Gernreich/trumpet-elbows-allowed/ends/README.md

# The bell and the mouthpiece

<!-- page-only <div style="display:flex;flex-wrap:wrap;gap:12px"><iframe src="../parts/bell/bell-round10-153mm-17rings-x3-rim86-turn.html?embed" title="The bell, 17 laminated rings flaring from a square throat to a round rim, as a solid you can drag to turn" style="flex:1 1 300px;height:480px;border:0"></iframe><iframe src="../parts/mouthpiece/mouthpiece-bore10-trumpet-parts-turn.html?embed" title="The mouthpiece, a stack of laminated rings from the cup down to the square bore, as a solid you can drag to turn" style="flex:1 1 300px;height:480px;border:0"></iframe></div> -->

Neither end is touched by the way a bore turns, so **only the tube belongs to an
instrument**. Both ends are stacks of laminated 3 mm rings, glued, since a ring
stack cannot be press-fit; each is glued to its bore too. Both close onto the
same 10 mm square in a 16 mm face, and every bore in this repository is on that
channel — so one bell and one mouthpiece serve all of them.

<!-- readme-only -->
**[Read this page](https://gernreich.github.io/trumpet-elbows-allowed/ends/)**

Both live in `../parts/` rather than inside any one instrument's folder, because
neither belongs to a single bore: what cuts them is not what fits them.

## The bell

**17 rings of 9 mm, 153 mm tall, a 10 mm square throat opening to a ø86mm round
rim** — ø80 of air. The section morphs square to round on the way up while
holding area, so the bore never steps in cross-section even though the shape of
it changes completely.

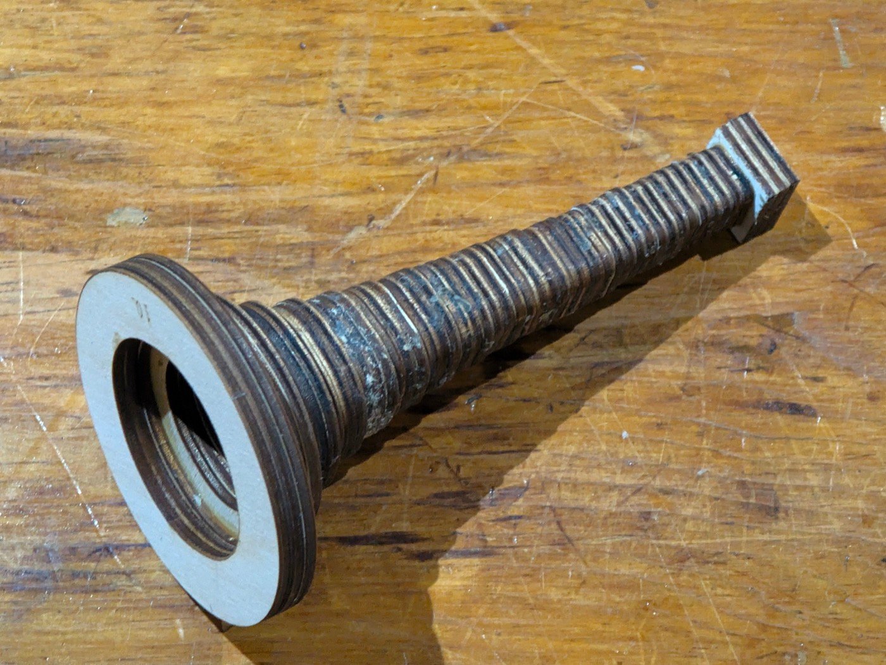
[picture p3: parts/bell/bell-round10-153mm-17rings-x3-rim86-built_web.jpg]
The bell as built, lying on a scratched workbench: a stack of laminated ply rings rising from a small square block at the throat, widening and rounding as it climbs to a flat round rim, every ring joint showing as a stripe up the side


That is the one on the instrument. The small square block is the throat — 10 mm
of air in a 16 mm face, which is a bore block exactly — and the flat disc is the
rim. Everything between them is the section changing from square to round while
holding area, three plies at a time.

**[Turn it →](../parts/bell/bell-round10-153mm-17rings-x3-rim86-turn.html)**
It turns at the top of the published page, and on a page of its own: drag to
rotate, and the slider stacks the rings one at a time, which is the useful part.

<figure>A 17-ring bell seen from above the rim: rings stacked and morphing from square at the throat to round at the rim, widening toward the viewer, the bore visible down the middle</figure>

Axial section of a 17-ring bell: the bore climbing one staircase and the outside another, wall between them

| | |
| --- | --- |
| rings | 17, each 3 laminations of 3 mm |
| height | 153 mm, built on a 152 mm profile |
| throat | 10 mm square |
| rim | ø86.0mm outside, ø80 of air |
| profile | Bessel horn, gamma 0.7 |
| sheet | 187 × 192 mm |
| pieces | 51 — the sheet goes through the machine three times |

**The bell is cut more than once.** The sheet draws every ring once, and the
`x3` in its filename is how many passes it takes. Cut it once and you get a
51 mm stub instead of a 153 mm bell.

Rings stack; they do not telescope. Each seats on the one below over 3.0 mm per
side. They are engraved in hex with `0` at the bore, and the generator writes
the numbering itself as the last step, with an orientation tick beside each
number — a numbering failure deletes the sheet rather than leaving an unnumbered
one to be cut.

```
cd parts/bell && ../../target/release/bell-round 17 --bore=10 --length=152 --mouth=80 \
    --out=cut-files/bell-round10-153mm-17rings-x3-rim86-cut-files.svg
```

A bare `bell-round.rs` writes four ring budgets, not one; the shipped sheet is
among them and comes back identical, the other three are scratch. Pass a budget
to write one.

### The adapter

A ported swept-curve bore leaves its cheek through a slot. Cut with `--port-square`,
as the built spiral was, that slot is a 10 mm square, the bell's own throat, and the
bell sits in it directly. Without it the port is **7 × 14 mm**, which cannot meet
this bell directly, and `bell-adapter.rs` draws the piece
that carries one into the other: **7 rings of one ply, 21 mm**, holding area
across the change on a smoothstep so both ends are tangent. The last ring is a
collar — 10 mm square in a 16 mm square face, which is the bore's own end face, so
the bell stacks on it unchanged.

```
cd parts/bell && ../../target/release/bell-adapter \
    --out=cut-files/bell-adapter-port7x14-to-bore10-7rings-x1-cut-files.svg
```

## The mouthpiece

**30 rings of 3 mm, 90 mm tall.** A 16 mm square plate at the instrument and a
ø23mm rim at the lip — ø17 where the lip actually sits — narrowing to a
**ø3.66mm throat** before the backbore. Full size on a quarter-size instrument,
which is the point of it.

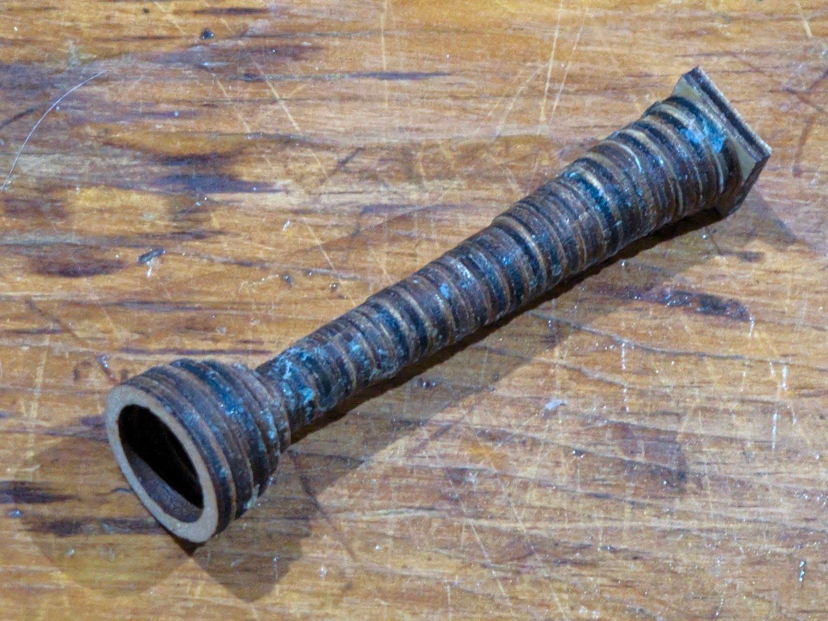
[picture p4: parts/mouthpiece/mouthpiece-bore10-trumpet-parts-built_web.jpg]
The mouthpiece as built, lying on a scratched workbench: a square block at one end, a long ring-stacked shaft narrowing to a waist, and a small cup opening at the other end, the ply laminations visible as rings along its whole length


The square block is what meets the bore; the cup is what meets the lip, and the
waist between them is the throat. **The staircase in that photograph is left as
it is.** Every ring is a 3 mm step, and the rim is the one part of the instrument
a player feels directly — this one meets a lip unsanded and unfilled.

**[Turn it →](../parts/mouthpiece/mouthpiece-bore10-trumpet-parts-turn.html)**
It turns at the top of the published page too, and on a page of its own the slider
stacks it a ring at a time.

<figure>The mouthpiece assembled from 30 rings, seen from above the cup: the cup narrowing to a throat, then the backbore opening slowly below it</figure>

Axial section of the 30-ring mouthpiece: the bore narrowing to the throat and opening again, the outside stepping the other way, wall between them

| | |
| --- | --- |
| rings | 30, each 1 lamination of 3 mm |
| height | 90 mm |
| layout | 26 backbore rings, 0 entrance rings, 4 bowl rings |
| at the instrument | 10 mm square aperture in a 16 mm square plate |
| throat | ø3.66mm |
| rim | ø23mm outside, ø17 at the lip |
| wall | 3 to 4.96 mm |
| sheet | 111 × 101 mm |
| pieces | 30 — one pass |

Station one is a **sharp** 10 mm square aperture in a **sharp** 16 mm square
plate, matching the bore corner for corner. The corners round away going up, and
the section is a true circle from the 9.026 mm station on, so the throat and the
whole cup are round.

```
cd parts/mouthpiece && ../../target/release/mouthpiece-round \
    cut-files/mouthpiece-bore10-trumpet-parts-cut-files.svg
```

**The staircase is not sanded or filled.** Thirty 3 mm rings make a 90 mm cone out
of thirty steps, and the lip is the one part of this instrument that can feel
every one of them — it is played that way, off the sheet and unfinished.

> The mouthpiece on the instrument that has been built is **24 rings, 72 mm** —
> not the 30 this sheet cuts. It is the instrument that is short, not the
> drawing.

## Every sheet is claimed

Both directories carry a `.repro` manifest naming the exact command that draws
each shipped SVG, checked by
[`repro-svg`](https://github.com/Gernreich/lasermade-tools/blob/main/src/bin/repro-svg.rs)
from lasermade-tools. It runs every command into a temp
path and compares the result byte for byte against the sheet on disk, so a sheet
the current code would not draw is caught rather than shipped. A sheet with no
command behind it is reported `UNCLAIMED`, which is why the manifest has to grow
whenever a drawing does.

## The bores these fit

**[the three-turn trumpet](../three-turn/)** — the one they are actually fitted
to — and the candidates:
**[the switchback trumpet](../switchback/)** · **[the greek spiral](../greek-spiral/)**,
plus every other bore in `../parts/bore/`, all of them on the same 10 mm channel.

## More, and licence

**[The trumpet writeup](https://gernreich.github.io/trumpet-elbows-allowed/)** — the idea, the notation, the gate, and the whole
library.

**[The rest of the build files](https://gernreich.github.io/lasermademusic.html)** — every
instrument, each with its own writeup.

Released under [CC0 1.0](../LICENSE).
