Gernreich/trumpet-elbows-allowed/greek-spiral/README.md

# The greek spiral

<!-- page-only <iframe src="../parts/bore/concept/walk/meander/greek-key/bore/bore.html?embed" title="The greek spiral bore: 68 blocks lying flat as a Greek key, winding in and back out beside itself, drawn as a chain of coloured blocks you can drag to turn" style="width:100%;height:560px;border:0"></iframe> -->

A trumpet bore drawn as a flat meander — the Greek key, wound in and brought
back out beside itself. **68 blocks, 1088 mm of centreline, one section, no
elbows and no contact.** It is the only lattice bore in this repository that
cuts as a single section — every other one splits into six, eight,
twenty-seven — because it is planar: there is nothing to fold, and no
section-to-section joint to seat square.

**It has been cut.** The bore is in ply and press-fit, not glued; neither end
is fitted yet, and it has not been blown.

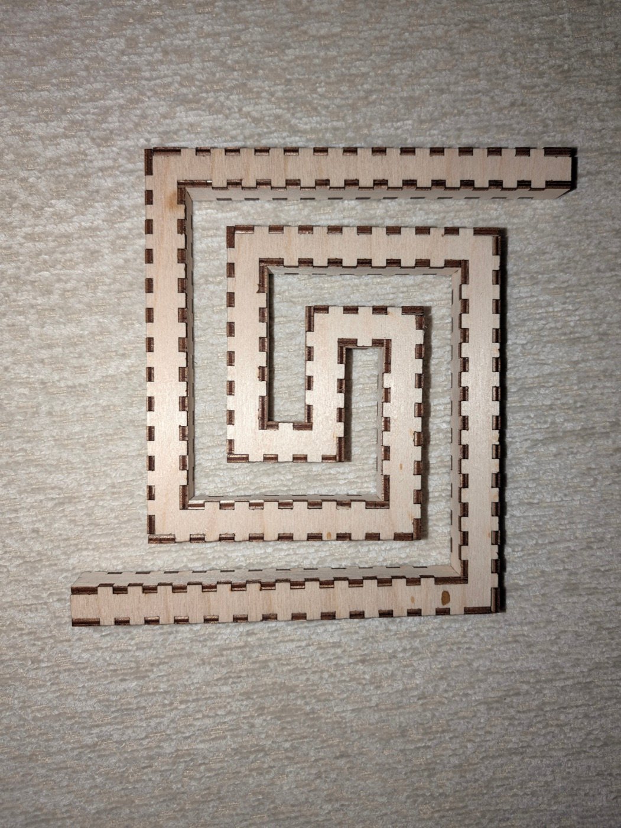
[picture p5: greek-spiral/greek-spiral-bore-built_web.jpg]
The greek spiral cut in birch ply and press-fit, lying flat: a square-section bore with its finger joints showing dark along every edge, winding in from the top right to a short bar at the centre and back out to the bottom left


<!-- readme-only -->
**[Read this page](https://gernreich.github.io/trumpet-elbows-allowed/greek-spiral/)**

**[Turn it →](../parts/bore/concept/walk/meander/greek-key/bore/bore.html)**
It turns at the top of the published page, and on a page of its own: drag to rotate, and
the slider reveals the bore a block at a time. Turn it edge-on and the whole
design is one block thick.

The walk laid out in Minecraft: sixty-eight translucent blocks lying flat as a Greek key, winding in to a short bar at the centre and coming back out beside itself, the runs coloured blue, purple, orange and green

*Screenshot from Minecraft. Minecraft is a trademark of Mojang Studios; this
project is not affiliated with Mojang or Microsoft.*

**The colours are the compass, not the cut order.** Everywhere else in this
project a coloured bore block says which section it belongs to; this bore has
only one section, so there is nothing for that to distinguish and the blocks are
coloured by the direction you are travelling instead — north, west, south, east.
Only four of the six appear, because the walk has no `U` and no `D` in it.

## The walk is the whole design

```
N10 W9 S6 E5 N2 W3 N2 E5 S6 W9 N10
```

The first term is the way you face at the mouth and how far you go before
anything turns; every term after it turns where you stand and then travels that
many blocks. So **the bore is 1 + the sum
of the numbers** — 67 + 1 = 68. Axes are Minecraft's: `U`/`D` are +Y/−Y, `N` is
−Z, `S` is +Z, `E` is +X, `W` is −X. There is no `U` or `D` in it at all, which
is the whole point: the walk never leaves its plane.

Read it out of `../tools/walks/greek_spiral.txt` rather than from here.

**It is a palindrome about its middle.** `N10 W9 S6 E5 N2` winds in, `W3` crosses
the centre, and `N2 E5 S6 W9 N10` comes back out — the same five legs in reverse.
That is what puts both openings on the outside of the figure rather than
stranding one of them at the eye, which is the failure a plain spiral has. It is
also what you are looking at in the pictures above: turned half a turn about the
middle of the short bar at its centre, the figure lands on itself, which is why
its two openings leave at opposite corners. It is not mirror-symmetric. The two
longest runs — the outer legs at either side — are the two `N10`.

## The numbers

| | |
| --- | --- |
| blocks | 68 |
| centreline | 1088 mm |
| sections | 1 |
| parts | 24, over 2 sheets |
| bounding box | 192 × 16 × 208 mm — 12 × 1 × 13 blocks |
| airway | 10 mm square, constant |
| block pitch | 16 mm — 10 mm of air in 3 mm walls |
| elbows | none; every turn is a bend |
| contact | none |
| legs | north 25, west 21, south 12, east 10 |

**A block is 16 mm, not 10.** Ten millimetres of sound space wrapped in 3 mm of
wall is 16 mm outside. A run of *N* blocks is 16*N* mm along the bore, which is
where 1088 comes from.

## One section is the whole design

Every other lattice bore here splits into several sections that couple
tab-into-notch. This one is planar, so it splits into one, and that changes
three things:

- **There is no assembly order.** Two sheets, one section. The `01of01` in the
  filename is not a sequence.
- **The seam clearance is inert.** The 0.025 mm per side that the 10 mm bore gets
  at a section joint has nothing to apply to here, because there is no
  section-to-section joint. Do not cite the switchback's measured play as
  evidence about this bore.
- **Both ends are plain**, not just one. On a one-piece bore the first piece's
  entry and the last piece's exit are the same piece, so it carries both marks
  and the filename says `-buttin-buttout-`.

A change that makes this design split into more than one section has changed the
walk, not the toolchain. Check the walk first.

**Nothing is engraved.** The other bores write a section number on every part in
blue before black cuts. Here the number would read `1` on all twenty-four parts
and answer a question nobody can ask, so black is the only colour on the sheet.
Marking each wall with its own length would name the stick and nothing else:
the plate carries no matching mark, and the one that would complete it cannot
be derived. The plate is the jig: a wall of length *L* fits only the
run of length *L*.

## Two sheets, and one of them nearly fills the bed

| sheet | parts | size |
| --- | --- | --- |
| 1 of 2 | 13 | 592.0 × 284.4 mm |
| 2 of 2 | 11 | 539.8 × 92.5 mm |

Sheet 1 is **1684cm²**, second by area only to the closed 52-block loop's
1778cm² sheet, with 8.0 mm to spare on a
600 mm bed. It is not the widest — the double volute's narrow panels reach 598.9 mm, and
width is what runs out first. The gate's
`sheet fits the bed` check passes everything up to 600.0, and the nester may
split differently rather than failing, so compare the reported sheet sizes after
any change and do not assume two sheets stays two.

## The cut files

In `../parts/bore/concept/walk/meander/greek-key/bore/cut-files/`,
both named for the same single section:

```
bore10-meander-greek-key-01of01-bend-DDDDDDDDDDLLLLLLLLLUUUUUURRRRRDDLLLDDRRRRRUUUUUULLLLLLLLLDDDDDDDDDD-buttin-buttout-cut-files-sheet1.svg
bore10-meander-greek-key-01of01-bend-DDDDDDDDDDLLLLLLLLLUUUUUURRRRRDDLLLDDRRRRRUUUUUULLLLLLLLLDDDDDDDDDD-buttin-buttout-cut-files-sheet2.svg
```

The long middle is the flattened shape of the whole snake — sixty-eight letters
of `D`, `L`, `U` and `R` saying which way the plate turns at each block, with
`~a~b` collapsed into the `-buttin-buttout-` that says both ends are plain.
Every file is millimetre-true at 1 user unit = 1 mm.

## Rebuild it

The generator is `bore_split`, which `cargo build --release` at the repository
root builds into `target/release/`; both commands run from the repository root.
Report only, writing nothing:

```
target/release/bore_split "N10 W9 S6 E5 N2 W3 N2 E5 S6 W9 N10" --bore=10 --no-write
```

Writing rewrites both sheets and gates them:

```
cd tools && ../target/release/bore_split \
    walks/greek_spiral.txt --bore=10 \
    --write ../parts/bore/concept/walk/meander/greek-key/bore
```

This walk is in the regression corpus — `regress` names it *greek spiral* and
gates it at `--bore=10` on every toolchain change, so a change that broke it
would be caught.

## The two ends

Only the tube belongs to an instrument. Neither the mouthpiece nor the bell is
touched by the way a bore turns, and every bore here is on the same 10 mm
channel, so one of each serves all of them —
**[the bell and the mouthpiece](../ends/)**.

## More, and licence

**[The three-turn trumpet](../three-turn/)** — the bore that plays, press-fit
and blown, rather than a candidate.

**[The trumpet writeup](https://gernreich.github.io/trumpet-elbows-allowed/)** — the idea, the notation, the gate, and the whole
library.

**[The rest of the build files](https://gernreich.github.io/lasermademusic.html)** — every
instrument, each with its own writeup.

Released under [CC0 1.0](../LICENSE).
