Gernreich/trumpet-elbows-allowed/bores/coiled/README.md

# Coiled trumpet

A trumpet bore in 10 × 10mm square section that **coils flat and drops twice**, built from
eight box sections with **no elbows at all** — every turn happens inside a section, so
every joint is a flat face glued to a flat face. Companion to the
[octagonal trumpet](https://github.com/Gernreich/trumpet/tree/main/octagonal) and the
[octagonal torus](https://github.com/Gernreich/trumpet/tree/main/octagonal), which stayed on
the 25 × 25mm channel this bore was first cut at. Cut from 3mm Baltic birch plywood,
millimetre-true at
`1 user unit = 1mm`, so it prints and cuts at real size.

The **bell** and the **mouthpiece** live in
**[trumpet-parts](https://github.com/Gernreich/trumpet/tree/main/parts)**, shared with the
[octagonal trumpet](https://github.com/Gernreich/trumpet/tree/main/octagonal). Neither is touched by
the way the bore turns, so only the tube belongs to an instrument.

The bore was designed **in Minecraft**, laid out block by block and coloured by direction —
which is where the notation comes from, and why the axes match the game's: `U`/`D` up and
down, `N` away from the noon sun, `E`/`W` along the sunrise.

<p>
The bore built in Minecraft from translucent coloured glass blocks, each run a different colour: long blue runs heading north, a green run east, an orange run south, purple runs west, and short grey and red columns where the bore drops and climbs
</p>

*The same walk, built in glass. Each colour is one direction, the same palette the viewer
uses — so a run's colour tells you which way it goes.*

<p>
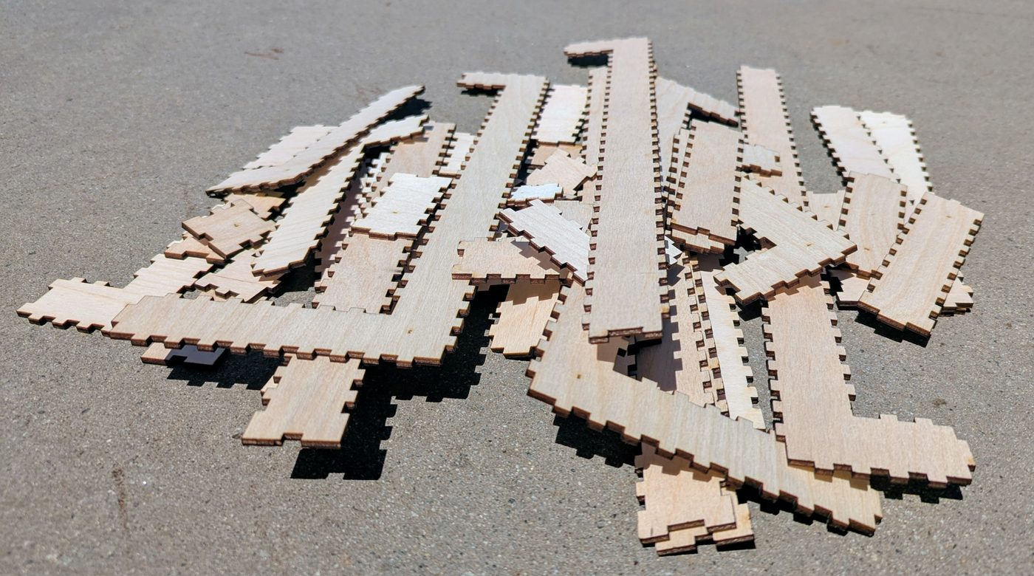
[picture p8: bores/coiled/bore/trumpet-coiled_parts_web.jpg]
The cut bore parts loose on concrete in sunlight: fifty flat plywood plates, every edge combed with finger joints, most of them long straight strips and several stepped into L and Z shapes where a section turns

</p>

*The whole bore, cut and not yet glued — 50 plates across 8 sections. **This photograph is
of the 25mm build**, which is what was cut before the bore moved to 10mm on 2026-09-05; the
shapes are the same and the plates are the size the old block gave. Click it for the
full-size photograph. **Every edge is a
finger joint and every face is flat.** The stepped pieces are where the bore turns: a
section carries its own corner, so nothing here is an elbow.*

<!-- readme-only -->
**[Read the writeup](https://gernreich.github.io/trumpet/bores/coiled/)** — the same text as
this page, set for reading, with a table of contents.

**[Turn the bore around in your browser](bore/bore.html)** — drag to rotate,
colour it by direction or by section, and step through the blocks one at a time.

Built for **[LaserMadeMusic](https://www.youtube.com/@LaserMadeMusic)**, where the cutting
and the playing are shown.

**[Download the whole repository as a ZIP](https://github.com/Gernreich/trumpet/archive/refs/heads/main.zip)**
— every trumpet, not this one alone; the nine bore nets and the page they
regenerate from are under `bores/coiled/`. GitHub builds it from `main` on every push, so it is never out of date.

**[The rest of the build files](https://gernreich.github.io/)** — every instrument,
generator and tool, indexed.

## Why no elbows

An **elbow** is a single block that turns. It sounds like the cheap way to bend a bore and
it is the expensive one, because its opening frame has **three sides, not four**. The
missing side has to be made up by the sections either side of it: both get a flattened
plate to butt-glue against, both need a tongue to locate on, and a 3 × 3 × 25mm void is
left unfilled inside the corner. Flat-to-flat gluing is the whole difficulty of building
one of these, and every elbow adds three more of the worst kind.

Turning the bore *inside* a section costs nothing extra to cut and glues like any other
seam. So this design pays in blocks to buy zero elbows — and the price turns out to be
small.

## The design is one line

```
N N3 U6 W5 N10 E5 D3 S8 W3 D3 N12 N
```

The first letter is the way in, the last is the way out, and each term between them turns
where you stand and then travels *n* blocks. The bore is **1 + the sum of the numbers** —
59 blocks, 944mm of centreline.

That single line is the entire specification. It is stored in the viewer page, and the cut
files regenerate from it.

## One block is 16mm, not 10

A block is 10 × 10 × 10mm of sound space wrapped in **3mm of wall**, so its outside is
16mm. Coring it out for the bore to pass through does not shrink it — the four walls stay
and the block still takes up 16mm. **A run of N blocks is 16N mm long.**

## When a turn is free, and when it costs

A section can carry a turn internally only if it has a straight block on each side of the
corner that its neighbours have not claimed. That gives one rule, and it has to be checked
over **every window of three consecutive terms**:

> Take the window as outer *A*, middle *m*, outer *C*. If *A* and *C* run along the **same
> axis in the same direction** the turn is a **step** and *m* may be **1**. If they run
> along the **same axis opposed**, it is a **hairpin** and *m* must be **2 or more**. If
> they name **three different axes**, it is a **coil** and *m* must be **3 or more**.

Steps are free, hairpins nearly so, coils are not. The moment a third axis joins in the
middle leg needs three blocks — one arm each side and the corner between them.

This document said until 2026-08-29 that any window on only two axes was "a fold" costing
nothing at any spacing. That holds for a step but not for a hairpin: `U3 N1 D3` buys two
elbows where `U3 N2 D3` buys none. It makes no difference to the walk below, whose only
two-axis window is a hairpin around a leg of ten, but it would to a tighter one.

For this walk:

| window | axes | verdict |
| --- | --- | --- |
| `N3 U6 W5` | three | middle 6 — fine |
| `U6 W5 N10` | three | middle 5 — fine |
| `W5 N10 E5` | two, opposed | hairpin, middle 10 — fine |
| `N10 E5 D3` | three | middle 5 — fine |
| `E5 D3 S8` | three | middle 3 — the minimum |
| `D3 S8 W3` | three | middle 8 — fine |
| `S8 W3 D3` | three | middle 3 — the minimum |
| `W3 D3 N12` | three | middle 3 — the minimum |

Three legs sit exactly on the floor of 3. Shorten any of them and an elbow appears.

## The sections

Eight sections, cut as nine files — section 3 does not fit one sheet of the bed and comes
as two.

| # | blocks | in → out | plate | parts | sheet |
| ---: | --- | --- | --- | ---: | --- |
| 1 | 1–5 | N → U | 2 × 4 bl | 6 | 521 × 151mm |
| 2 | 6–11 | U → W | 2 × 5 bl | 6 | 583 × 182mm |
| 3 | 12–26 | W → E | 4 × 11 bl | 8 | 482 × 288 + 556 × 96mm |
| 4 | 27–31 | E → D | 4 × 2 bl | 6 | 498 × 127mm |
| 5 | 32–34 | D → S | 2 × 2 bl | 6 | 403 × 86mm |
| 6 | 35–42 | S → W | 2 × 7 bl | 6 | 505 × 285mm |
| 7 | 43–45 | W → D | 2 × 2 bl | 6 | 403 × 86mm |
| 8 | 46–59 | D → N | 2 × 13 bl | 6 | 522 × 247mm |

**50 flat parts**, every one engraved with its section number, because the sections only go
together in one order. Sheets are sized for a 600 × 308mm bed.

The section names describe the shape as a run of moves across the flat plate —
`08_bend_LDDDDDDDDDDDD` is one step left and then twelve down — so a file name and
the part it cuts are the same description.

## Cutting

**Colour is the cut order**, shared across all these repositories: **blue engraves, black
cuts.** Blue lays the section number onto every part first and black frees it. Nothing
here uses the middle stages.

Standard settings, and they must stay uniform across the set — mixing `burn` changes finger
joint fit while every outside dimension still matches, which no drawing shows:

```
blocksize 16mm   thickness 3mm   burn 0.1   spacing 0.5   inner corners: corner
```

## Regenerating

The walk lives in the viewer page, so the page is a complete record of the design and the
cut files come back from it alone:

```sh
cd ../../tools
python3 bore_split.py ./bore/bore.html \
    --write ./bore
```

That rewrites every file in this directory and runs the full gate as it goes — 253 checks
on this design, none failing. To try a change without writing anything:

```sh
python3 bore_split.py --no-write "N N3 U6 W5 N10 E5 D3 S8 W3 D3 N12 N"
```

The generator is [bore-generator](https://github.com/Gernreich/trumpet/tree/main/tools), which
builds the nets on top of **boxes.py** (Florian Festi, GPL 3.0,
<https://www.festi.info/boxes.py/>).

## Files

**The bore**, in `bore/` — eight nets, one per section:
`bore10-coiled-01of08-bend-DDDR-buttin-cut-files.svg`,
`bore10-coiled-02of08-bend-UUUUL-cut-files.svg`,
`bore10-coiled-03of08-bend-LLLDDDDDDDDDDR-cut-files.svg`,
`bore10-coiled-04of08-bend-RRRD-cut-files.svg`,
`bore10-coiled-05of08-bend-LU-cut-files.svg`,
`bore10-coiled-06of08-bend-UUUUUUL-cut-files.svg`,
`bore10-coiled-07of08-bend-LD-cut-files.svg`,
`bore10-coiled-08of08-bend-LDDDDDDDDDDDD-buttout-cut-files.svg`.
At 25mm the third section needed two sheets and there were nine; at 10mm it fits on one.
`bore.html` sits beside them and holds the walk they are generated from.

The bell, the mouthpiece and their section drawings are in
[trumpet-parts](https://github.com/Gernreich/trumpet/tree/main/parts).

Released under [CC0 1.0](LICENSE).

Bore nets are generated by
[bore-generator](https://github.com/Gernreich/trumpet/tree/main/tools) on top of
**[boxes.py](https://www.festi.info/boxes.py/)** by **Florian Festi** (GPL 3.0),
`burn=0.1`, blocksize 16mm. The bells, the mouthpiece and the text are CC0.
