Gernreich/trumpet-elbows-allowed/parts/bore/concept/README.md

# Bore designs

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

<!-- readme-only -->
**[Read the writeup](https://gernreich.github.io/trumpet/parts/bore/concept/)** — the same text as this
page, set for reading, with a table of contents.

**[The rest of the build files](https://gernreich.github.io/)** — every instrument,
generator and tool, indexed.

Built for **[LaserMadeMusic](https://www.youtube.com/@LaserMadeMusic)**, where the cutting
and the playing are shown.

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

**The bore being built is the coiled trumpet:**
`N N3 U6 W5 N10 E5 D3 S8 W3 D3 N12 N` — 59 blocks, 944mm,
8 sections, **no elbows anywhere**. Its cut files and writeup are in
[trumpet-coiled](https://github.com/Gernreich/trumpet/tree/main/parts/bore/concept/walk/no-elbows/coiled). Everything below is how
that design was arrived at, starting from a first trumpet that used elbows and worked out
what they cost.

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

The walk it is all built from, and [the bore to turn around](walk/elbows/first_trumpet/first_trumpet.html):

```sh
cd ../../../GIT/bore-generator
W="N N10 U2 W2 S7 U2 E4 N9 W2 D2 N4 N"

python3 bore_split.py --write walk/elbows/first_trumpet "$W"   # the eight sections
python3 nest.py "$W" --out nest.svg                # the same parts nested
python3 nest.py "$W" --deepnest dn.svg             # for Deepnest/SVGnest
python3 bore_render.py "$W"                                   # the 3D view
python3 check.py "$W" --files walk/elbows/first_trumpet        # cut nothing until it passes
```

## The first trumpet bore

The design this all started from, and **not** the one being built — it turns with elbows,
which is what the rest of this page goes on to price. Compare it against the
[coiled trumpet](walk/no-elbows/coiled), which does the same job with none.

[`N N10 U2 W2 S7 U2 E4 N9 W2 D2 N4 N`](walk/elbows/first_trumpet/first_trumpet.html) — 45 blocks,
720mm of centreline. **Every walk on this page is a link**: follow one and the bore
opens in a page you can turn around with the mouse, colour by direction or by section,
and step through block by block.

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

## When a turn costs a section

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

Everything about how a design splits follows from that.

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

| walk | axes | cost |
| --- | --- | --- |
| `N N3 U1 N3 U1 N3 N` | y and z only | 1 section, 0 elbows |
| `N N3 U2 N3 U2 N3 N` | y and z only | 1 section, 0 elbows |
| `N N3 U3 N3 U3 N3 N` | y and z only | 1 section, 0 elbows |

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

| walk | axes | cost |
| --- | --- | --- |
| `N N3 U1 E3 U1 S3 S` | all three axes | 7 sections, 4 elbows |
| `N N3 U2 E3 U2 S3 S` | all three axes | 5 sections, 2 elbows |
| `N N3 U3 E3 U3 S3 S` | all three axes | 3 sections, 0 elbows |

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

| walk | pieces | elbows | blocks | parts |
| --- | --- | ---: | ---: | ---: |
| `N N4 U1 E4 E` | straight, elbow, elbow, straight | 2 | 10 | 16 |
| `N N4 U2 E4 E` | straight, elbow, L | 1 | 11 | 14 |
| `N N4 U3 E4 E` | L, L | 0 | 12 | 12 |
| `N N4 U4 E4 E` | L, L | 0 | 13 | 12 |

### Writing it

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

| fragment | axes |
| --- | --- |
| `E E2 U3 S6` | east, up, south |
| `W W2 N3 E8` | west, north, east |
| `S S7 E3 U7` | south, east, up |

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

`E E1 U3 S1 S`

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

| fragment | why | cost |
| --- | --- | --- |
| `W W7 N2 U11` | x, z, y — all different | **1 elbow**, in every context |
| `W W7 N3 U11` | the middle widened to 3 | 0 elbows, two 11-block Ls |
| `U U3 W4 N2 E8` | two turns only | 0 elbows, the search has slack |

`W9 N2 U9` is the unlucky shape: both turns leave the plane, so they need an arm
each, and the two-block leg has one straight block to give. One turn takes it,
the other is left bare. The nine-block legs either side do not help - the
problem is between the turns, not outside them - and no context rescued it:
alone, mid-walk, with a turn before, with a turn after, always one elbow. `N3`
makes it two 11-block Ls for 31mm more bore.

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

| walk | what it is | cost |
| --- | --- | --- |
| `W W1 N2 E1 E` | the fragment on its own | one 5-block bend, no elbows |
| `U U4 W1 N2 E1 U4 U` | the same fragment in a walk | 7 sections, **4 elbows** |
| `U U4 W3 N2 E3 U4 U` | the two ones widened | 3 sections, no elbows |

The middle one costs four elbows because of the windows it forms, not the fragment:

| window | axes | middle | cost |
| --- | --- | ---: | --- |
| `U4 W1 N2` | three axes | 1 | an elbow |
| `W1 N2 E1` | a fold | 2 | fine |
| `N2 E1 U4` | three axes | 1 | an elbow |

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

| design | elbows | flats | tongues | voids | parts |
| --- | ---: | ---: | ---: | ---: | ---: |
| [first trumpet](walk/elbows/first_trumpet/first_trumpet.html) | 3 | 6 | 0 | 3 | 44 |
| [spiral trumpet](walk/elbows/spiral_trumpet/spiral_trumpet.html) | 3 | 5 | 1 | 2 | 68 |
| [telescope spiral](walk/elbows/telescope_spiral/telescope_spiral.html) | 11 | 18 | 2 | 9 | 106 |
| [wide telescope](walk/no-elbows/wide_telescope/wide_telescope.html) | **0** | 0 | 0 | 0 | 72 |
| [metre spring](walk/no-elbows/metre_spring/metre_spring.html) | **0** | 0 | 0 | 0 | 36 |
| [**coiled trumpet**](walk/no-elbows/coiled) — the one being built | **0** | 0 | 0 | 0 | 50 |

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

Two other ways a turn becomes an elbow:

* **A turn in the last block of the bore.** There is nothing after it to make
  it interior, so it is always its own piece. `N N5 U`
  is 6 blocks in **2** pieces; `N N5 U1 U` is 7
  blocks in **1**. One block further along the bore costs a file fewer.
* **A bed split** landing on a turn, if the piece would otherwise be too big.

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

## How big a piece can be

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

## What a walk is checked for

Four layers, and the first three are automatic:

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

### The build is the check; the notation is what goes wrong

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

*The [coiled trumpet](walk/no-elbows/coiled) as built, floating in open sky with
nothing else in frame. Every block is coloured by the way you travelled to reach it —
**N blue, S orange, E green, W purple, U red, D grey** — the same palette the viewer and
the renders use, so a build and a drawing can be compared at a glance.*

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

`N N3 U3 W5 N10 E5 S8 W3 S3 N12 N` is the example. It
was refused, and the build it came from was fine — the fault was a single letter in the
transcription, an `S3` where the build turned `D3`, and no amount of adjusting the
*lengths* fixed it because the fault was a direction. Read the walk back off the page
rather than off your memory of the build.

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

    cd ../../../tools
    python3 mcwalk.py "N N3 U3 W5 N10 E5 S8 W3 S3 N12 N" \
        --out /tmp/doubled_walk.html --title "..."

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

## Before cutting

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

## Turning one around

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

The direction colours are the ones the bore gets built in first:

    up     red        down   grey
    north  blue       south  orange
    east   green      west   purple

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

The stepped coil and the switchback ramp are worth reading together. The [stepped coil](walk/elbows/stepped_coil/stepped_coil.html) is
`U1 W1 S2 E2` six times over and costs 116 parts for 40 blocks; the
[switchback ramp](walk/no-elbows/switchback_ramp/switchback_ramp.html) is the same idea with every leg widened,
`U2 W3 S3 E3`, and costs 132 parts for 91. Same
family, less than half the parts per block, because a leg of one block forces
a standalone elbow and a leg of three does not.

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

    python3 viewer.py "<walk>" --out ../../../test<name>.html --title "<Name> Bore"

## A sheet for airtightness testing

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

## Loose pages

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

| walk | blocks | sections | elbows | why it is kept |
| --- | ---: | ---: | ---: | --- |
| `E E8 U3 S8 S` | 20 | 2 | 0 | the three-block minimum on its own: two long runs and the shortest leg that still turns without an elbow |
| `U U3 W3 N2 E1 E` | 10 | 2 | 0 | the smallest walk that ends on a single block, which is where the splitter used to strand a turn |
| [`U U1 W1 S2 E2` × 6](walk/elbows/stepped_coil/stepped_coil.html) | 40 | 26 | 18 | six loops marching diagonally, every leg as tight as it goes |
| [`U U2 W3 S3 E3` × 8](walk/no-elbows/switchback_ramp/switchback_ramp.html) | 91 | 17 | **0** | the same idea with every leg widened: eight hairpins climbing |
| [the tightest coil](walk/elbows/tightest_coil/tightest_coil.html) | 22 | 20 | 18 | single-block legs throughout — 20 sections for 22 blocks, the worst ratio here |
| a Hilbert cube with an eight-block riser | 138 | 48 | 24 | the densest walk here, with the exit taken up and clear of the cube |

The snorkel's walk is 60 terms and does not fit a table cell, so here it is
in full:

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

Released under [CC0 1.0](LICENSE).
