Gernreich/trumpet-elbows-allowed/tools/NOTES.md

# Bore toolchain notes

The reasoning, history and measurements behind the rules in `CLAUDE.md`,
which states them short. When the two disagree, fix both.

**Nothing here is cut at two pitches.** Every design is on the 16 mm block - 10 mm of
air inside 3 mm walls - so `regress` names one `coil fold2` design rather than two,
and `sizes` writes no page that is kept. Notes below about a design held at two
sizes describe machinery that still works and currently has nothing to show.

**A design naming a folder that is not there fails.** Without that it falls through to
a geometry-only run and still says pass, on a design whose sheets are not where it
says they are. `check`'s empty-folder guard cannot catch it, because that fires
on a folder which exists and is empty.

This file provides guidance to Claude Code (claude.ai/code) when working with code in this repository.

## What this is

The bore toolchain: a walk through a lattice of blocks goes in, per-piece laser
cut files come out, and every one of them is checked before you cut. Unlike its
sibling repositories this **is** a software project — it ships no cut files of
its own, only the thing that makes them.

It produces every bore under **`../parts/bore`**, all of them candidates, and one of the
two bores under **`../built`** — the three-turn trumpet's. The spiral beside it is a swept
curve and comes from `ribbon_bore.rs`. It depends on nothing in `octomino-snakes`, which
enumerated the 369 octominoes and is archived and private: a live instrument should not
need a frozen repository to rebuild its parts.

**The writeup is `README.md` at the repository root**, with a page each for the bores
beside it. It carries the geometry — why a stranded turn's opening frame has three sides, what a
lap closes, how the notation splits into pieces. This file covers only how to work on the
code.

## Where things are

The sources are flat in `tools/`, one level below the repository root. That is
deliberate: it puts them at the same depth `octomino-snakes/generator/` had, so every
relative path came across unchanged. They were Python scripts until 2026-11-08 and are the
`trumpet` crate now (`../Cargo.toml`), its programs built into `../target/release/`.

    ../parts/bore/concept   the design library - candidates, not instruments
    ../parts/bell           the two ends, shared by every bore
    ../parts/mouthpiece
    ../built                the instruments that exist, one folder each

`bore_split` given neither `--write DIR` nor `--no-write` writes to `../../test`, beside
the repository rather than in it; every real run names its folder.

## The dependency graph

    bore.rs       <- every program: the walk, the split, the sheets
    snakebox.rs   <- bore.rs, check.rs, piece_render.rs
    geom.rs       <- bore.rs, check.rs
    assemble.rs   <- check.rs
    check.rs      <- bore.rs (--write), check_main.rs
    viewer.rs     <- bore.rs (--write), viewer_main.rs, coils.rs, sizes.rs
    render.rs     <- bore_render_main.rs, mcwalk.rs, viewer.rs
    designs.rs    <- regress.rs, repro.rs

Until 2026-11-08 `snakeboxvar.py` was not standalone: it installed into a Boxes.py
checkout, which supplied the finger joints, burn compensation and SVG writer, and
`bore_split.py` shelled out to that checkout's `scripts/boxes` once per piece. A
second copy was installed there, and a gate had to ask whether the two still
matched. `snakebox.rs` is the generator and those parts of Boxes.py together, in
Rust, compiled into every program that draws: one copy, nothing installed, and the
paths it draws are the ones Boxes.py drew, to the byte, over 608 recorded calls,
with one deliberate change since ([The stub Boxes.py drew]).

**Boxes.py is Florian Festi's**, GPL-3.0-or-later, at
<https://github.com/florianfesti/boxes>.

**Four files here are GPL-3.0-or-later, not CC0**, and say so in a header:
`snakebox.rs`, a port of Boxes.py code and so derived from it, and `check.rs`,
`check_main.rs` and `piece_render.rs`, written against it (their Python had
imported SnakeBoxVar at module level). Boxes.py grants no linking exception, so a
program that links `snakebox.rs` is a GPL work as built, whatever its own sources
say. `LICENSE.GPL-3.0.txt` beside them is that licence; `LICENSE` is the CC0
covering everything else in this directory. A new file that ports Boxes.py code
joins the list -- give it the header.

Nothing this produces is affected: a cut file is geometry, carrying no Boxes.py
code or metadata, so the sheets stay CC0.

**There is one generator, and it is `SnakeBoxVar`.** The simpler `snakebox.py` — no
variable cell widths, no ports, no laps, no plain ends — is not part of this toolchain:
`snakebox.rs` ports only `SnakeBoxVar`, and `bore_split`, `check` and `piece_render` all
draw through it.

## The stub Boxes.py drew

`polygonWall` takes `thickness × tan(45°)`, 3 mm, off each edge that meets an
inside corner, and draws that 3 mm separately. A plain border 2 mm long, the
step beside a pin end or a turn's corner, has 2 − 3 = −1 mm left: the turtle
went back 1 mm, then forward 3. It ended at the right point, but the path
doubled back on itself, and the laser cut that 0.93 mm stub (after burn) as a
nick past the corner. There were 320 of them, two per face plate, on 103 live
sheets. SolidCraft's round trip found them on 2026-11-09: a solid cannot
carry a line of no width, so `sc-flatten` redrew every face plate of the
built coil without them and `sc-compare` showed 0.93 mm against the
committed sheets. Since 2026-11-09 such a border is drawn as one straight
line when it runs back more than 0.1 mm (`STUB`). The bar is not zero because a
border exactly as long as its allowance is common, and the SolidCraft design
fits each outline point as a linear function of the sizes by nudging them: a
rule that changed at zero put a kink there and stopped 19 of its 20 designs. The only change to each sheet is that stub's vertex, removed. The six
pinned `coil-10x10x30-1.5t/as-cut/` sheets keep their stubs, because the wood was cut that way.
Two sets `repro` does not redraw kept theirs until the full round trip of every
design found them the same evening: `square-rise3`'s four plate sheets (16), now
byte for byte what `bore_split` draws for its page's walk, and the tight coil's
bed sheet `bore10-coil-tight-sheet1of1.svg` (64), packed by the Python
bed_sheets before the port and not redrawn, since today's packing differs; only the stub
vertices were taken out of it. No other committed sheet runs back on itself.

## The switches must reach the gate

`--ports` and `--flat` were module globals in the Python, and run as a script
`bore_split.py` was `__main__` while `check.py`'s `import bore_split` loaded it a second
time with its own globals — so a switch set on `__main__` reached the writer and not the
gate, and `--ports --write` wrote ported cut files, gated the *unported* design, and
reported a clean run on parts nothing had looked at. In Rust every switch is a field of
the one `Design` the writer holds, and `--write` passes that same `Design` to the gate.
If another switch is added, put it on `Design`, and never let a code path reach the gate
with a fresh `Design::default()`.

**The bore's outer ends are plain.** `plain_ends()` always marks the first piece's entry
and the last piece's exit, not just the openings that meet a port. Nothing couples there —
the mouthpiece and the bell each seat a flat plate against the end face, and a proud tab holds
it off. It gives an end section its own shape where it would otherwise share one with an
inner section (`BDL` -> `BDL~a`, `01_bend_DL.svg` -> `01_bend_DL_buttin.svg`), and a
rename like that **orphans the old file**, which nothing deletes for you. `check_sheets`
then globs the folder and gates the orphan too, at three checks a sheet, so a folder with
stale files in it reports more checks than its design has. **A check count that rises
after a rename is a warning.**

**The tab is floored at the finger tooth, and the notch carries the play.** Both are
failures the gate cannot see. A `--pin_width` that scales with the block while the finger
teeth do not (Boxes.py sizes those at `2 x thickness`) puts a 4.8 mm seam tab against 6 mm
teeth at the 10 mm bore — the narrowest feature on the sheet, where it should be the
strongest. A `--pin_play` of 0 draws the notch exactly the tab's width, and section 1 will
not enter section 2. `pin_width()` floors at the tooth and caps at `MIN_SHOULDER`, and
`pin_play()` returns 0.025 per side out of `PLAY_BY_BORE`. Both are in
`Design.common`, so `check` sees the same geometry.

The gate did not catch either. Its floor is `MIN_FEATURE`, 1.5 mm, which 4.8 clears
comfortably, and nothing compares a feature against the other features beside it or checks
that a joint has any clearance at all. **A passing gate means no check failed, not that the
part is buildable.**

**`--play` overrides the table, and it is for measuring, not for cutting.** `PLAY_BY_BORE`
is a lookup of what has actually been cut — one row, 0.025 per side at the 10 mm bore — and
a bore that is not in it gets 0.025 too, the safe direction, saying on stderr that it is
guessing. The comment above the table sets out the coupon that would settle whether the
requirement is absolute or a fraction of the tab;
`--play` is what cuts it, at values nobody has measured, without editing the table to say
they have. Whatever fits, add the row and stop passing the flag.

It is the same hazard as `--blocksize` and it bit the same way: the generator's argument
list (`COMMON` in the Python, `Design.common` now) is built once, so `set_play()` has to
rebuild it. Until it did, the three coupons came out
byte-identical — which reads as *play makes no difference* and is really *the flag is not
connected*. The tell was that the difference should have been visible and exactly the play:
it is, now, at every notch edge of section 1, and section 2 does not move at all, because
the play comes off the notch and never off the tab.

`--blocksize` is the same hazard with a quieter failure. It is two numbers, not one:
`Design.block`, the pitch the plan is laid out on, and `--blocksize` in `Design.common`,
the pitch SnakeBox cuts to. Both come from `set_blocksize()`, and `common` is built by
`make_common()` from the fields rather than typed out, so there is one copy of that list
and not a second place to forget.

A design folder is usually just `bore/`, and may sit under a size folder as `<size>/bore/`
— so a page title climbs past any ancestor that only names a size or says "bore" until it
reaches one that names the design. `coil/fold2/bore` reads "Coil Fold2 Bore" rather
than "Bore", and would still read that under a `10mm/` level.

`check --files` never looks at the pitch: it checks the written sheets for bed fit,
overlaps and engraving on material, all of which a folder cut at one pitch passes when
the gate is told another.
The pitch decides the *geometry* half of the gate, which is recut in-process. Gate a folder
at the wrong blocksize and it reports its full check count and 0 failed on a design nobody cut.

## One viewer, one bore or several

`viewer::build_sets(&[(label, walk, data), ...], title)` is the only page builder. `build()` is it
with a single item, and a single item hides the selector, so a per-bore page is what it
always was. `sizes` passes two and writes one page holding a design at both the block
sizes it is cut at.

A gallery is **more sets in the same viewer**, not a second viewer: two templates drift,
and the drawing code is the part most easily got wrong.

Anything derived from `D` has to be rebuilt when the set changes — `occAll` and `centre`
both are, and a stale `occAll` hides faces the new set has no neighbour for. The switch
**keeps** the camera, which is the point of a switch: you are comparing two shapes, and you
cannot compare them if the view jumps every time you swap.

**The scale is locked to the biggest set, and the cells are drawn in millimetres.** Two
things have to be true before the comparison means anything:

- `data_for` emits **lattice** positions, because occupancy and adjacency need a lattice.
  If the pitch reaches the caption and nothing else, two different pitches draw as the
  same picture — literally the same, the two `cells` lists comparing equal. The data
  carries `u`, the millimetres per step, and `rotC` scales by it.
- A set that fits itself to the canvas normalises away exactly what a size control exists
  to show. `draw()` takes its **scale** from the reference set and its **position** from
  the set on screen, so the small one is small and still centred.

**Every page carries the mouthpiece and the bell** (2026-10-14). `ends_json()` reads
their ring stacks out of their cut files with `../parts/part-view.rs`, and the page
seats the mouthpiece on the IN face and the bell on the OUT face, each first ring flat
on the block's end and its axis along the face's outward normal — a rotation, never a
reflection. Their faces go into the same depth-sorted list as the blocks', and the fit,
the centre and the reference set's scale all include them while they are shown, so the
bell is never cut off. A button takes them off. Redrawing either part changes every
page, and the repro gates say so.

Together those make the smaller pitch draw smaller in exact proportion, and the ¾ coil at
just under half the 3-turn. Change one without the other and the page silently goes back to lying.

**`rot()` scales millimetres, so anything that is a direction must not go through it.**
`shade()` takes a face normal and its dot product with the light as a number in `[-1, 1]`.
Rotate that normal with `rot()` like a position and it is multiplied by the block size,
driving the dot product to ±16 and clamping every face to pure white or pure black. Use
`rotC(p, centre.c, 1)` for a direction. `regress` cannot see it — it gates geometry, and
a page whose every face is white is geometrically perfect. **Screenshot the page after any
change to the drawing code**; nothing that reads the file will catch this class.

## bore_split's guards

Twenty-two of them, each given inputs it should refuse. **Nearly all hold.** A
stray character, a walk that reverses instead of turning, a walk too short to
have a direction, a bare letter at either end -- the entry and exit headings the
notation used to carry -- a walk that revisits a cell, a run of zero length, a
one-cell piece that is not a cube, a notch narrower than its own play, a notch
that leaves no ply beside it, and, under `--refuse-elbows` only, a walk that strands a turn as a one-block piece
-- every one refuses, with a message naming the block or section at fault.

**A guard that does not fire has not been tested until you know your input
reached it.** Two of these are easy to probe wrongly: the notch guards sit behind
a code path a walk without a notched joint never reaches, and the stranded-turn
refusal needs `--refuse-elbows` and a walk that actually strands one — `N3 U1 E3` does.

**`--bore` and `--blocksize` are two spellings of one number** -- `set_bore()`
calls `set_blocksize(bore + 2t)` -- so the pair is refused unless the two agree.
Applied in order unconditionally, `--bore` would silently overwrite
`--blocksize`: `--bore=30 --blocksize=16` would cut 49 mm blocks and report them
as though asked for.

**Not guarded:** a run of absurd length (`N9999`) builds until it hangs
rather than refusing. Nothing guards the total block count.

## check, against artefacts it should reject

The method: hand the gate something wrong and see whether it says so.

**Effective.** *no two parts overlap* and *engraving on material* both fire when
one part is dragged on top of another. *bore volume matches the walk* is sound
by construction, and the comment above it says why: the expected volume is
computed here, from the walk, and must never be refactored to call
`bore_split.extent()`, because a check that shares its source with the thing it
checks is comparing something to itself.

**The folder is compared with the walk.** *the sheets are this walk's sections*
reads `-NNofMM-` out of every filename, and requires MM to be the section count
this walk splits into and NN to run 1..MM with none missing. Every other check
passes on a folder missing a sheet, and on a folder holding another coil's
sheets entirely; `seen > 0` catches only the empty one. In a repository whose
whole claim is that the cut file IS the design, that the sheets in front of you
belong to the bore you asked for is the thing the gate most needs to say.

**Untested this way**, and worth the same treatment before being trusted: the
checkers in `lasermade-tools` — `doc-audit` and `flat-part-check`
especially, since both are used to clear work for publication.

## The ply is 3.0 and the kerf 0.15

`SHEET` is 3.0 and `KERF` 0.15, matching `ribbon_bore.rs` in the swept-curve repository. `THICKNESS`
is 3.0 as well and is what dimensions the lattice; `SHEET` reaches only the slot
Boxes cuts for a sheet to pass through. They are two numbers that happen to
agree, so moving `SHEET` moves no airway.

**`KERF` here is the full width and `BURN` is the radius Boxes wants.** The
paragraph above the constant says so twice, in both directions, because the two
are easy to swap.

**An `old/` inside `cut-files/` is invisible to `repro`**, which lists `.svg`
and ignores directories, so a superseded sheet archived beside a design never
disturbs the gate. Every `old/` is gitignored: they sit on the working disk, a
fresh clone does not carry them, and no gate can see them.

**`coil-10x10x30-1.5t/as-cut/` holds the only sheets here that describe an object
rather than an intention.** Six pins in `as-built.sha256`; `repro` redraws every
`cut-files/`, that folder's included (since 2026-11-12), and holds these 6 frozen. Redrawing it SHOULD differ, and that
difference failing the gate is the entire point of the mechanism. Pinning a
redrawn sheet would claim it records wood when it does not.

## A page turns back into cut files

`walk_text()` reads the walk out of `<div class="walk">` and allows attributes on
it, because every page this repository writes emits `<div class="walk" id="walk">`.
That is the route the design notes describe — *the walk is stored in the
page … the cut files regenerate from it and nothing else*.

**One design has no other route.** `square-rise3` keeps its walk **only** in a
page: `regress`'s `DESIGNS` carries a walk as a string for every other
design, and it is also the one with `cut-files/` that no `DESIGNS` entry claims,
so `repro` does not look at it either. A break in the page route is invisible
everywhere except there. It used to be two; `flat-drop` was the other, and was
deleted 2026-09-14.

## Never regenerate what you cannot check

`regress` runs the full gate over every design in `walks/` and the design
library. It is the only reason any of this stays honest, it takes about four
minutes, and **it must pass before anything is pushed**:

```sh
../target/release/regress       # every design in DESIGNS
```

A change that alters cut geometry and still passes has not been proved right —
it has been proved not obviously wrong. Say which it is.

## Standing decisions

**Every turn folds into a bend wherever it can, at any cost in pieces.** An
elbow -- a turn stranded as its own one-block piece -- has an opening frame with
three sides rather than four, so both neighbours need flattened plates
butt-joined to it, plus tongues, plus an unfilled void in the corner. Flat-to-flat
joints are the difficulty of the whole build. `FOLD_TURNS` biases the split
toward folding and is always on, so a walk that splits bend-only in trumpet-elbows-not-allowed
splits identically here. Only a turn that cannot fold becomes an elbow.

**Elbows are allowed by default; `--refuse-elbows` turns the refusal back on.**
`REFUSE_ELBOWS` is False. With the switch, it raises before a single file is
written, naming the sections at fault, and exits 1 -- what trumpet-elbows-not-allowed says to the
same walk:

    error: --refuse-elbows: sections 2, 3 of 4 are elbows. Nothing written.
    Lengthen the term between the turns: a hairpin needs 2 and a coil 3.

It is one of the design switches, so `check`, `nest` and `regress`
accept it too -- but **`check` does not consult it**, and `regress` runs
`check`. The corpus mixes bend-only designs with designs that cut elbows --
the five restored on 2026-10-06, the helices, the solid corner walks, both coils,
both Hilbert cubes, corner to corner and the double spiral among the latter. **A
green `regress` is not evidence that a walk would be cuttable in trumpet-elbows-not-allowed**;
`--refuse-elbows` on the command line is.

**The piece kind is `elbow`** in the cut list, in file names (`-elbow-NE-`), in
`bore_render`, and in the field the coil search reads (`kinds.elbow`, kept
as `elbows` in `parts.json`). trumpet-elbows-not-allowed renamed it `stranded` on 2026-09-15; this
copy renamed it back, and checked that the search scripts count 3 in
`meander/first` rather than silently reading 0.

**Respelling them is not the fix either, and this was measured rather than
assumed.** Raising every interior term to its window minimum does make nine of
the twelve fold — but `helix, rise 1` and `helix, rise 2` both become
`N4 U3 E4 U3 S4 U3 W4 U3 N4`, the same walk, so two cases collapse into one;
`tightest coil` goes 22 blocks to 47 and is not tightest; `hilbert cube 1` goes
8 to 15 and a 2x2x2 needs unit steps, so it is not the cube. Their names are
their parameters. The tenth, `double spiral`, cannot be respelled at all — the
raised walk runs block 20 into block 10.

**The test bore was the exception and it has been respelled**, on 2026-09-15.
`U2 E2 S2 U2` stranded its middle turn; it is `U1 E3 S3 U1` now — nine blocks,
three bends, same shape, same piece count. Its name was never a parameter, so
nothing was lost. It also settles a second thing: `examples/.repro` drew
`U1 E2 S2 U3` under the same name, so two different nine-block walks were both
"the test bore". Both draw `U1 E3 S3 U1` now.

Probe the guard through the command line, never through the corpus:

    ../target/release/bore_split "N3 U1 E3" --no-write                  # 2 elbows, exits 0
    ../target/release/bore_split "N3 U1 E3" --no-write --refuse-elbows  # refuses, exits 1

The long ones are in the corpus for the opposite reason: `hilbert open` (190
blocks, 27 pieces), `metre spring`, `4 corners, flat` and the trumpet candidate
split bend-only at a size where a change that started stranding turns would show
up -- here as elbows in the cut list, and as a refusal under `--refuse-elbows`.

**What a turn costs is set by the window of three consecutive terms around it**,
outer A, middle m, outer C — checked over every window, not once per walk.
Consecutive terms are always on different axes, which leaves three cases:

| A and C | case | m must be |
| --- | --- | ---: |
| same axis, same direction | step | >= 1 |
| same axis, opposite direction | hairpin | >= 2 |
| different axes | coil | >= 3 |

Steps are free; hairpins are not — the distinction is the one most easily lost.
Probed with `--no-write`; every one that cuts elbows here is refused under
`--refuse-elbows`:

    N3 U1 N3   step      folds          N3 U1 E3   coil   2 elbows
    N3 U1 S3   hairpin   2 elbows       N3 U2 E3   coil   1 elbow
    N3 U2 S3   hairpin   folds          N3 U3 E3   coil   folds

`bore_split` is the authority on this, not this file and not a
reimplementation of the rule.

**A walk that revisits a cell is refused.** The cells are the air path, so a cell
filled twice is a junction with two ways out and no box section has an opening in
four sides. **Trust the build and suspect the transcription**: the design is laid
out in Minecraft floating in open space, where a section running into an earlier
one is plainly visible, so a refusal usually means the walk was written down
wrong — and a wrong direction before a wrong length. `mcwalk` draws a refused
walk under permissive rules and lights up every cell entered more than once,
which the ordinary viewer cannot do.

## Colour is the cut order

Shared across these repositories: **blue engraves, then green → orange → cyan →
black**; black frees the part; **violet `#8000ff` means skip**. Bore nets use two
stages — blue engraves the section number, black cuts.

## Cut files belong to the author

Output lands in other people's repositories. `--write` rewrites **every** file in
the directory it is given, so ask before pointing it at one that has cut files in
it, and never at a directory holding hand-nested or hand-edited work.

## Publishing

Pages deploys from `main` through `.github/workflows/pages.yml`, keyed per commit.
`index.html` is `README.md` rendered by `md2html` and committed, not built on the
server, so a stale `index.html` publishes stale content — regenerate it after editing the
README, and read the audit before pushing:

```sh
~/LaserMadeMusic/GIT/lasermade-tools/rebuild-page.sh ..          # the root README and its page
```
