Gernreich/trumpet-elbows-allowed/torus/Octagonal_Torus_Gold.md

# Octagonal_Torus — parametric, 90mm radius, 25 × 25mm cross-section

Complete record: the trigonometry, the generator, and the verified cut list.

**All dimensions are millimetres.**

**Worked example:** an octagonal torus with a 25.000 × 25.000mm square cross-section, outer octagon
at R 90, cut from 3mm Baltic birch plywood. Verified cut file: **[`BuildA1_90_25.svg`](BuildA1_90_25.svg)**,
reproduced end to end from Route A —
[note on the violet lines in it](#note--the-violet-lines).

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

**A drawing, not a photograph — and the uncut torus.** This is what the finished ring
measures out to: computed by [`torus-3d-view.js`](torus-3d-view.js) from the same three
numbers Part 11 takes, so it cannot drift from the geometry described here. It shows the
object assembled from [`BuildA1_90_25.svg`](BuildA1_90_25.svg) and stopped there. The
photograph still to come shows the next step, after the cut along the
[violet lines](#note--the-violet-lines) that turns it into the simple trumpet.

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

```
R_outer  >  (ring + 2 × thickness) × sec(180°/n)
```

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

```
node torus-geometry-diagram.js 90 25 3
                               │  │  └─ material thickness
                               │  └──── the ring you want, face to face
                               └─────── outer octagon radius, corner to centre
```

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

```
$ node torus-geometry-diagram.js 120 30 6
outer octagon  R 120      apothem 110.866   wall out to 116.866   (run 1)
inner octagon  R 81.034   apothem 74.866    wall out to 80.866    (run 2)
hole cutter    R 74.54    (run 3 — invert this disc)
ring           110.866 − 80.866 = 30
outside flats  233.731   bore flats 149.731
```

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

**It draws a picture; it does not make cut files.** For parts, use Route A.

---

# PART 0 — Build it

## Get the files

- **[`BuildA1_90_25.svg`](BuildA1_90_25.svg)** — the cut file. On GitHub use the ⤓ *Download raw
  file* button; clicking the name only previews it.
- **[The whole repository as a ZIP](https://github.com/Gernreich/trumpet/archive/refs/heads/main.zip)**
  — the cut file, this writeup, the diagram and the verification tools are under
  `torus/`; the trumpets are beside them.
- **[The torus directory](https://github.com/Gernreich/trumpet/tree/main/torus)** — every file named below lives here.

---

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

Assembled: **25.000mm radial × 25.000mm axial**, 172.298 across the flats outside, 110.298 bore.

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

## The video

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

## Route A — generate from scratch at boxes.hackerspace-bamberg.de

Three runs, because the plate hole and the inner panels come from **different radii**.

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

→ Keep **both discs** and all **8 panels**.

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

→ Keep the **8 panels** only. Discard its discs.

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

→ Keep **one disc**; it is the cutter for both plates. Discard everything else.

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

### How the inversion was done

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

Flipping a segment does two things at once, and Part 8 is about both:

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

**This process is demonstrated step by step in the [video](https://www.youtube.com/@LaserMadeMusic).**

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

### The three runs as links

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

### Why run 3 uses 56.446 and not 59.693

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

```
56.446  →  disc at apothem 52.149 / 55.149
invert  →  lands at 55.149 / 58.149   ✓ exactly where the hole belongs
```

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

## Route B — shortcut, cut the finished file

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

**Two things before you send it**, both immediately below: the violet lines are not part of
the torus, and the four cut colours have to run in the right order. Do those and the file cuts
as-is — no scaling, no kerf compensation, no edits.

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

### Note — the violet lines

**They are not part of the torus.** The file carries 24 violet paths alongside the 20 cut contours,
and they are all one family: **12 on each of the two plates**. Each is a single straight line from the hole edge out to the
rim — apothem 55.2 to 83.2 on the plates, whose fingers stand proud of that line, and 55.2 to 86.2
on the rings, which have none — so together they divide each wall into sixteen segments. None
overruns its octagon.

They are the optional cuts. Take them and the torus comes apart into sections, which is how you
reach the simple trumpet; the segments they define are also the patches for joining sections back
together. Turn one green to cut it, and leave the rest violet.

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

↩ [back to the top](#octagonaltorus--parametric-90mm-radius-25--25mm-cross-section)

## Colour is the cut order

**Violet `#8000ff` is skip — it is never cut.** Everything else is, and the colour says *when*:

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

All four are explicit stroke colours, so select-same-colour finds each group and a colour-keyed job
lists all four. **Violet is the fifth colour in the file and takes no operation at all**: those 64
lines are the optional cuts across the plate walls, twelve per plate, which this build
does not make. Marking them explicitly is the point, so "not cut" is a decision recorded in the
drawing rather than a colour someone forgot to map.

**Blue is the piece numbers, and it engraves.** Blue means *engrave* across these repositories and
never cuts. From 2026-09-03 every one of the eighteen pieces carries a hex number in blue, written
by `number_pieces.js`, because the outer panels differ by 1.758mm and the inner ones by the same,
and off the bed they are a pile of near-identical rectangles. Give blue a marking operation, or
leave it unmapped and lose nothing but the numbers.

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

Eight of the sixteen panels are nested in the middle of the plate and ring holes, where they would
otherwise be waste, and so are the two square patches. That is what forces the sequence: **cut a
part while its material is still held.** Cut the orange hole first and the whole centre drops away,
taking the uncut pieces on it with it — into the machine, if you are unlucky. Holes before rims for the same reason: once the black rim is
through, the plate is loose and anything still to be cut in it will move.

So set your laser to run **green → orange → cyan → black**, and give every one of those four a
cutting operation. Leave violet unmapped, or delete it. A job set up per-colour silently skips any
colour you leave unmapped, which is a hazard for the four and exactly what you want for the fifth.

`verify_torus.js` checks all of this. It prints the palette, marks each colour counted or ignored, lists
the four in order with what each one is, and fails loudly if a nested panel is scheduled after the
hole it sits in, or a hole after its rim. It also counts the skip lines per octagon and checks that
none runs past that octagon's outer edge, so the sixteen claimed above are read out of the file
rather than asserted here:

```
  CUT ORDER
    1. green  x8   panels nested in the plate holes — cut before the waste is freed
    2. orange x2   plate holes
    3. cyan   x8   panels on the open sheet
    4. black  x2   plate rims — frees the plates
    tightest nested piece to its hole: 1.095mm  (31.2 x 48.372 panel in plate 1) — kerf comes off both sides of that
    8 nested panels and 0 patches cut before their hole ✓   holes before rims ✓

  SKIP LINES  (violet — carried, not cut)
    plate 0: 12 line(s), apothem 55.249 … 83.407   edge at 86.25
    plate 1: 12 line(s), apothem 55.249 … 83.407   edge at 86.25
    none reaches past its octagon's outer edge ✓
    every plate carries the same 12 ✓
```

## Before cutting the full sheet

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

## Check before cutting

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

## Tooling

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

```
node verify_torus.js BuildA1_90_25.svg RunA2_R59Point693.svg
```

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

**On the HTML:** `Octagonal_Torus_Gold.html` is generated from this markdown by a converter kept
outside the repo, which inlines `torus-geometry-diagram.svg` so the page stays self-contained.
**The markdown is the source — edits made directly to the HTML are overwritten on the next run.**

```
node torus-geometry-diagram.js 90 25 3      # outer R, ring, thickness
```

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

Everything below is why.

---

# PART 1 — Octagon trigonometry

A regular octagon has two "radii" that people constantly confuse:

- **R** (circumradius) — centre to a **vertex**
- **a** (apothem) — centre to the middle of a **face**

They are locked by the half-angle **180°/8 = 22.5°**:

```
a    = R × cos(22.5°)              cos(22.5°) = 0.923880
R    = a × sec(22.5°)              sec(22.5°) = 1.082392
side = R × 2sin(22.5°)             2sin(22.5°) = 0.765367
side = a × 2tan(22.5°)             tan(22.5°) = 0.414214 = √2 − 1
```

Closed forms:

```
cos(22.5°) = √(2+√2) / 2 = 0.923880
sec(22.5°) = 2 / √(2+√2) = 1.082392
tan(22.5°) = √2 − 1      = 0.414214
```

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

---

# PART 2 — Nesting two octagons: the 1.0824 rule

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

```
gap = a_outer − a_inner = (R_outer − R_inner) × cos(22.5°)

ΔR / gap = sec(22.5°) = 1.082392
```

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

Two consequences that bite:

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

---

# PART 3 — Material: walls eat the gap

The octagons are *surfaces*. Material grows off them, and whether that costs you depends on
direction.

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

```
one wall intrudes  →  nominal gap = ring + wall = 25 + 3 = 28
R_inner = R_outer − nominal × sec(22.5°)
        = 90 − 28 × 1.082392
        = 90 − 30.307
        = 59.693mm
```

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

---

# PART 4 — The generator

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

Settings used:

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

---

# PART 5 — Mapping generator terms to the geometry

This is the join between Parts 1–3 and the tool, and it is exact:

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

```
R_inner = R_outer − (ring + thickness) × 1.082392
```

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

And the axial 25 is not luck — it is `h = 25` typed in, with `outside` unchecked.

---

# PART 6 — Panel widths, derived

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

```
side = 2 × a × tan(22.5°)

long  panel = side + t√2          + 2·burn
short panel = side + 2t·tan(22.5°) + 2·burn
```

With t = 3.0 and burn = 0.1:

```
t√2 + 2·burn          = 4.2426 + 0.2 = 4.443
2t·tan(22.5°) + 2·burn = 2.4853 + 0.2 = 2.685
difference             = t(2 − √2)    = 1.757
```

Check against every panel measured across all files:

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

```
4.4426 = 2.4853 + 1.9574     2.6853 = 2.4853 + 0.2000
```

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

## 6a. Why a panel looks too wide for its octagon

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

A face of the octagon has **two lengths**, because the wall is a trapezoid in plan:

```
at the bore,          apothem 55.149:  2 × 55.149 × tan(22.5°) = 45.687
at the wall's outside, apothem 58.149: 2 × 58.149 × tan(22.5°) = 48.172
difference = 2t·tan(22.5°)                                     =  2.485
```

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

## 6b. The corner lap

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

---

# PART 7 — Why a torus forces an inversion

RegularBox makes a **box**. A torus needs its two rims facing opposite ways:

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

---

# PART 8 — What inversion actually does

Two things at once, and they must be handled separately.

## 8a. It shifts the part ±3mm

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

## 8b. It flips the phase — and that is the part that must be right

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

### Reading the phase from a file

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

```
RunA2 disc — what the inner panels key to
  OUT[-22.8…-15.0] OUT[-14.9…-9.1] OUT[-9.0…-3.0] OUT[-2.9…2.9] OUT[3.0…9.0] …

BuildA1 plate hole
  in [-22.9…-15.0] in [-14.9…-9.1] in [-9.0…-3.0] in [-2.9…2.9] in [3.0…9.0] …
```

**Same intervals, opposite lines = complementary = the plate's tabs land in the panel's notches.**

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

### If the phase comes out wrong

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

---

# PART 9 — How everything was measured

Every number here was extracted from path coordinates, not from CAD readouts.

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

Five pitfalls cost real time and are worth recording:

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

Plus: `id="..."` contains the substring `d="..."`, so a naive regex will match it and parse
nonsense.

---

# PART 10 — File record

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

Nothing else in the repository is a part:

| file | what it is |
|---|---|
| `verify_torus.js` | checks a cut file end to end — see [Tooling](#tooling) |
| `torus-geometry-diagram.js` | draws the figure at the top, and prints the three radii |
| `torus-geometry-diagram.svg` | that figure, regenerated by the script — do not edit by hand |
| `torus-3quarter-view.svg` | drawing of the finished torus, standing in until the photograph exists |
| `torus-3d-view.js` | draws it, from `R_outer`, `S` and `t` — the same three numbers as Part 11 |
| `Octagonal_Torus_Gold.md` | this document, and the source the HTML is built from |
| `Octagonal_Torus_Gold.html` | the generated page — edits to it are overwritten |
| `README.md` · `index.html` | repository front page, and the redirect that serves it on Pages |
| `LICENSE` | CC0 1.0 |
| `.gitignore` | keeps `.DS_Store` and `*.tmp` out of the repository |

## Final verification, `BuildA1_90_25.svg`

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

```
ring    = 83.149 − 58.149 = 25.000 ✓
axial   = 31.200 − 3.1 − 3.1 = 25.000 ✓   (as-drawn; nominally 31.000 − 3.0 − 3.0)
outside = 2 × 86.149 = 172.298
bore    = 2 × 55.149 = 110.298
phase   = interval pattern complementary to RunA2's disc ✓
order   = nested panels before their hole, holes before rims ✓
holes   = one stitched contour per plate
```

---

# PART 11 — Another size

**Self-contained.** Everything you need is here; nothing above is required reading.

Pick three numbers:

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

For an octagon, `n = 8`.

## 1. Get your three radii

```
node torus-geometry-diagram.js <R_outer> <S> <t>
                               │         │   └─ material thickness
                               │         └───── the ring you want, face to face
                               └─────────────── outer octagon radius, corner to centre
```

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

It prints them, labelled by run. Worked through with this build's numbers:

```
$ node torus-geometry-diagram.js 90 25 3
outer octagon  R 90       apothem 83.149   wall out to 86.149   (run 1)
inner octagon  R 59.693   apothem 55.149   wall out to 58.149   (run 2)
hole cutter    R 56.446   (run 3 — invert this disc)
ring           83.149 − 58.149 = 25
outside flats  172.298   bore flats 110.298
```

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

Or compute them yourself:

```
R_inner = R_outer − (S + t) × sec(180°/n)      ← run 2
R_hole  = R_inner − t × sec(180°/n)            ← run 3
```

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

## 2. Generate three boxes.py runs

At **<https://boxes.hackerspace-bamberg.de/>**, generator **RegularBox**. Identical settings each
time except the radius:

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

## 3. Invert run 3's disc

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

## 4. Build the plates

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

## 5. Dry-fit before cutting the sheet

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

## Parts you end up with

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

### The two stiffening rings

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

## Three things that will bite you

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

---

# The two rules

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
