Gernreich/trumpet-elbows-allowed/designs/index.html

theme

# Bore designs

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

The rest of the build files (https://gernreich.github.io/) — every instrument, generator and tool, indexed.

Built for LaserMadeMusic (https://www.youtube.com/@LaserMadeMusic), where the cutting and the playing are shown.

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

The walk it is all built from, and the bore to turn around:

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

## The first trumpet bore

The design this all started from, and not the one being built — it turns with elbows, which is what the rest of this page goes on to price. Compare it against the coiled trumpet, which does the same job with none.

N N10 U2 W2 S7 U2 E4 N9 W2 D2 N4 N — 45 blocks, 720mm of centreline. Every walk on this page is a link: follow one and the bore opens in a page you can turn around with the mouse, colour by direction or by section, and step through block by block.

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

## When a turn costs a section

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

Everything about how a design splits follows from that.

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

### Writing it

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

fragment | axes
... E4 U3 S4 ... | east, up, south
... W4 N3 E6 ... | west, north, east
... S9 E3 U5 ... | south, east, up

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

E E1 U3 S1 S

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

fragment | why | cost
... W9 N2 U9 ... | x, z, y — all different | 1 elbow, in every context
... W9 N3 U9 ... | the middle widened to 3 | 0 elbows, two 11-block Ls
... U5 W4 N2 E6 ... | two turns only | 0 elbows, the search has slack

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

The middle one costs four elbows because of the windows it forms, not the fragment:

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

design | elbows | flats | tongues | voids | parts
first trumpet | 3 | 6 | 0 | 3 | 44
spiral trumpet | 3 | 5 | 1 | 2 | 68
telescope spiral | 11 | 18 | 2 | 9 | 106
hilbert snorkel | 24 | 26 | 20 | 4 | 260
wide telescope | 0 | 0 | 0 | 0 | 72
metre spring | 0 | 0 | 0 | 0 | 36
coiled trumpet — the one being built | 0 | 0 | 0 | 0 | 50

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

Two other ways a turn becomes an elbow:

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

## How big a piece can be

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

## What a walk is checked for

Four layers, and the first three are automatic:

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

### The build is the check; the notation is what goes wrong

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

The coiled trumpet bore built in Minecraft from coloured glass, floating in open sky: long blue runs heading north, an orange run south, green east, purple west, and short red and grey columns where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

The coiled trumpet as built, floating in open sky with nothing else in frame. Every block is coloured by the way you travelled to reach it — N blue, S orange, E green, W purple, U red, D grey — the same palette the viewer and the renders use, so a build and a drawing can be compared at a glance.

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

## Before cutting

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

## Turning one around

Every design folder carries a page you can turn around with the mouse, named for the folder - first_trumpet/first_trumpet.html, spiral_trumpet/spiral_trumpet.html and the rest. Walks with no cut files have a page of their own instead; they are listed under Loose pages. Open one in a browser; nothing is installed and nothing is fetched but the fonts. Drag to turn, scroll to zoom, right-drag to pan, colour by direction or by section, click a legend row to isolate it, and drag the slider to follow the bore from the mouthpiece a block at a time.

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

The direction colours are the ones the bore gets built in first:

up     red        down   grey
north  blue       south  orange
east   green      west   purple

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

The walks with no cut files sit loose in the repository root, listed under Loose pages below.

The stepped coil and the switchback ramp are worth reading together. The stepped coil is U1 W1 S2 E2 six times over and costs 116 parts for 40 blocks; the switchback ramp is the same idea with every leg widened, U2 W3 S3 E3, and costs 132 parts for 91. Same family, less than half the parts per block, because a leg of one block forces a standalone elbow and a leg of three does not.

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

python3 viewer.py "<walk>" --out ../test/<name>.html --title "<Name> Bore"

## A sheet for airtightness testing

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

## Loose pages

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

walk | blocks | sections | elbows | why it is kept
E E8 U3 S8 S | 20 | 2 | 0 | the three-block minimum on its own: two long runs and the shortest leg that still turns without an elbow
U U3 W3 N2 E1 E | 10 | 2 | 0 | the smallest walk that ends on a single block, which is where the splitter used to strand a turn
U U1 W1 S2 E2 × 6 | 40 | 26 | 18 | six loops marching diagonally, every leg as tight as it goes
U U2 W3 S3 E3 × 8 | 91 | 17 | 0 | the same idea with every leg widened: eight hairpins climbing
the tightest coil | 22 | 20 | 18 | single-block legs throughout — 20 sections for 22 blocks, the worst ratio here
a Hilbert cube with an eight-block riser | 138 | 48 | 24 | the densest walk here, with the exit taken up and clear of the cube

The snorkel's walk is 60 terms and does not fit a table cell; it is on its own page, and in full here:

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

Released under CC0 1.0.
