Gernreich/trumpet-elbows-allowed/parts/bore/concept/walk/coil/search/index.html

theme

# Spirals

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

The one this started from is coil_4x4_50, which won a category and lives in a directory of its own; the ten came out of an exhaustive search for something tighter.

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

Built for LaserMadeMusic (https://www.youtube.com/@LaserMadeMusic), where the cutting and the playing are shown.

## Standardised

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

Standardising collapsed 30 walks into 10: several that looked different were the same coil in another orientation, and derived.txt records which. The hand reduction of the staircase coil, the tool's reduction of it, and the extension of the hand reduction all turn out to be one coil.

### The length rule, and why it is not a cap

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

## Shape and cost

spiral | blocks | mm | envelope | box | cross-section | along axis | pieces | distinct | period | rhythm | mean plate mm2 | touching
coil_3x3_54_2 | 169 | 2704 | 3 x 3 x 43 | 387 | 3 x 3 blk / 48 x 48 mm | 43 / 688 mm | 28 | 4 | 8 tm / 22 blk | 4 x7.0 | 2601 | 0
coil_3x9_18 | 167 | 2672 | 3 x 9 x 15 | 405 | 3 x 9 blk / 48 x 144 mm | 15 / 240 mm | 29 | 4 | 8 tm / 22 blk | 4 x7.3 | 2477 | 12
coil_3x8_20 | 172 | 2752 | 3 x 8 x 17 | 408 | 3 x 8 blk / 48 x 128 mm | 17 / 272 mm | 33 | 4 | 8 tm / 20 blk | 4 x8.3 | 2205 | 14
coil_3x3_59 | 174 | 2784 | 3 x 3 x 48 | 432 | 3 x 3 blk / 48 x 48 mm | 48 / 768 mm | 32 | 4 | 8 tm / 20 blk | 4 x8.0 | 2193 | 0
coil_4x7_20 | 172 | 2752 | 4 x 7 x 17 | 476 | 4 x 7 blk / 64 x 112 mm | 17 / 272 mm | 33 | 4 | 8 tm / 20 blk | 4 x8.3 | 2073 | 14
coil_4x8_18 | 166 | 2656 | 4 x 8 x 15 | 480 | 4 x 8 blk / 64 x 128 mm | 15 / 240 mm | 29 | 4 | 8 tm / 22 blk | 4 x7.3 | 2469 | 12
coil_5x7_18 | 167 | 2672 | 5 x 7 x 15 | 525 | 5 x 7 blk / 80 x 112 mm | 15 / 240 mm | 29 | 4 | 8 tm / 22 blk | 4 x7.3 | 2364 | 12
coil_4x9_18 | 182 | 2912 | 4 x 9 x 15 | 540 | 4 x 9 blk / 64 x 144 mm | 15 / 240 mm | 29 | 4 | 8 tm / 24 blk | 4 x7.3 | 2899 | 12
coil_3x4_68 | 169 | 2704 | 4 x 3 x 57 | 684 | 3 x 4 blk / 48 x 64 mm | 57 / 912 mm | 39 | 4 | 6 tm / 16 blk | 4 x9.8 | 1686 | 0
coil_3x4_79 | 187 | 2992 | 4 x 3 x 73 | 876 | 3 x 4 blk / 48 x 64 mm | 73 / 1168 mm | 42 | 4 | 8 tm / 17 blk | 4 x10.5 | 1894 | 0

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

Cross-section is the envelope with the coil axis taken out — how fat the coil is, which is what decides whether it fits inside anything. It is not implied by the box: coil_3x3_54_2 is 3x3 in section and coil_4x9_18 is 4x9, and the box does not say so.

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

rhythm = period terms x the share of turns that leave the plane

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

It is also the one packing number that is not implied by the box. Here the two agree: coil_3x3_54_2 has the smallest box in the set and no shared wall. They need not: coil_3x9_18 is only 5% larger and has 12 shared walls.

## Rotation

spiral | axis | rotation | turns | blocks/360 | rise/360 blk / mm | deg/block | 90deg turns | turns/m | longest straight
coil_3x3_54_2 | N | 2430 | 6.75 | 22.8 | 6.07 / 97 | 15.8 | 56 | 22.7 | 4 blk / 64 mm
coil_3x9_18 | N | 2700 | 7.50 | 21.3 | 1.87 / 30 | 16.9 | 58 | 22.7 | 4 blk / 64 mm
coil_3x8_20 | N | 3060 | 8.50 | 19.5 | 1.88 / 30 | 18.4 | 66 | 24.8 | 4 blk / 64 mm
coil_3x3_59 | N | 2790 | 7.75 | 20.6 | 6.06 / 97 | 17.4 | 64 | 25.0 | 3 blk / 48 mm
coil_4x7_20 | N | 3060 | 8.50 | 19.5 | 1.88 / 30 | 18.4 | 66 | 24.8 | 3 blk / 48 mm
coil_4x8_18 | N | 2700 | 7.50 | 21.3 | 1.87 / 30 | 16.9 | 58 | 22.7 | 4 blk / 64 mm
coil_5x7_18 | N | 2700 | 7.50 | 21.5 | 1.87 / 30 | 16.8 | 58 | 22.5 | 4 blk / 64 mm
coil_4x9_18 | N | 2700 | 7.50 | 23.3 | 1.87 / 30 | 15.4 | 58 | 20.7 | 4 blk / 64 mm
coil_3x4_68 | N | 3420 | 9.50 | 16.3 | 5.89 / 94 | 22.1 | 58 | 23.4 | 3 blk / 48 mm
coil_3x4_79 | N | 3780 | 10.50 | 17.0 | 6.86 / 110 | 21.2 | 83 | 29.1 | 3 blk / 48 mm

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

## What wins what

No single spiral wins, because the measures disagree.

| winner | against the walk this started from
smallest box | coil_3x3_54_2 — 387 | 688, so 1.78x larger
tightest spiral (least rise per turn) | coil_3x9_18 — 30 mm | 61 mm, so 2.0x slacker
least tube per turn | coil_3x4_68 — 16.3 blk | 15.8 blk, within -3%
fewest pieces | coil_3x3_54_2 — 28 | 43
fewest distinct shapes | coil_3x3_54_2 — 4 | 8
largest average plate | coil_4x9_18 — 2899 mm² | 1616 mm²
calmest bore (fewest turns/m) | coil_4x9_18 — 20.71 | 20.83
smallest box with no shared wall | coil_3x3_54_2 — 387 | 688, also 0 shared

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

## A metric deliberately left out

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

## Every block load-bearing

One walk in this set is a hand reduction of the staircase coil — blocks taken out wherever one could go without stranding a turn. (derived.txt maps every name here to the walk it derives from.) tools/minimal.rs checks the claim: a term's floor is 3 in a coil window, 2 in a hairpin, 1 in a step, and a walk whose every term sits on its floor cannot be shortened at all.

target/release/minimal           # every walk
target/release/minimal --terms   # and which terms have slack

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

### The reduction pass, and why minimality is not an optimisation

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

What those 9 reductions buy:

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

The reduced walks are kept, named *_min, with their sources recorded in derived.txt. They are in the scoring like anything else, so the composite is over a set that contains both a design and its own reduction — worth remembering when reading a rank, since the normalization is across whatever is present.

target/release/reduce            # the pass
target/release/reduce --write    # and reduced.json

## Walks kept but not scored

The scoring normalizes every metric across the set, so a walk of a different length does not merely rank oddly — it rescales everyone else. Those walks live in the repository and in the tables, below a rule, and are listed in unscored.txt with the reason. Their rate metrics — blocks/360, rise/360, turns/m, touching — stay comparable and are still worth reading.

## Scoring them against each other

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

## The gate

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

tools/run_checks.sh          # re-run the gate over every walk

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

## How they were found

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

That rule, for a window of three consecutive terms — outer A, middle m, outer C:

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

## The tools

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

Finding and shaping walks

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

Measuring and ranking

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

Producing what is committed

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

## The code

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

## The files behind the tables

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

## Regenerating

tools/build.sh               # all of the below, in order

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

target/release/spiral_metrics "$(cat walks/coil_3x3_54_2.txt)"   # measure one walk

../../../../../../target/release/viewer \
    "$(cat walks/coil_3x3_54_2.txt)" \
    --out pages/coil_3x3_54_2.html --title "coil 3x3 54 2"

## What has not been done

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

Released under CC0 1.0.
