Gernreich/trumpet-elbows-allowed/parts/bore/concept/walk/no-elbows/spirals/index.html

theme

# Spirals

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

The one this started from is coil_4x4_50; the other 16 came out of an exhaustive search for something tighter.

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

The rest of the build files (https://gernreich.github.io/) — every instrument, generator and tool, indexed.

Built for LaserMadeMusic (https://www.youtube.com/@LaserMadeMusic), where the cutting and the playing are shown.

## Standardised

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

### The length rule, and why it is not a cap

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

## Shape and cost

spiral | blocks | mm | envelope | box | cross-section | along axis | pieces | distinct | period | rhythm | mean plate mm2 | touching
coil_3x3_51 | 190 | 5890 | 3 x 3 x 46 | 414 | 3 x 3 blk / 93 x 93mm | 46 / 1426mm | 34 | 4 | 8 tm / 21 blk | 4 x8.5 | 2385 | 7
coil_3x7_22 | 181 | 5611 | 3 x 7 x 20 | 420 | 3 x 7 blk / 93 x 217mm | 20 / 620mm | 38 | 4 | 8 tm / 18 blk | 4 x9.5 | 1785 | 17
coil_3x8_20 | 181 | 5611 | 3 x 8 x 18 | 432 | 3 x 8 blk / 93 x 248mm | 18 / 558mm | 34 | 4 | 8 tm / 20 blk | 4 x8.5 | 2193 | 15
coil_3x9_18 | 177 | 5487 | 3 x 9 x 16 | 432 | 3 x 9 blk / 93 x 279mm | 16 / 496mm | 30 | 4 | 8 tm / 22 blk | 4 x7.5 | 2473 | 13
coil_3x3_54 | 177 | 5487 | 3 x 3 x 49 | 441 | 3 x 3 blk / 93 x 93mm | 49 / 1519mm | 30 | 4 | 8 tm / 22 blk | 4 x7.5 | 2601 | 0
coil_3x3_54_2 | 177 | 5487 | 3 x 3 x 49 | 441 | 3 x 3 blk / 93 x 93mm | 49 / 1519mm | 30 | 4 | 8 tm / 22 blk | 4 x7.5 | 2601 | 0
coil_3x3_59 | 181 | 5611 | 3 x 3 x 54 | 486 | 3 x 3 blk / 93 x 93mm | 54 / 1674mm | 34 | 4 | 8 tm / 20 blk | 4 x8.5 | 2193 | 0
coil_2x2_134 | 177 | 5487 | 2 x 2 x 126 | 504 | 2 x 2 blk / 62 x 62mm | 126 / 3906mm | 42 | 2 | 8 tm / 16 blk | 4 x10.5 | 1785 | 0
coil_4x7_20 | 181 | 5611 | 4 x 7 x 18 | 504 | 4 x 7 blk / 124 x 217mm | 18 / 558mm | 34 | 4 | 8 tm / 20 blk | 4 x8.5 | 2065 | 15
coil_4x8_18 | 177 | 5487 | 4 x 8 x 16 | 512 | 4 x 8 blk / 124 x 248mm | 16 / 496mm | 30 | 4 | 8 tm / 22 blk | 4 x7.5 | 2446 | 13
coil_5x7_18 | 177 | 5487 | 5 x 7 x 16 | 560 | 5 x 7 blk / 155 x 217mm | 16 / 496mm | 30 | 4 | 8 tm / 22 blk | 4 x7.5 | 2345 | 13
coil_4x9_18 | 193 | 5983 | 4 x 9 x 16 | 576 | 4 x 9 blk / 124 x 279mm | 16 / 496mm | 30 | 4 | 8 tm / 24 blk | 4 x7.5 | 2881 | 13
coil_5x8_18 | 193 | 5983 | 5 x 8 x 16 | 640 | 5 x 8 blk / 155 x 248mm | 16 / 496mm | 30 | 4 | 8 tm / 24 blk | 4 x7.5 | 3009 | 13
coil_4x4_50 | 193 | 5983 | 4 x 4 x 46 | 736 | 4 x 4 blk / 124 x 124mm | 46 / 1426mm | 45 | 8 | 16 tm / 48 blk | 12 x3.8 | 1598 | 0
coil_3x4_68 | 177 | 5487 | 4 x 3 x 63 | 756 | 3 x 4 blk / 93 x 124mm | 63 / 1953mm | 41 | 4 | 6 tm / 16 blk | 4 x10.3 | 1697 | 0
coil_3x4_79 | 188 | 5828 | 4 x 3 x 73 | 876 | 3 x 4 blk / 93 x 124mm | 73 / 2263mm | 43 | 4 | 8 tm / 17 blk | 4 x10.8 | 1878 | 0
coil_5x5_50 | 177 | 5487 | 5 x 5 x 46 | 1150 | 5 x 5 blk / 155 x 155mm | 46 / 1426mm | 45 | 8 | 16 tm / 44 blk | 12 x3.8 | 1412 | 0

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

Cross-section is the envelope with the coil axis taken out — how fat the coil is, which is what decides whether it fits inside anything. It is not implied by the box: coil_2x2_134 is 2x2 in section and coil_5x8_18 is 5x8, and the box does not say so.

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

rhythm = period terms x the share of turns that leave the plane

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

It is also the one packing number that is not implied by the box. coil_3x3_51 has the smallest box in the set and 7 shared walls; coil_3x3_54 is 7% larger and has none. If a shared wall is something to avoid, the smallest box is not the one to build.

## Rotation

spiral | axis | rotation | turns | blocks/360 | rise/360 blk / mm | deg/block | 90deg turns | turns/m | longest straight
coil_3x3_51 | N | 2970 | 8.25 | 21.6 | 5.45 / 169 | 16.7 | 68 | 12.3 | 4 blk / 124mm
coil_3x7_22 | N | 3420 | 9.50 | 18.0 | 2.00 / 62 | 20.0 | 76 | 14.3 | 3 blk / 93mm
coil_3x8_20 | N | 3060 | 8.50 | 20.0 | 2.00 / 62 | 18.0 | 68 | 12.9 | 4 blk / 124mm
coil_3x9_18 | N | 2700 | 7.50 | 22.0 | 2.00 / 62 | 16.4 | 60 | 11.7 | 4 blk / 124mm
coil_3x3_54 | N | 2610 | 7.25 | 22.8 | 6.62 / 205 | 15.8 | 60 | 11.7 | 4 blk / 124mm
coil_3x3_54_2 | N | 2610 | 7.25 | 22.8 | 6.62 / 205 | 15.8 | 60 | 11.7 | 4 blk / 124mm
coil_3x3_59 | N | 2970 | 8.25 | 20.6 | 6.42 / 199 | 17.5 | 68 | 12.9 | 3 blk / 93mm
coil_2x2_134 | N | 3690 | 10.25 | 16.4 | 12.20 / 378 | 22.0 | 84 | 16.1 | 3 blk / 93mm
coil_4x7_20 | N | 3060 | 8.50 | 20.0 | 2.00 / 62 | 18.0 | 68 | 12.9 | 3 blk / 93mm
coil_4x8_18 | N | 2700 | 7.50 | 21.9 | 2.00 / 62 | 16.5 | 60 | 11.8 | 4 blk / 124mm
coil_5x7_18 | N | 2700 | 7.50 | 22.0 | 2.00 / 62 | 16.4 | 60 | 11.7 | 4 blk / 124mm
coil_4x9_18 | N | 2700 | 7.50 | 24.0 | 2.00 / 62 | 15.0 | 60 | 10.8 | 4 blk / 124mm
coil_5x8_18 | N | 2700 | 7.50 | 24.0 | 2.00 / 62 | 15.0 | 60 | 10.8 | 4 blk / 124mm
coil_4x4_50 | N | 4050 | 11.25 | 16.0 | 4.00 / 124 | 22.5 | 60 | 10.8 | 3 blk / 93mm
coil_3x4_68 | N | 3600 | 10.00 | 16.3 | 6.20 / 192 | 22.1 | 61 | 12.1 | 3 blk / 93mm
coil_3x4_79 | N | 3780 | 10.50 | 17.2 | 6.86 / 213 | 20.9 | 84 | 15.0 | 3 blk / 93mm
coil_5x5_50 | N | 4050 | 11.25 | 14.7 | 4.00 / 124 | 24.5 | 60 | 11.7 | 3 blk / 93mm

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

## What wins what

No single spiral wins, because the measures disagree.

| winner | against the walk this started from
smallest box | coil_3x3_51 — 414 | 736, so 1.78x larger
tightest spiral (least rise per turn) | coil_3x7_22 — 62mm | 124mm, so 2.0x slacker
least tube per turn | coil_5x5_50 — 14.7 blk | 16.0 blk, within 9%
fewest pieces | coil_3x9_18 — 30 | 45
fewest distinct shapes | coil_2x2_134 — 2 | 8
largest average plate | coil_5x8_18 — 3,009 mm2 | 1,598 mm2
calmest bore (fewest turns/m) | coil_4x9_18, coil_5x8_18, coil_4x4_50 — 10.75 | 10.75
smallest box with no shared wall | coil_3x3_54 — 441 | 736, also 0 shared

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

## A metric deliberately left out

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

## Every block load-bearing

The staircase coil was reduced by hand — blocks removed wherever one could go without introducing an elbow — and that reduction is in this set. (The names below predate standardising, which renamed every coil; derived.txt maps them.) tools/minimal.js checks the claim: a term's floor is 3 in a coil window, 2 in a hairpin, 1 in a step, and a walk whose every term sits on its floor cannot be shortened at all.

node tools/minimal.js            # every walk
node tools/minimal.js --terms    # and which terms have slack

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

### The reduction pass, and why minimality is not an optimisation

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

What those 13 reductions buy:

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

node tools/reduce.js             # the pass
node tools/reduce.js --write     # and reduced.json

## Walks kept but not scored

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

## Scoring them against each other

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

## The gate

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

node tools/run_checks.sh     # re-run the gate over every walk

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

## How they were found

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

That rule, for a window of three consecutive terms — outer A, middle m, outer C:

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

## The files behind the tables

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

## Regenerating

tools/build.sh               # all of the below, in order

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

node tools/spiral_metrics.js "$(cat walks/coil_3x3_51.txt)"   # measure one walk

cd ../../../../../../tools            # rebuild a viewer page
~/boxes/venv/bin/python viewer.py "$(cat walks/coil_3x3_51.txt)" \
    --out pages/coil_3x3_51.html --title "coil 3x3 51"

## What has not been done

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

Released under CC0 1.0.
