Gernreich/trumpet-elbows-allowed/parts/bore/concept/walk/no-elbows/stretched/index.html

theme

# bore-stretched

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

N N1 W3 U2 E3 N3 D3 W2 U3 N1

It began as a test rather than an instrument, and the walk was borrowed from trumpet-switchback (https://github.com/Gernreich/trumpet/tree/main/parts/bore/concept/walk/no-elbows/switchback) rather than designed for a stretched lattice.

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

Built for LaserMadeMusic (https://www.youtube.com/@LaserMadeMusic), where the cutting and the playing are shown.

The rest of the build files (https://gernreich.github.io/) — every instrument, generator and tool, indexed.

The first of six sheets for the 1.5-turn coil: flat finger-jointed plates for one bend of a 10 × 10mm bore, each engraved with its number

bore10-coil-10x10x30-1.5t-01of06-bend-DL-buttin-cut-files.svg · 325.2 × 70.2mm sheet

## Why a turn has to be a cube

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

That is the whole design. Eight of the 22 blocks turn, so:

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

## Four coils, one walk truncated

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

folder | turns | blocks | centreline | sections | envelope
coil-10x10x30-0.75t | 0.75 | 11 | 274mm | 3 | 92 × 62 × 76mm
coil-10x10x30-1.5t | 1.5 | 22 | 548mm | 6 | 92 × 92 × 152mm
coil-10x10x30-2.25t | 2.25 | 33 | 822mm | 9 | 122 × 92 × 228mm
coil-10x10x30-3t | 3 | 44 | 1096mm | 12 | 122 × 122 × 304mm

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

Each folder also carries its own viewer: coil-10x10x30-0.75t.html, coil-10x10x30-1.5t.html, coil-10x10x30-2.25t.html and coil-10x10x30-3t.html.

Every sheet says which coil it belongs to and how many there are — a name runs bore10-coil-10x10x30-1.5t-01of06-bend-DL-buttin-cut-files.svg, so a file that has left its folder can still be placed, and a set with a sheet missing says so. The first section is the same shape in all four coils; only the last differs, since that is where each one stops: …-03of03-bend-RD-buttout-… at 0.75, …-06of06-bend-RD-buttout-… at 1.5, …-09of09-bend-LD-buttout-… at 2.25 and …-12of12-bend-LD-buttout-… at 3. Cut from one folder at a time.

The 1.5t is trumpet-switchback (https://github.com/Gernreich/trumpet/tree/main/parts/bore/concept/walk/no-elbows/switchback)'s walk exactly. It arrived here as a borrowed test before anyone noticed it was a coil — which is why its folder was called bore/ until the other two existed.

### Why four groups make three turns

Two rhythms run through this walk at once, and they are deliberately out of step:

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

Two consequences follow, and both show up in the table above:

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

### 0.75 turns — coil-10x10x30-0.75t/

# | file | sheet | parts

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

### 1.5 turns — coil-10x10x30-1.5t/

# | file | sheet | parts

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

### 2.25 turns — coil-10x10x30-2.25t/

# | file | sheet | parts

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

### 3 turns — coil-10x10x30-3t/

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

# | file | sheet

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

Sections 3 and 6 are the same shape, and 7 and 10; they are cut separately so each carries its own engraved number. coil-10x10x30-3t/coil-10x10x30-3t.html is its viewer, and ../../../../../../tools/walks/coil-3t.txt holds the walk.

cd tools
python3 bore_split.py --bore=10 --straight=30 --refuse-elbows \
    --title="10x10x30 Coil, 3 Turns" \
    "$(cat walks/coil-3t.txt)" --write ../../../../../../bores/coil-10x10x30-3t

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

## The three-turn coil plays at F4

The three-turn coil built and finished: a mouthpiece at the left, then the square-section bore folding back on itself three times in stepped plywood boxes with finger-jointed edges scorched dark by 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

Cut, glued, finished and played. 1096mm of 10 x 10mm bore, and it sounds F4.

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

## The mouthpiece and the bell

They are not in this folder. They already exist, though, and they fit. A coil's mouth is a 10mm square opening in a 16mm square face, which is exactly what the 10mm pair made for trumpet-switchback (https://github.com/Gernreich/trumpet/tree/main/parts/bore/concept/walk/no-elbows/switchback) seats onto — that mouthpiece's station one is a sharp 10mm square aperture in a sharp 16mm square plate, and the bell's flange covers the same face. Nothing about either depends on how long the bore behind it is, so one pair serves all four coils:

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

## The joint between sections

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

The size came from cutting it. Four goes, three of them wrong:

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

Every seam runs SLOT to TAB, and the two outer ends carry neither.

## The toolchain, and the fork that used to be here

tools/ here was a copy of the bore generator, changed to handle a lattice whose cells are not all the same length. It is not a copy any more. On 2026-09-05 the fork was collapsed: the generalised versions were promoted into ../../../../../../tools and the copy deleted, after checking that all 24 uniform designs passed on them with identical check counts and that the cut files regenerated byte-identical in geometry.

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

file | what it does
../../../../../../tools/bore_split.py | turns a walk into pieces and drives the generator
../../../../../../tools/snakeboxvar.py | the Boxes.py generator that draws one flat piece
../../../../../../tools/check.py | the gate: every check that runs before anything is cut
../../../../../../tools/assemble.py | voxels the assembled bore, for the seal and volume checks
../../../../../../tools/viewer.py | writes the 3D page beside the cut files, one coil or several
../../../../../../tools/coils.py | writes coils.html, every coil in one page
../../../../../../tools/bore_render.py | the colours and direction names the viewer uses
../../../../../../tools/svgpath.py | reads and writes the path data
../../../../../../tools/regress.py | runs the gate over every design, both lattices
../../../../../../tools/walks/coil-0.75t.txt | the 0.75-turn coil
../../../../../../tools/walks/coil-1.5t.txt | the 1.5-turn coil
../../../../../../tools/walks/coil-2.25t.txt | the 2.25-turn coil
../../../../../../tools/walks/coil-3t.txt | the 3-turn coil

cd ../../../../../../tools
python3 bore_split.py --bore=10 --straight=30 --refuse-elbows \
    --title="10x10x30 Coil, 1½ Turns" \
    "$(cat walks/coil-1.5t.txt)" --write ../../../../../../bores/bores/stretched/coil-10x10x30-1.5t

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

## What had to change, and what it cost

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

Three things moved with it:

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

## What the gate checks

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

## Colour is the cut order

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

## Licence

CC0 1.0 Universal. See LICENSE.
