Gernreich/trumpet-elbows-allowed/parts/bore/concept/walk/no-elbows/coil/search/index.html

theme

# Spirals

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

The rest of the build files (https://gernreich.github.io/) — every instrument, generator and tool, indexed.

Built for LaserMadeMusic (https://www.youtube.com/@LaserMadeMusic), where the cutting and the playing are shown.

## Standardised

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

### The length rule, and why it is not a cap

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

## Shape and cost

spiral | blocks | mm | envelope | box | cross-section | along axis | pieces | distinct | period | rhythm | mean plate mm2 | touching
coil_3x8_20 | 181 | 2896 | 3 x 8 x 18 | 432 | 3 x 8 blk / 48 x 128mm | 18 / 288mm | 34 | 4 | 8 tm / 20 blk | 4 x8.5 | 2193 | 15
coil_3x9_18 | 177 | 2832 | 3 x 9 x 16 | 432 | 3 x 9 blk / 48 x 144mm | 16 / 256mm | 30 | 4 | 8 tm / 22 blk | 4 x7.5 | 2473 | 13
coil_3x3_54_2 | 177 | 2832 | 3 x 3 x 49 | 441 | 3 x 3 blk / 48 x 48mm | 49 / 784mm | 30 | 4 | 8 tm / 22 blk | 4 x7.5 | 2601 | 0
coil_3x3_59 | 181 | 2896 | 3 x 3 x 54 | 486 | 3 x 3 blk / 48 x 48mm | 54 / 864mm | 34 | 4 | 8 tm / 20 blk | 4 x8.5 | 2193 | 0
coil_4x7_20 | 181 | 2896 | 4 x 7 x 18 | 504 | 4 x 7 blk / 64 x 112mm | 18 / 288mm | 34 | 4 | 8 tm / 20 blk | 4 x8.5 | 2065 | 15
coil_4x8_18 | 177 | 2832 | 4 x 8 x 16 | 512 | 4 x 8 blk / 64 x 128mm | 16 / 256mm | 30 | 4 | 8 tm / 22 blk | 4 x7.5 | 2446 | 13
coil_5x7_18 | 177 | 2832 | 5 x 7 x 16 | 560 | 5 x 7 blk / 80 x 112mm | 16 / 256mm | 30 | 4 | 8 tm / 22 blk | 4 x7.5 | 2345 | 13
coil_4x9_18 | 193 | 3088 | 4 x 9 x 16 | 576 | 4 x 9 blk / 64 x 144mm | 16 / 256mm | 30 | 4 | 8 tm / 24 blk | 4 x7.5 | 2881 | 13
coil_3x4_68 | 177 | 2832 | 4 x 3 x 63 | 756 | 3 x 4 blk / 48 x 64mm | 63 / 1008mm | 41 | 4 | 6 tm / 16 blk | 4 x10.3 | 1697 | 0
coil_3x4_79 | 188 | 3008 | 4 x 3 x 73 | 876 | 3 x 4 blk / 48 x 64mm | 73 / 1168mm | 43 | 4 | 8 tm / 17 blk | 4 x10.8 | 1878 | 0

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

rhythm = period terms x the share of turns that leave the plane

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

It is also the one packing number that is not implied by the box. coil_3x8_20 has the smallest box in the set and 15 shared walls; coil_3x3_54_2 is 2% larger and has none. If a shared wall is something to avoid, the smallest box is not the one to build.

## Rotation

spiral | axis | rotation | turns | blocks/360 | rise/360 blk / mm | deg/block | 90deg turns | turns/m | longest straight
coil_3x8_20 | N | 3060 | 8.50 | 20.0 | 2.00 / 32 | 18.0 | 68 | 25.0 | 4 blk / 64mm
coil_3x9_18 | N | 2700 | 7.50 | 22.0 | 2.00 / 32 | 16.4 | 60 | 22.7 | 4 blk / 64mm
coil_3x3_54_2 | N | 2610 | 7.25 | 22.8 | 6.62 / 106 | 15.8 | 60 | 22.7 | 4 blk / 64mm
coil_3x3_59 | N | 2970 | 8.25 | 20.6 | 6.42 / 103 | 17.5 | 68 | 25.0 | 3 blk / 48mm
coil_4x7_20 | N | 3060 | 8.50 | 20.0 | 2.00 / 32 | 18.0 | 68 | 25.0 | 3 blk / 48mm
coil_4x8_18 | N | 2700 | 7.50 | 21.9 | 2.00 / 32 | 16.5 | 60 | 22.9 | 4 blk / 64mm
coil_5x7_18 | N | 2700 | 7.50 | 22.0 | 2.00 / 32 | 16.4 | 60 | 22.7 | 4 blk / 64mm
coil_4x9_18 | N | 2700 | 7.50 | 24.0 | 2.00 / 32 | 15.0 | 60 | 20.8 | 4 blk / 64mm
coil_3x4_68 | N | 3600 | 10.00 | 16.3 | 6.20 / 99 | 22.1 | 61 | 23.4 | 3 blk / 48mm
coil_3x4_79 | N | 3780 | 10.50 | 17.2 | 6.86 / 110 | 20.9 | 84 | 29.0 | 3 blk / 48mm

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

## What wins what

No single spiral wins, because the measures disagree.

| winner | against the walk this started from
smallest box | coil_3x8_20 — 432 | 736, so 1.70x larger
tightest spiral (least rise per turn) | coil_3x8_20 — 32mm | 64mm, so 2.0x slacker
least tube per turn | coil_3x4_68 — 16.3 blk | 16.0 blk, within -2%
fewest pieces | coil_3x9_18 — 30 | 45
fewest distinct shapes | coil_3x8_20 — 4 | 8
largest average plate | coil_4x9_18 — 2,881 mm2 | 1,598 mm2
calmest bore (fewest turns/m) | coil_4x9_18 — 20.83 | 20.83
smallest box with no shared wall | coil_3x3_54_2 — 441 | 736, also 0 shared

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

## A metric deliberately left out

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

## Every block load-bearing

One walk in this set is a hand reduction of the staircase coil — blocks taken out wherever one could go without introducing an elbow. (derived.txt maps every name here to the walk it derives from.) tools/minimal.js checks the claim: a term's floor is 3 in a coil window, 2 in a hairpin, 1 in a step, and a walk whose every term sits on its floor cannot be shortened at all.

node tools/minimal.js            # every walk
node tools/minimal.js --terms    # and which terms have slack

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

### The reduction pass, and why minimality is not an optimisation

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

What those 9 reductions buy:

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

node tools/reduce.js             # the pass
node tools/reduce.js --write     # and reduced.json

## Walks kept but not scored

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

## Scoring them against each other

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

## The gate

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

node tools/run_checks.sh     # re-run the gate over every walk

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

## How they were found

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

That rule, for a window of three consecutive terms — outer A, middle m, outer C:

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

## The tools

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

Finding and shaping walks

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

Measuring and ranking

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

Producing what is committed

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

## The files behind the tables

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

## Regenerating

tools/build.sh               # all of the below, in order

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

node tools/spiral_metrics.js "$(cat walks/coil_3x8_20.txt)"   # measure one walk

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

## What has not been done

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

Released under CC0 1.0.
