Gernreich/trumpet-elbows-allowed/bell/bell-square25-210mm-14rings-x5-rim129-view.jpg

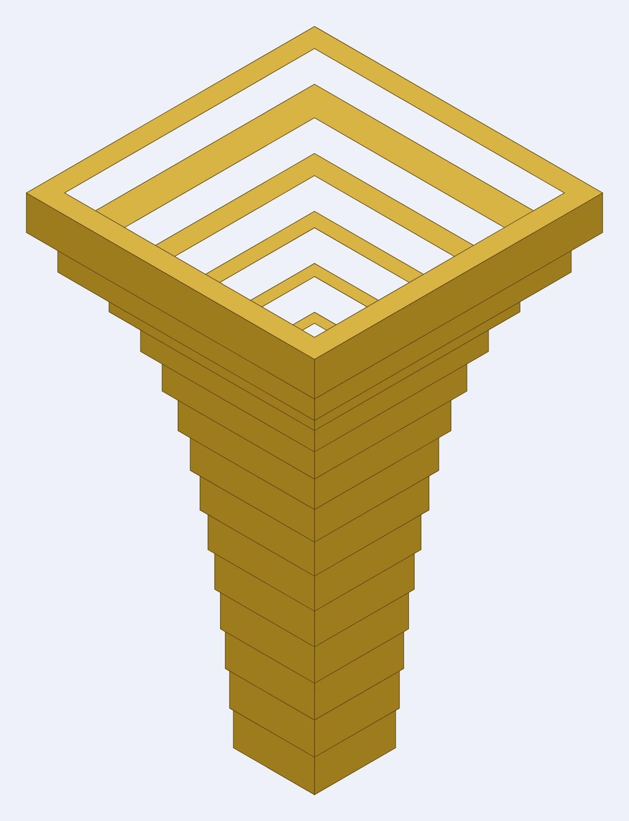
bell/bell-square25-210mm-14rings-x5-rim129-view.jpg
