Gernreich/trumpet-elbows-allowed/bell/bell-trumpet-67rings-view.jpg

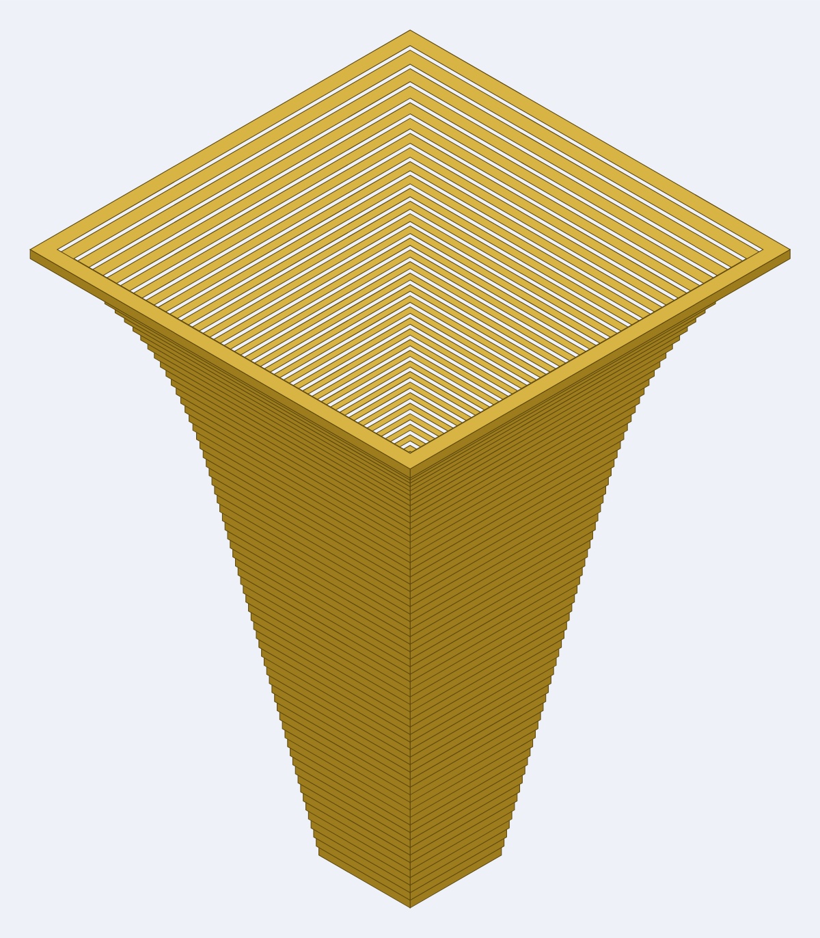
bell/bell-trumpet-67rings-view.jpg
