Gernreich/trumpet-elbows-allowed/designs/first_trumpet/trumpet_bore.png

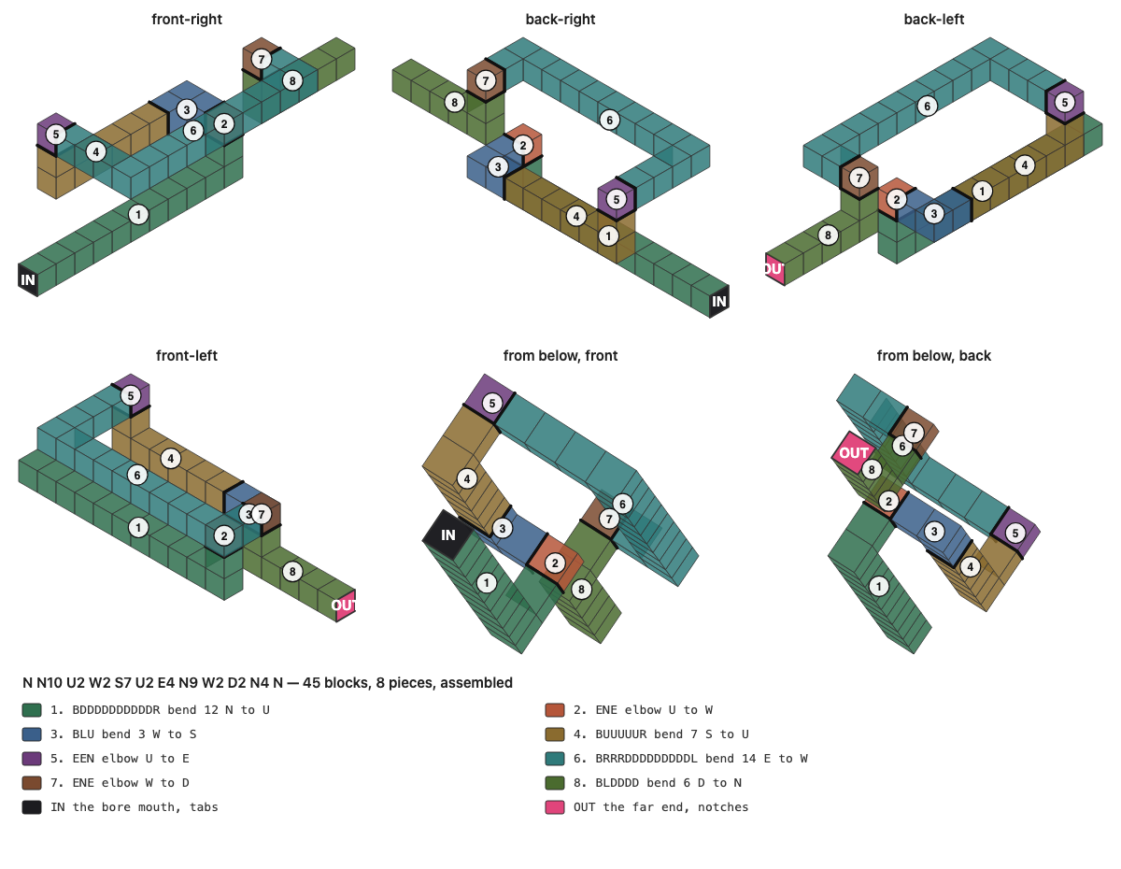
designs/first_trumpet/trumpet_bore.png
