Gernreich/trumpet-elbows-allowed/mouthpiece/mouthpiece-view.jpg

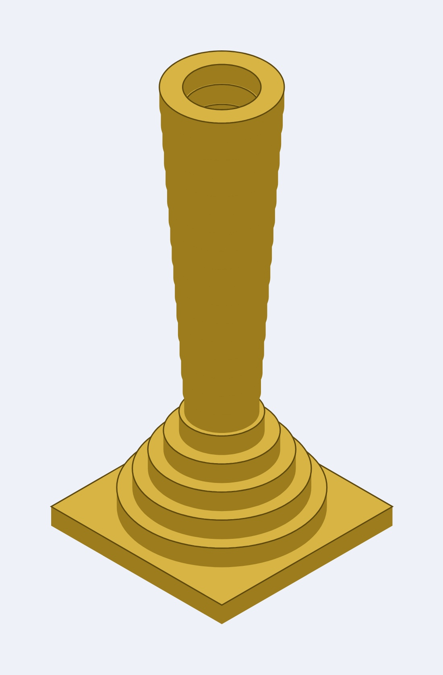
mouthpiece/mouthpiece-view.jpg
