Gernreich/trumpet-elbows-allowed/parts/bore/concept/walk/no-elbows/meander/no-contact/greek-key/bore/greek-key_minecraft.png

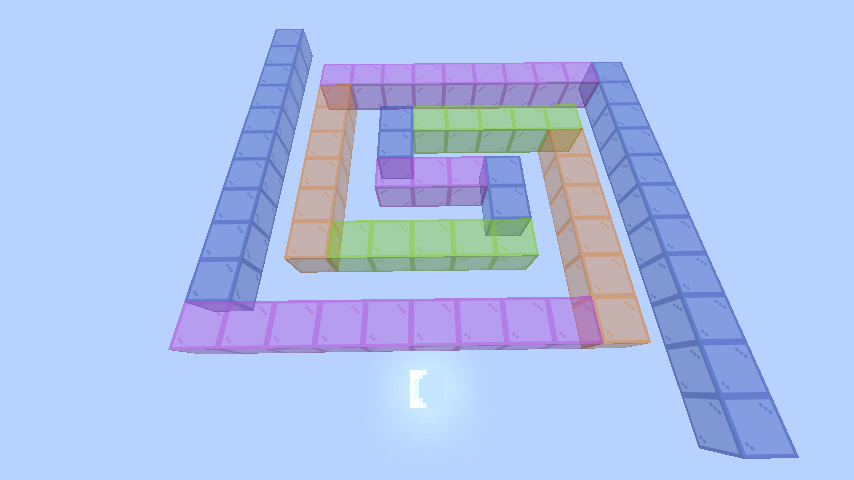
parts/bore/concept/walk/no-elbows/meander/no-contact/greek-key/bore/greek-key_minecraft.png
