Gernreich/trumpet-elbows-allowed/built/coil-fold2-long-straight-3t/step/fold2-long-straight-3t.step

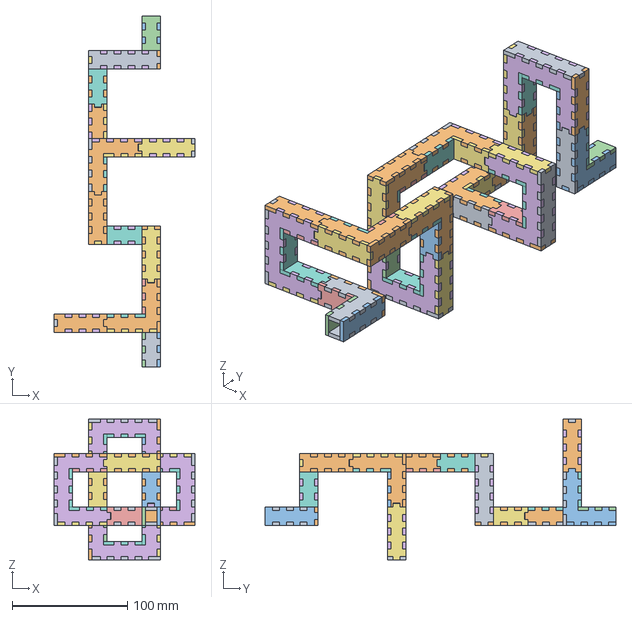
[picture p15: CAD file, 2026-11-11]
built/coil-fold2-long-straight-3t/step/fold2-long-straight-3t.step
122.0 x 304.0 x 122.0 mm
