Gernreich/trumpet-elbows-allowed/parts/bell/step/bell-round10-153mm-17rings-x3-rim86.step

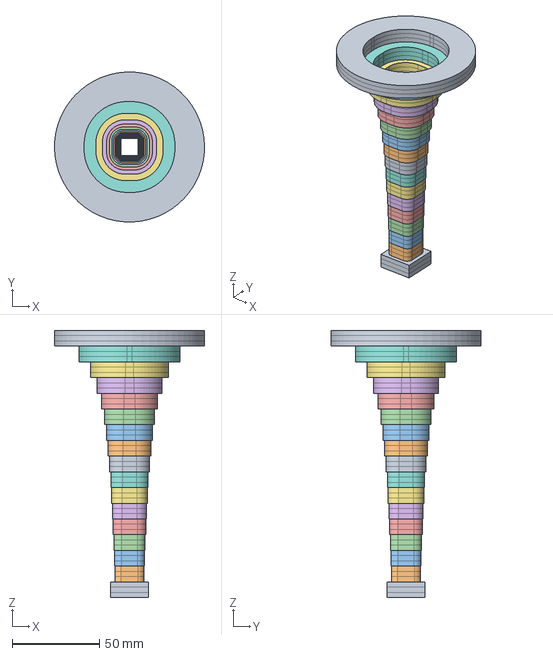
[picture p16: CAD file, 2026-11-08]
parts/bell/step/bell-round10-153mm-17rings-x3-rim86.step
86.0 x 85.9 x 153.0 mm
