Gernreich/trumpet-elbows-allowed/parts/bore/concept/walk/coil/2x2-134/step/2x2-134.step

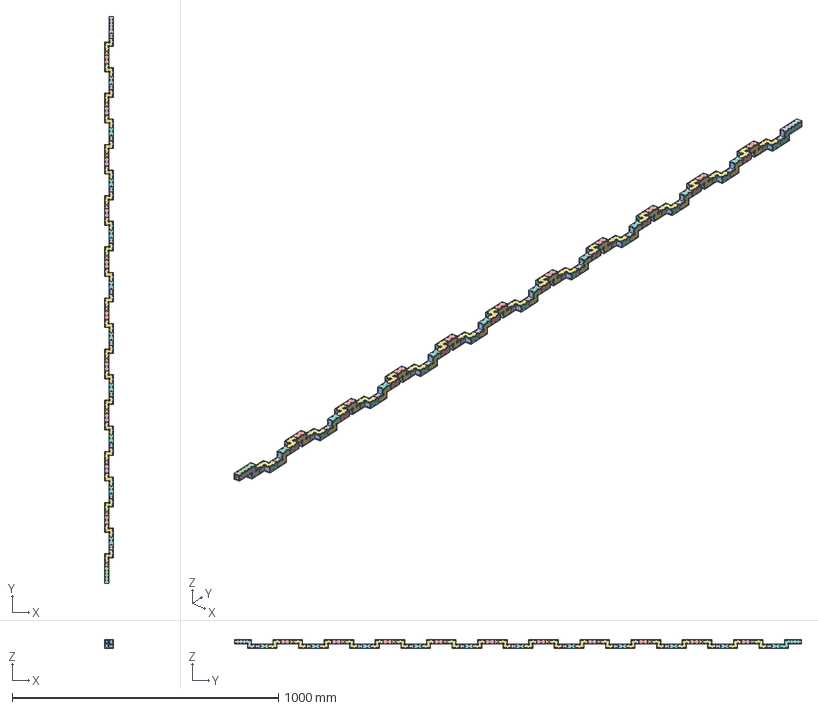
[picture p17: CAD file, 2026-11-11]
parts/bore/concept/walk/coil/2x2-134/step/2x2-134.step
32.0 x 2128.0 x 32.0 mm
