Gernreich/trumpet-elbows-allowed/parts/bore/concept/walk/coil/3x3-54/step/3x3-54.step

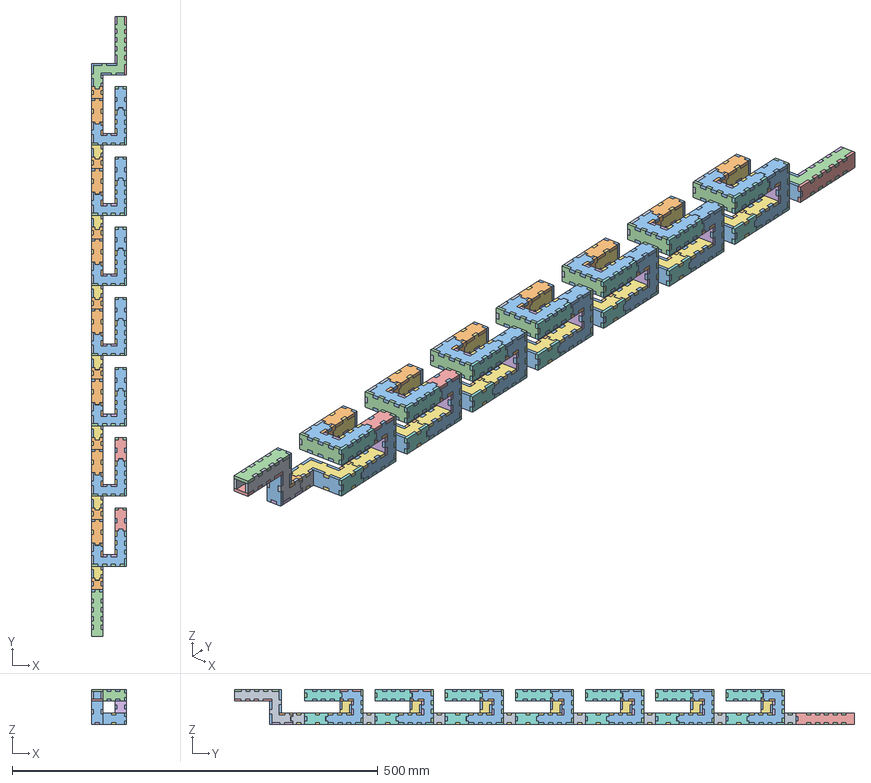
[picture p18: CAD file, 2026-11-11]
parts/bore/concept/walk/coil/3x3-54/step/3x3-54.step
48.0 x 848.0 x 48.0 mm
