Gernreich/trumpet-elbows-allowed/parts/bore/concept/walk/coil/4x4-50/step/4x4-50.step

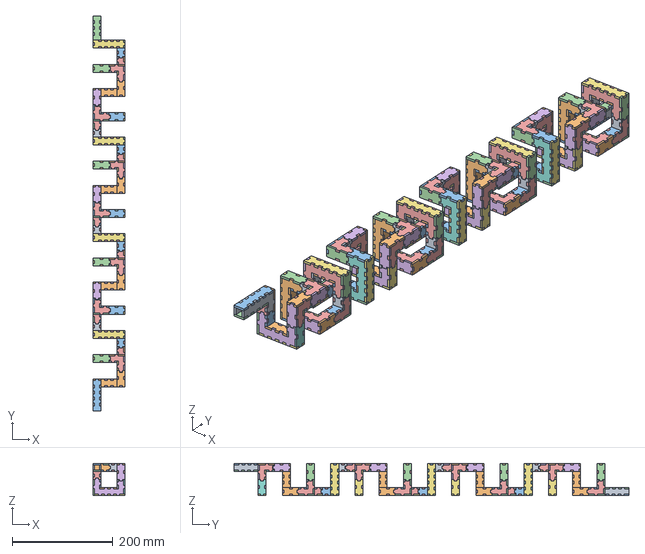
[picture p19: CAD file, 2026-11-11]
parts/bore/concept/walk/coil/4x4-50/step/4x4-50.step
64.0 x 784.0 x 64.0 mm
