Gernreich/trumpet-elbows-allowed/parts/bore/concept/walk/coil/5x5-50/step/5x5-50.step

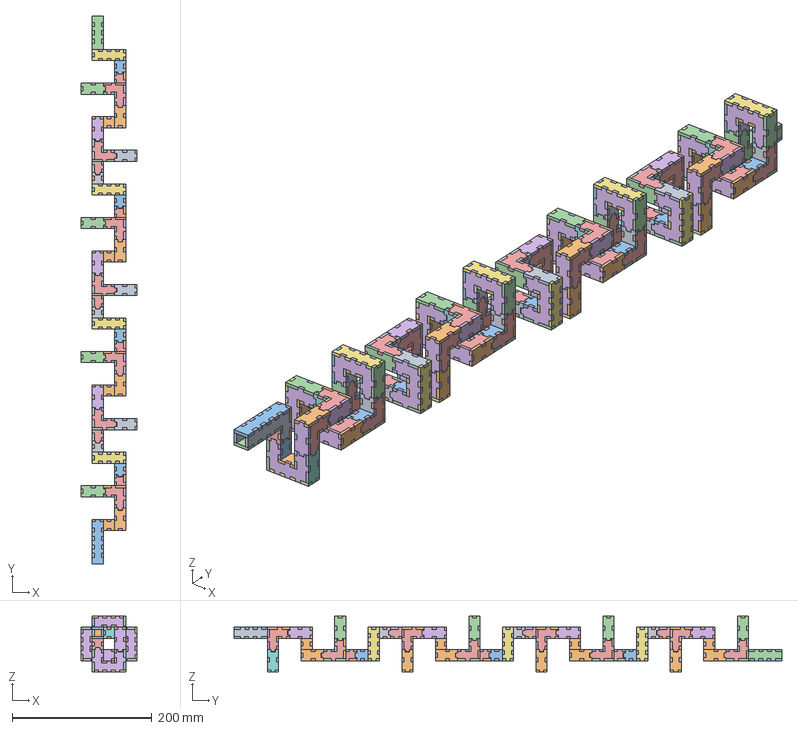
[picture p20: CAD file, 2026-11-11]
parts/bore/concept/walk/coil/5x5-50/step/5x5-50.step
80.0 x 784.0 x 80.0 mm
