Gernreich/trumpet-elbows-allowed/parts/bore/concept/walk/coil/fold2-long-straight/coil-10x10x30-0.75t/step/coil-10x10x30-0.75t.step

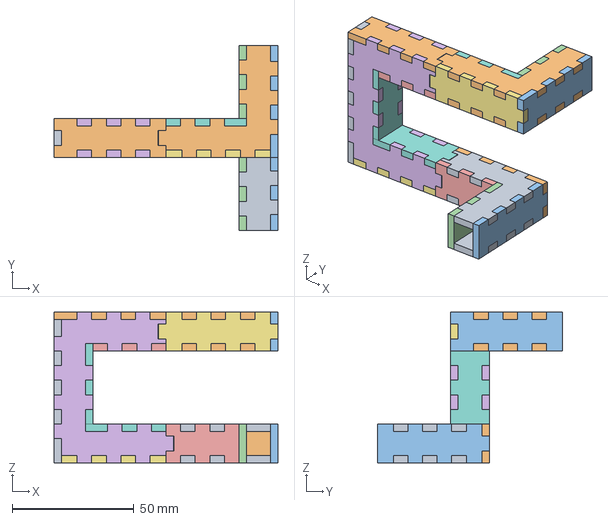
[picture p21: CAD file, 2026-11-11]
parts/bore/concept/walk/coil/fold2-long-straight/coil-10x10x30-0.75t/step/coil-10x10x30-0.75t.step
92.0 x 76.0 x 62.0 mm
