Gernreich/trumpet-elbows-allowed/parts/bore/concept/walk/coil/fold2-long-straight/coil-10x10x30-1.5t/step/coil-10x10x30-1.5t.step

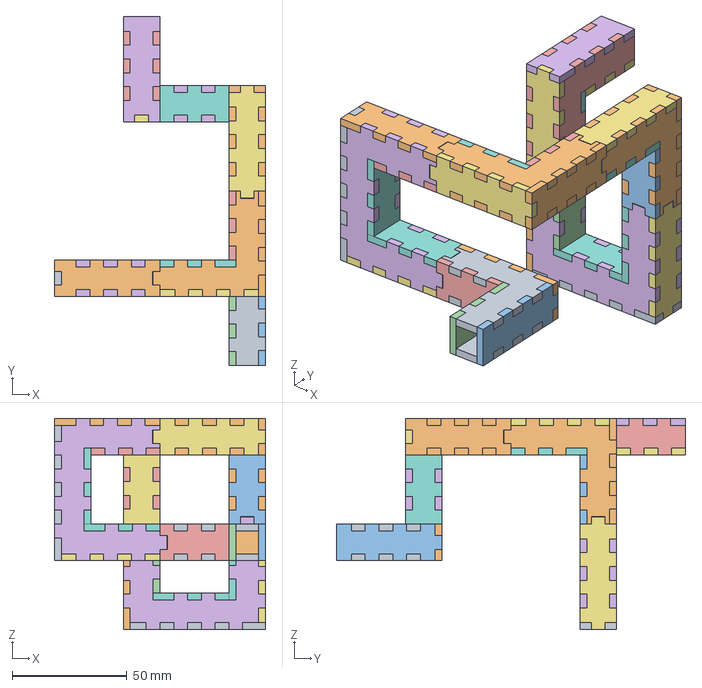
[picture p22: CAD file, 2026-11-11]
parts/bore/concept/walk/coil/fold2-long-straight/coil-10x10x30-1.5t/step/coil-10x10x30-1.5t.step
92.0 x 152.0 x 92.0 mm
