Gernreich/trumpet-elbows-allowed/parts/bore/concept/walk/coil/fold2-long-straight/coil-10x10x30-2.25t/step/coil-10x10x30-2.25t.step

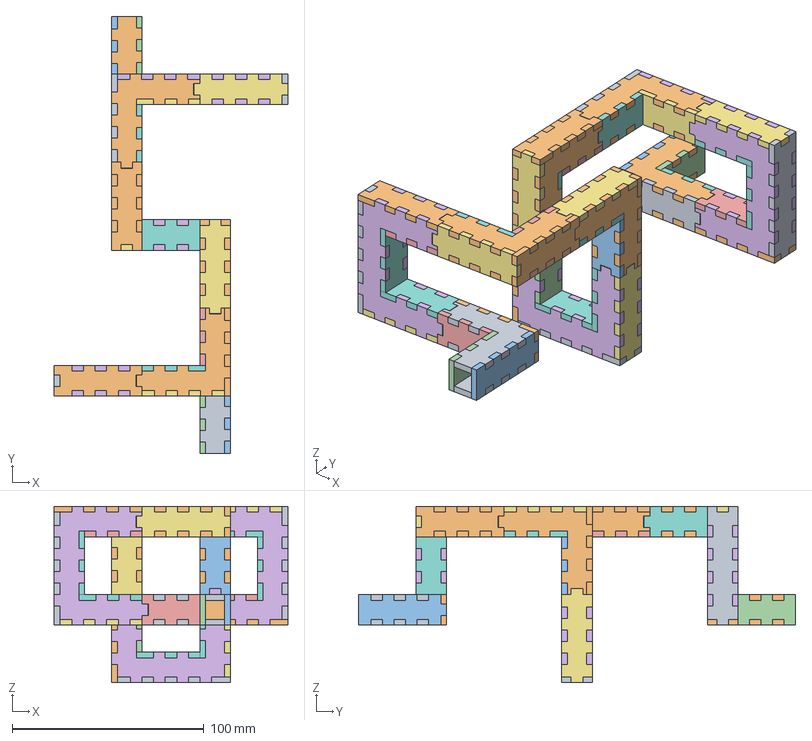
[picture p23: CAD file, 2026-11-11]
parts/bore/concept/walk/coil/fold2-long-straight/coil-10x10x30-2.25t/step/coil-10x10x30-2.25t.step
122.0 x 228.0 x 92.0 mm
