Gernreich/trumpet-elbows-allowed/parts/bore/concept/walk/coil/fold2/bore/step/fold2.step

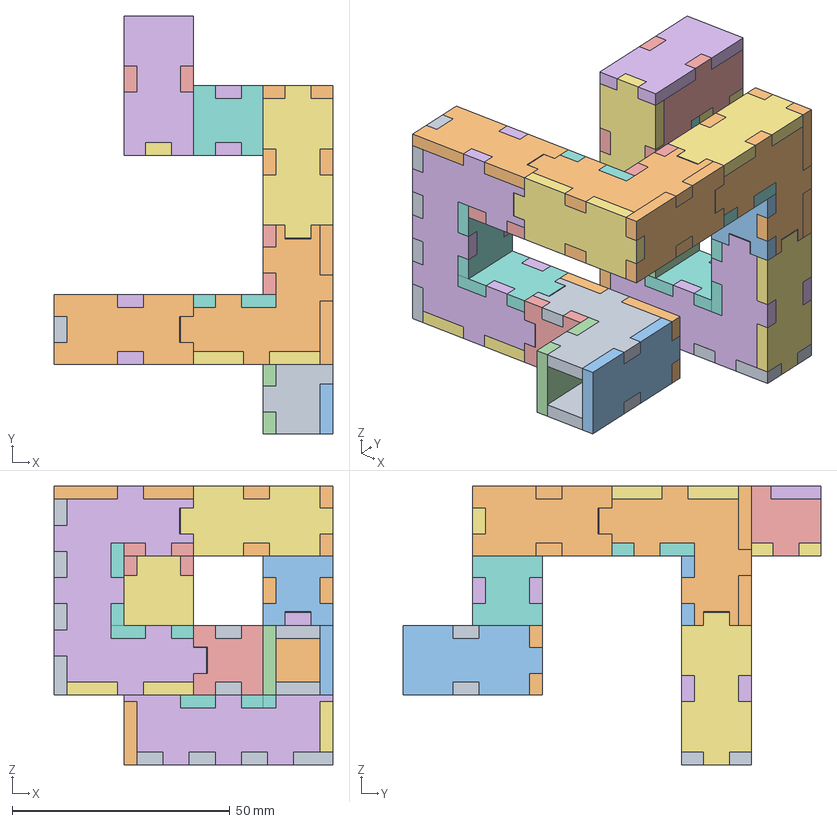
[picture p24: CAD file, 2026-11-11]
parts/bore/concept/walk/coil/fold2/bore/step/fold2.step
64.0 x 96.0 x 64.0 mm
