Gernreich/trumpet-elbows-allowed/parts/bore/concept/walk/coil/minimal/step/minimal.step

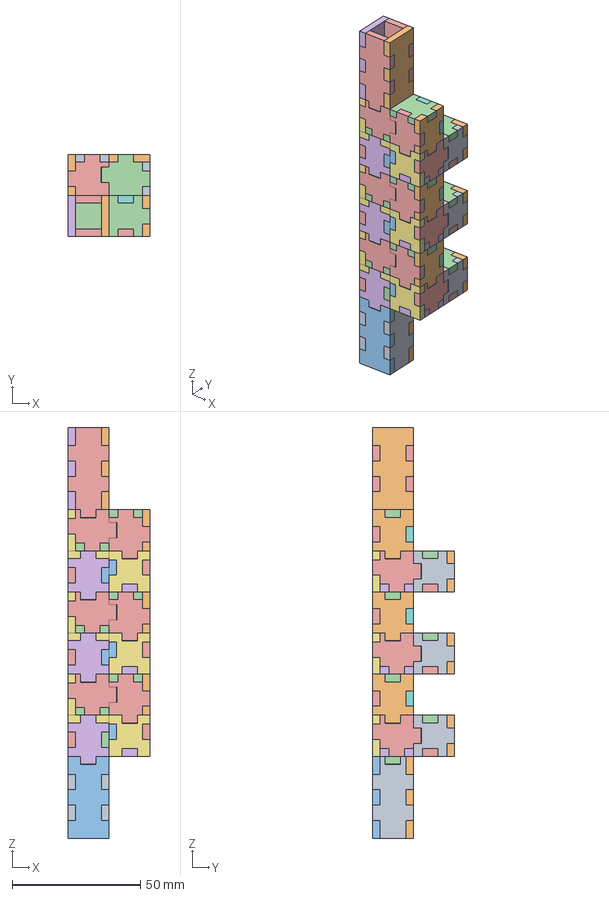
[picture p25: CAD file, 2026-11-11]
parts/bore/concept/walk/coil/minimal/step/minimal.step
32.0 x 32.0 x 160.0 mm
