Gernreich/trumpet-elbows-allowed/parts/bore/concept/walk/coil/square-rise1/step/square-rise1.step

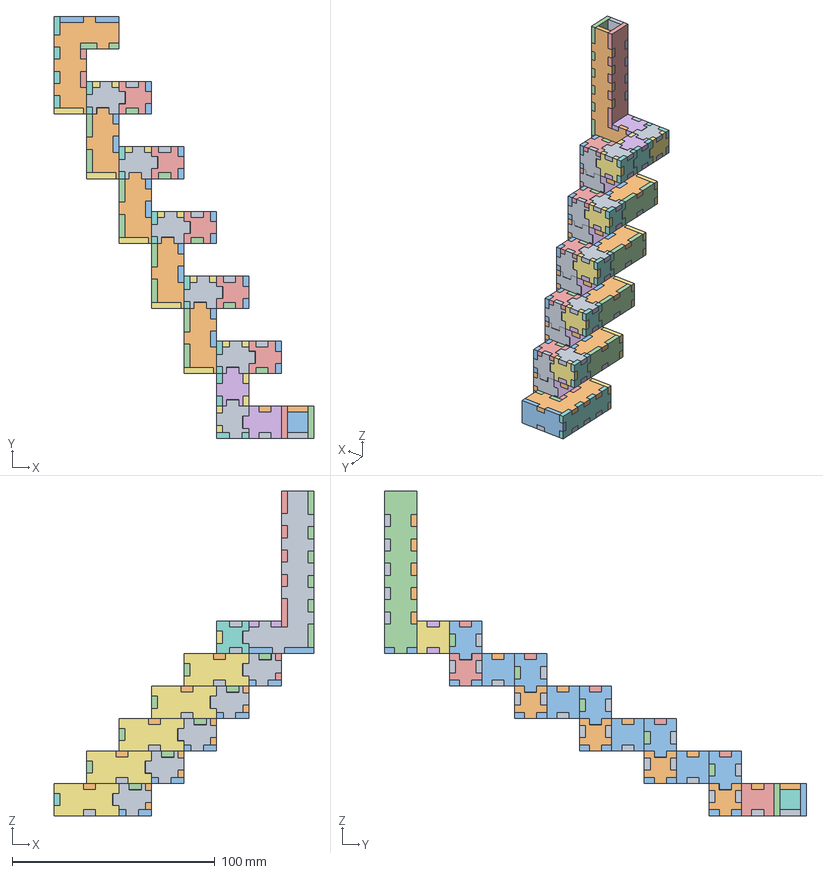
[picture p26: CAD file, 2026-11-11]
parts/bore/concept/walk/coil/square-rise1/step/square-rise1.step
128.0 x 208.0 x 160.0 mm
