Gernreich/trumpet-elbows-allowed/parts/bore/concept/walk/coil/square-rise3/step/square-rise3.step

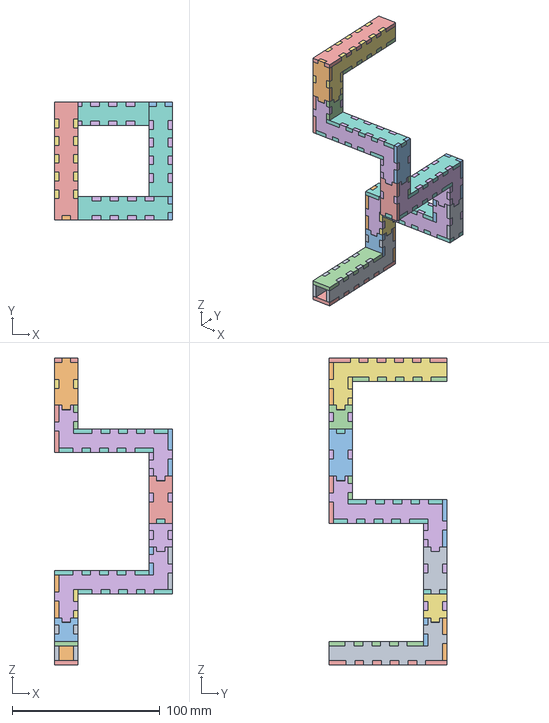
[picture p27: CAD file, 2026-11-11]
parts/bore/concept/walk/coil/square-rise3/step/square-rise3.step
80.0 x 80.0 x 208.0 mm
