Gernreich/trumpet-elbows-allowed/parts/bore/concept/walk/coil/three-side/step/three-side.step

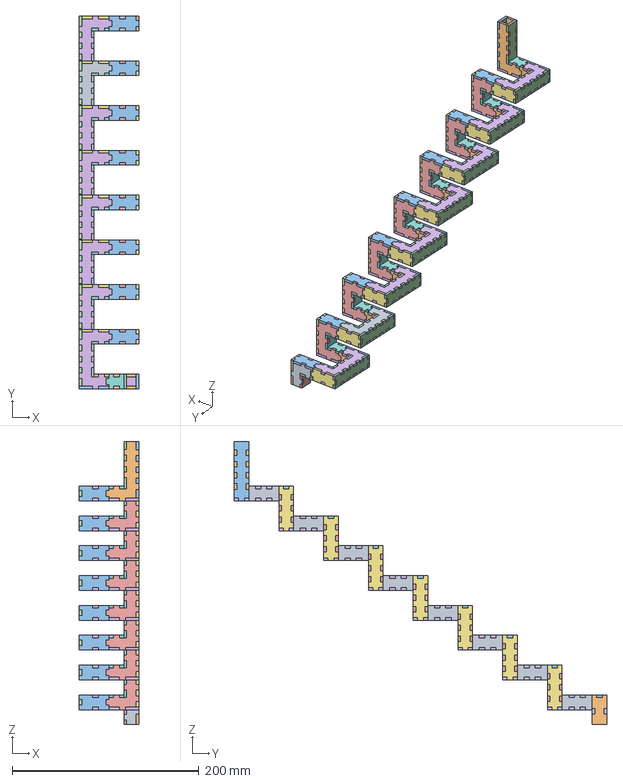
[picture p28: CAD file, 2026-11-11]
parts/bore/concept/walk/coil/three-side/step/three-side.step
64.0 x 400.0 x 304.0 mm
