Gernreich/trumpet-elbows-allowed/parts/bore/concept/walk/coil/tight/bore/step/tight.step

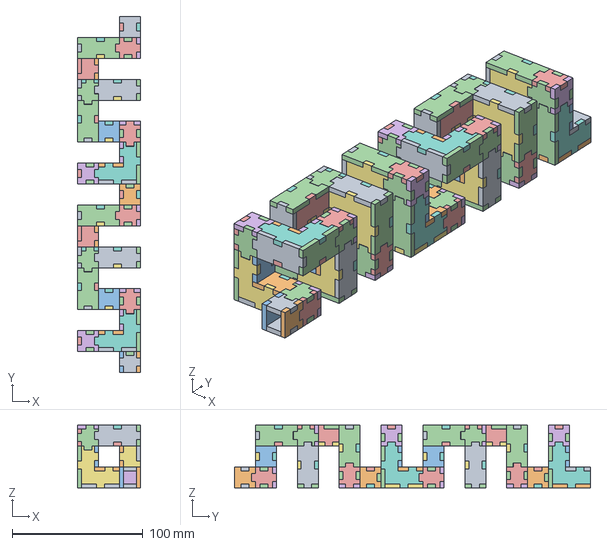
[picture p29: CAD file, 2026-11-11]
parts/bore/concept/walk/coil/tight/bore/step/tight.step
48.0 x 272.0 x 48.0 mm
