Gernreich/trumpet-elbows-allowed/parts/bore/concept/walk/hilbert/open/step/open.step

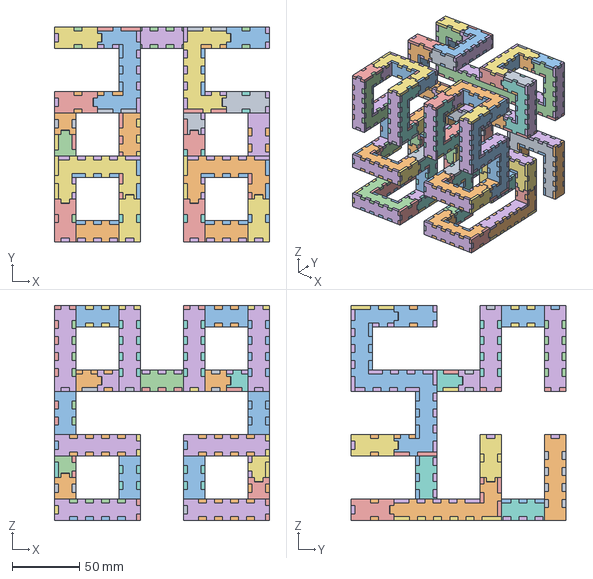
[picture p30: CAD file, 2026-11-11]
parts/bore/concept/walk/hilbert/open/step/open.step
160.0 x 160.0 x 160.0 mm
