Gernreich/trumpet-elbows-allowed/parts/bore/concept/walk/meander/first/step/first.step

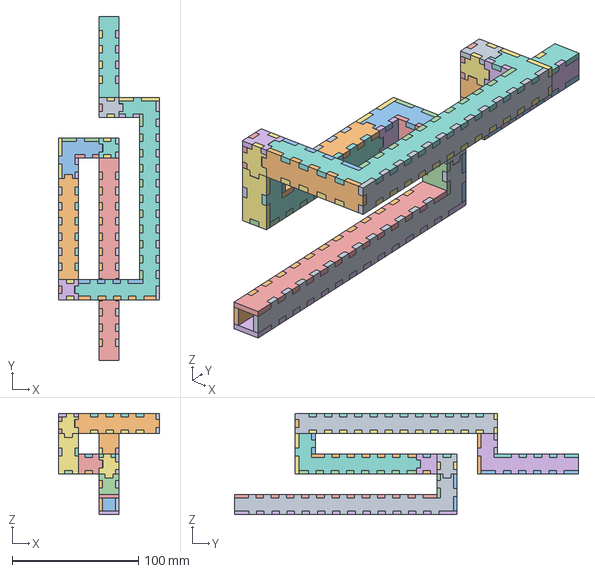
[picture p31: CAD file, 2026-11-11]
parts/bore/concept/walk/meander/first/step/first.step
80.0 x 272.0 x 80.0 mm
