Gernreich/trumpet-elbows-allowed/parts/bore/concept/walk/meander/greek-key/bore/step/greek-key.step

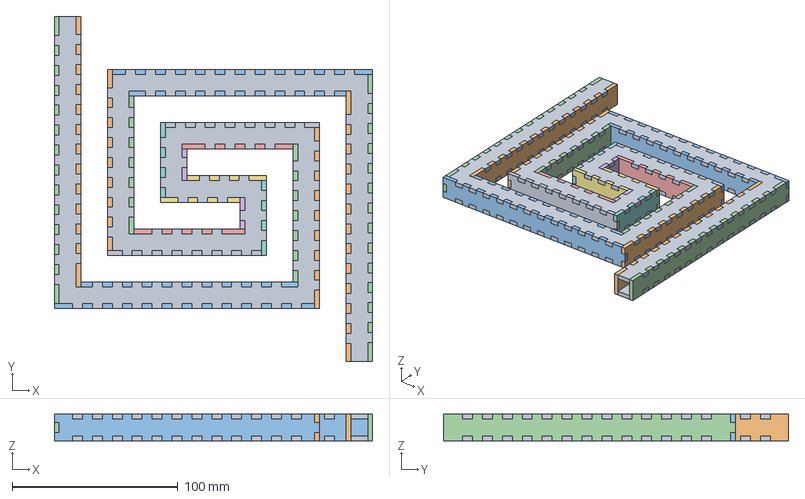
[picture p32: CAD file, 2026-11-11]
parts/bore/concept/walk/meander/greek-key/bore/step/greek-key.step
192.0 x 208.0 x 16.0 mm
