Gernreich/trumpet-elbows-allowed/parts/bore/concept/walk/spiral/expanding/step/expanding.step

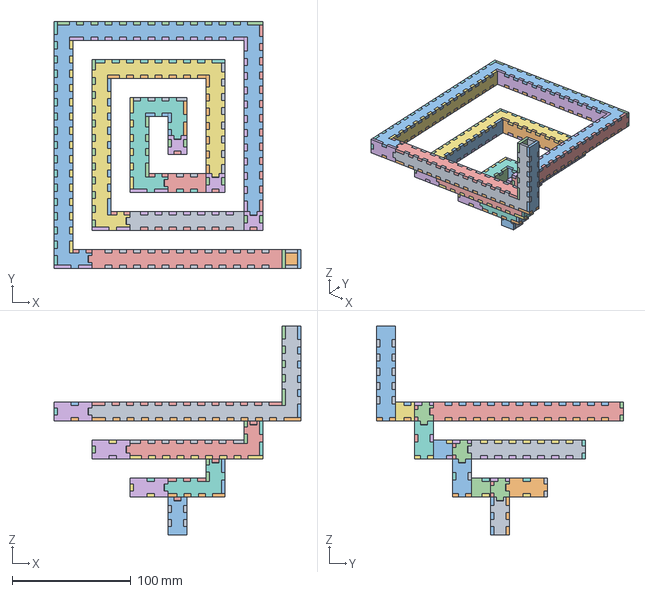
[picture p33: CAD file, 2026-11-11]
parts/bore/concept/walk/spiral/expanding/step/expanding.step
208.0 x 208.0 x 176.0 mm
