Gernreich/trumpet-elbows-allowed/parts/bore/concept/walk/spiral/telescope/step/telescope.step

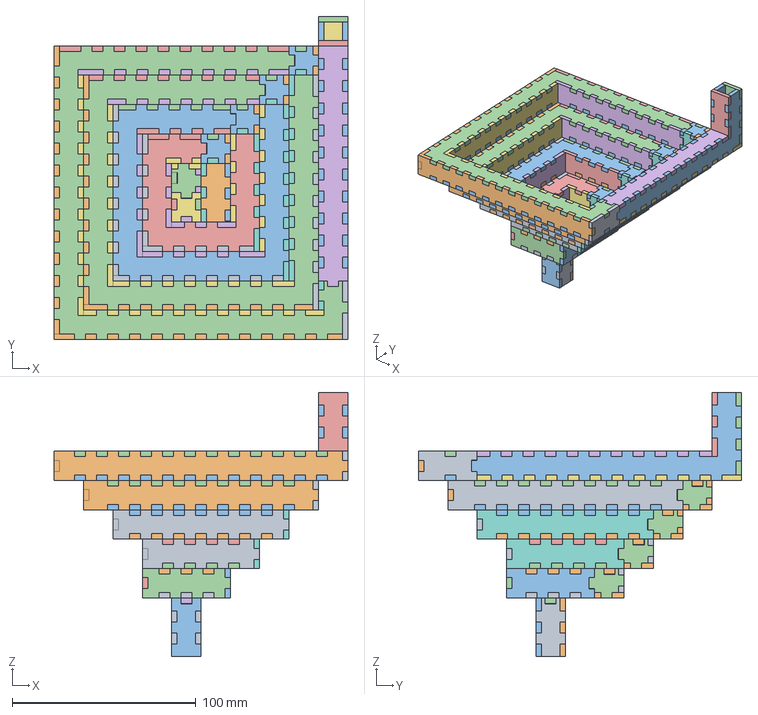
[picture p34: CAD file, 2026-11-11]
parts/bore/concept/walk/spiral/telescope/step/telescope.step
160.0 x 176.0 x 144.0 mm
