Gernreich/trumpet-elbows-allowed/parts/bore/concept/walk/spiral/ziggurat/bore/step/ziggurat.step

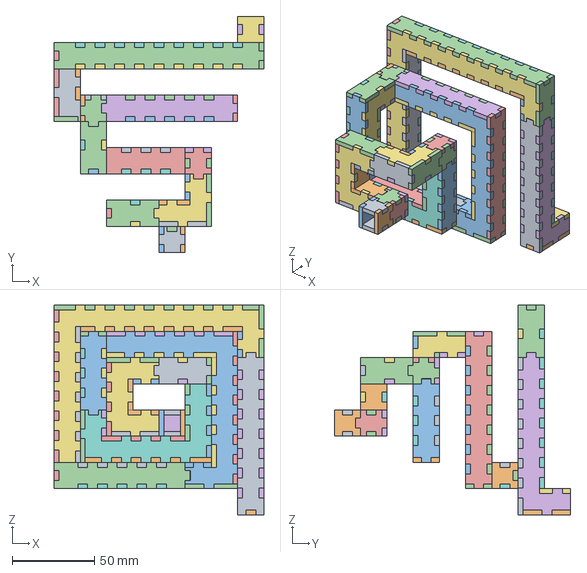
[picture p35: CAD file, 2026-11-11]
parts/bore/concept/walk/spiral/ziggurat/bore/step/ziggurat.step
128.0 x 144.0 x 128.0 mm
