Gernreich/trumpet-elbows-allowed/parts/mouthpiece/step/mouthpiece-bore10-trumpet-parts.step

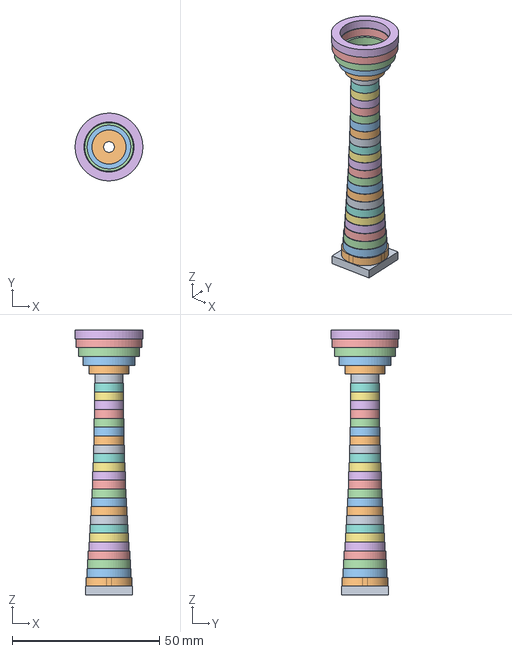
[picture p36: CAD file, 2026-11-08]
parts/mouthpiece/step/mouthpiece-bore10-trumpet-parts.step
23.0 x 23.0 x 90.0 mm
