Gernreich/trumpet-elbows-allowed/parts/bell/verify_bell.py

#!/usr/bin/env python3
"""Check a bell sheet that has been edited by hand, before it is cut.

    python3 verify_bell.py SHEET.svg [REFERENCE.svg]

With one argument it checks the sheet against itself: ring count, the 1.5mm
lap, what is nested inside what, whether any two outlines cross, and whether
the cut stage is one colour. With a second it also compares every ring to the
sizes bell.py produced -- useful after the paths have been converted to curves,
when a byte-for-byte diff no longer says anything.

Position-independent, so it still answers after the parts have been nested.

Sizes are measured per command. Flattening a path's numbers and pairing them
off breaks the moment it uses H, V or a curve, and these files use all three.
Quadratic control points are counted into a box, making it a superset of the
true one; for telling a ring from a digit that is the safe way to be wrong.
"""
import re
import sys
import pathlib

NUM = re.compile(r"-?\d*\.?\d+(?:[eE][-+]?\d+)?")
RING_MIN = 5.0                      # separates rings from engraved digits: the smallest
                                    # ring aperture is the bore and every digit is under
                                    # 3mm, so anything in between will do. It was 20 while
                                    # the bore was larger, which at a 10mm bore threw away
                                    # every ring and reported a sheet with no rings in it.
LAP = 3.0                           # each ring overhangs the next aperture by this;
                                    # overridden by whatever the sheet states in its <desc>


def subpaths(d):
    out, cur = [], None
    x = y = sx = sy = 0.0
    for cmd, arg in re.findall(r"([MmLlHhVvQqTtCcSsAaZz])([^A-Za-z]*)", d):
        n = [float(v) for v in NUM.findall(arg)]
        up, rel = cmd.upper(), cmd.islower()
        if up == "M":
            if cur:
                out.append(cur)
            x, y = (x + n[0], y + n[1]) if rel else (n[0], n[1])
            sx, sy = x, y
            cur = [(x, y)]
            for i in range(2, len(n), 2):
                x, y = (x + n[i], y + n[i + 1]) if rel else (n[i], n[i + 1])
                cur.append((x, y))
        elif up == "L":
            for i in range(0, len(n), 2):
                x, y = (x + n[i], y + n[i + 1]) if rel else (n[i], n[i + 1])
                cur.append((x, y))
        elif up == "H":
            for v in n:
                x = x + v if rel else v
                cur.append((x, y))
        elif up == "V":
            for v in n:
                y = y + v if rel else v
                cur.append((x, y))
        elif up in ("Q", "T", "C", "S", "A"):
            step = {"Q": 4, "T": 2, "C": 6, "S": 4, "A": 7}[up]
            for i in range(0, len(n) - step + 1, step):
                seg = n[i:i + step]
                if up == "A":
                    x, y = (x + seg[5], y + seg[6]) if rel else (seg[5], seg[6])
                    cur.append((x, y))
                    continue
                pts = [(seg[k], seg[k + 1]) for k in range(0, step, 2)]
                for dx, dy in pts:
                    cur.append((x + dx, y + dy) if rel else (dx, dy))
                lx, ly = pts[-1]
                x, y = (x + lx, y + ly) if rel else (lx, ly)
        elif up == "Z":
            x, y = sx, sy
    if cur:
        out.append(cur)
    return out


def box(pts):
    xs = [p[0] for p in pts]
    ys = [p[1] for p in pts]
    return min(xs), min(ys), max(xs), max(ys)


def span(pts):
    x0, y0, x1, y1 = box(pts)
    return max(x1 - x0, y1 - y0)


HUE = re.compile(r"stroke\s*[:=]\s*.?(#[0-9a-fA-F]{6})")


CONCENTRIC = 0.5     # mm of centre-to-centre slop allowed between an aperture and its
                     # own outline. Rings are whole millimetres apart on any nest, so this
                     # is nowhere near wide enough to pair a ring with somebody else's.


def centre(b):
    return ((b[0] + b[2]) / 2.0, (b[1] + b[3]) / 2.0)


def pair_by_centre(loose):
    """Pair single-outline apertures with their own outlines. Returns (rings, leftover).

    A RING IS TWO PATHS NOW, NOT ONE. Apertures moved into their own orange group so they
    cut before the outline that frees the part, and this tool went on looking for one path
    holding two big subpaths. It found none, called every generated sheet "a section drawing
    or a sheet of something else", and skipped it -- silently passing on sheets nobody had
    checked.

    Paired by CONCENTRICITY and size, smallest first, not by colour and not by file order.
    Colour would hard-code the generator's palette into a tool whose whole job is checking
    sheets somebody has edited. File order survives a nest but not a reorder, and Inkscape
    reorders. Containment alone is what mouthpiece-view.py rejected and for the same reason:
    it is true of a ring sitting in another ring's spare space. Sharing a centre is not."""
    rings, used = [], set()
    order = sorted(range(len(loose)), key=lambda k: loose[k]["s"])
    for k in order:
        if k in used:
            continue
        a = loose[k]
        ac = centre(a["b"])
        mate = None
        for j in order:                       # smallest first, so the tightest fit wins
            if j in used or j == k or loose[j]["s"] <= a["s"] + 1e-6:
                continue
            bc = centre(loose[j]["b"])
            if abs(bc[0] - ac[0]) <= CONCENTRIC and abs(bc[1] - ac[1]) <= CONCENTRIC:
                mate = j
                break
        if mate is None:
            continue
        used.add(k)
        used.add(mate)
        o = loose[mate]
        # The ring's cut stage is the OUTLINE's colour: that is the cut that frees the
        # part. The aperture's stage only says when the hole goes in.
        rings.append({"i": o["i"], "outer": o["b"], "ap": a["b"],
                      "o": o["s"], "a": a["s"], "c": o["c"]})
    return rings, [loose[k] for k in range(len(loose)) if k not in used]


def read(path):
    """(rings, marks). A ring is an aperture and the outline concentric with it.

    Two forms are read. A sheet from before 2026-09-03 holds both in ONE path, as two big
    subpaths. A sheet since holds them as two paths in two colour groups. Both end up as
    the same record, so every check below is written once.

    Colour is taken from the path or, failing that, from the group around it. A sheet saved
    out of Inkscape carries a stroke on every path; one straight from a generator carries it
    once on the <g>. Reading only the path meant every generated sheet came back as a single
    stage of None, and then the labels -- also None -- looked like they shared it."""
    src = pathlib.Path(path).read_text()
    rings, marks, loose = [], [], []
    gstroke, stack, i = None, [], -1
    for m in re.finditer(r"<g\b[^>]*>|</g\s*>|<path\b[^>]*>", src):
        el = m.group(0)
        if el.startswith("</g"):
            gstroke = stack.pop() if stack else None
            continue
        if el.startswith("<g"):
            stack.append(gstroke)
            hit = HUE.search(el)
            if hit:
                gstroke = hit.group(1).lower()
            continue
        i += 1
        attrs = el[5:-1]
        d = re.search(r'\bd="([^"]+)"', attrs)
        if not d:
            continue
        sp = subpaths(d.group(1))
        stroke = HUE.search(attrs)
        colour = stroke.group(1).lower() if stroke else gstroke
        big = sorted([p for p in sp if span(p) >= RING_MIN], key=span)
        if len(big) == 2:
            rings.append({"i": i, "outer": box(big[1]), "ap": box(big[0]),
                          "o": span(big[1]), "a": span(big[0]), "c": colour})
        elif len(big) == 1:
            loose.append({"i": i, "b": box(big[0]), "s": span(big[0]), "c": colour})
        else:
            marks.append({"i": i, "box": box([q for p in sp for q in p]), "c": colour})
    paired, leftover = pair_by_centre(loose)
    rings += paired
    # A big outline that found no aperture is a SOLID DISC where a ring should be, and
    # saying so is the point. Left in marks unlabelled it was caught only by accident, as
    # "a label shares a stage with a ring" -- true, and the wrong reason, which is the kind
    # of finding that teaches you to stop reading them.
    marks += [{"i": p["i"], "box": p["b"], "c": p["c"], "solo": True} for p in leftover]
    rings.sort(key=lambda r: r["i"])
    marks.sort(key=lambda r: r["i"])
    return rings, marks


def inside(b, o, pad=0.01):
    return (b[0] >= o[0] - pad and b[1] >= o[1] - pad
            and b[2] <= o[2] + pad and b[3] <= o[3] + pad)


def crosses(a, b):
    return a[0] < b[2] and b[0] < a[2] and a[1] < b[3] and b[1] < a[3]


def is_bell_sheet(path):
    """Bell rings are squares drawn with H and V. The mouthpiece's are circles,
    drawn with elliptical arcs, and it laps by whatever its 3mm wall leaves
    rather than by a fixed 1.5mm -- so this tool has nothing true to say about
    it. Pointed at one it used to report a problem, which is worse than
    silence: a checker that answers about a file it does not understand teaches
    you to ignore it."""
    src = pathlib.Path(path).read_text()
    ds = re.findall(r'\bd="([^"]+)"', src)
    if any(c in "Aa" for d in ds for c in re.findall(r"[A-Za-z]", d)):
        return False, "rings are drawn with arcs, so they are round — not a bell sheet"
    rings, _ = read(path)
    if len(rings) < 2:
        return False, (f"only {len(rings)} concentric-square ring(s) — a section drawing "
                       "or a sheet of something else")
    return True, ""


def main():
    if len(sys.argv) < 2:
        sys.exit("  usage: python3 verify_bell.py SHEET.svg [REFERENCE.svg]")
    ok, why = is_bell_sheet(sys.argv[1])
    if not ok:
        print(f"  skipped {pathlib.Path(sys.argv[1]).name}: {why}")
        return 0
    rings, marks = read(sys.argv[1])
    fails = []
    solo = [m for m in marks if m.get("solo")]
    print(f"  rings {len(rings)}   other paths {len(marks)}")
    if solo:
        for m in solo:
            w = m["box"][2] - m["box"][0]
            print(f"    ✗ path #{m['i']} is {w:.1f}mm across with nothing concentric "
                  f"inside it — a solid disc, not a ring")
        fails.append(f"{len(solo)} outline(s) have no aperture: the sheet would cut "
                     f"{len(solo)} solid disc(s)")

    # Ordered by APERTURE, not by outer diameter. The airway only ever opens, so aperture
    # order is assembly order on any sheet however it was nested -- which is what this tool
    # promises. Outer order used to be the same thing and is not any more: ring 0 is a
    # flange onto the bore and is wider than the rings just above it.
    lap = LAP
    m = re.search(r"(?:lapping the ring below by|seating on the ring below over)\s*([\d.]+)",
                  pathlib.Path(sys.argv[1]).read_text())
    if m:
        lap = float(m.group(1))
    order = sorted(rings, key=lambda r: r["a"])
    print(f"\n  the {lap:g}mm lap, ring to ring:")
    laps = [round((order[i]["o"] - order[i + 1]["a"]) / 2, 3) for i in range(len(order) - 1)]
    # The flange joint is deliberately deeper than the rest, so the first one only has to
    # be at least the lap; every other joint is an exact offset and must be exactly it.
    bad = [v for v in laps[1:] if abs(v - lap) > 0.01]
    if laps and laps[0] < lap - 0.01:
        bad.insert(0, laps[0])
    print(f"    {sorted(set(laps))}mm per side" + ("" if not bad else f"   OFF: {bad}"))
    if bad:
        fails.append(f"lap is not {lap:g}mm at every joint")
    elif laps and laps[0] > lap + 0.01:
        print(f"    the flange joint is deeper, {laps[0]:g}mm — it covers the bore's end face")

    # Two legitimate schemes. One colour for every ring is a single cut stage. A ramp
    # is one stage per ring, and then the colour IS the cut order -- so what matters is
    # that it rises with the ring, smallest first, since that is inner-before-outer for
    # every nest on the sheet. A ramp that does not sort with the sizes is worse than
    # no ramp: it looks deliberate and orders the cut wrongly.
    print("\n  cut stage:")
    mc = sorted({m["c"] for m in marks})
    by_size = sorted(rings, key=lambda r: r["o"])
    cols = [r["c"] for r in by_size]
    if len(set(cols)) == 1:
        print(f"    rings  one stage, {cols[0]}")
    else:
        print(f"    rings  {len(set(cols))} stages, {cols[0]} (ø{by_size[0]['o']:.1f}) "
              f"→ {cols[-1]} (ø{by_size[-1]['o']:.1f})")
        if len(set(cols)) != len(cols):
            dupe = [c for c in set(cols) if cols.count(c) > 1]
            fails.append(f"rings share a stage, so their order is undecided: {sorted(dupe)}")
        keys = [int(c[1:], 16) for c in cols]
        if keys != sorted(keys):
            fails.append("ring colours do not rise with ring size — the ramp orders "
                         "the cut wrongly")
        else:
            print("    ramp rises with size, so the smallest cuts first and the rim last")
    print(f"    labels {mc}")
    if len(mc) > 1:
        fails.append(f"marks use {len(mc)} shades, so they will not all land in one stage: {mc}")
    if set(mc) & set(cols):
        fails.append(f"a label shares a stage with a ring: {sorted(set(mc) & set(cols))}")

    # Reported as a note, not a failure. Document order is only the cut order on an
    # importer that follows it, and most do not: LightBurn and RDWorks order inner
    # shapes first by default whatever the file says. A freed disc this size also sits
    # flat on the bed rather than dropping. Calling it a problem alongside a genuine
    # one -- two shades of blue, which no software will rescue you from -- taught the
    # reader to weigh them the same, and they are not the same.
    print("\n  nesting:")
    nested = late = 0
    for a in rings:
        for b in rings:
            if a is b or not inside(a["outer"], b["ap"]):
                continue
            nested += 1
            if a["i"] > b["i"]:
                late += 1
                print(f"    – ø{a['o']:.1f} (path #{a['i']}) sits in ø{b['o']:.1f} "
                      f"(path #{b['i']}) and is written after it")
    print(f"    {nested} parts nested, {nested - late} written before the ring that frees them")
    if late:
        print(f"    {late} written after. That only decides anything if your software cuts in")
        print("    document order — most order inner shapes first regardless.")

    clash = 0
    for i in range(len(rings)):
        for j in range(i + 1, len(rings)):
            a, b = rings[i], rings[j]
            if (crosses(a["outer"], b["outer"])
                    and not inside(a["outer"], b["ap"]) and not inside(b["outer"], a["ap"])):
                clash += 1
                print(f"    ✗ ø{a['o']:.1f} and ø{b['o']:.1f} overlap and neither is nested")
    if clash:
        fails.append(f"{clash} pair(s) of outlines cross")
    print(f"    {clash} overlapping outlines")

    if len(sys.argv) > 2:
        ref, _ = read(sys.argv[2])
        print(f"\n  against {pathlib.Path(sys.argv[2]).name}:")
        a = sorted(round(r["a"], 2) for r in rings)
        b = sorted(round(r["a"], 2) for r in ref)
        same = a == b and len(rings) == len(ref)
        print(f"    {len(rings)} rings vs {len(ref)}; apertures "
              f"{'identical' if same else 'DIFFER'}")
        if not same:
            fails.append("ring sizes differ from the reference")

    print()
    for f in fails:
        print(f"  ✗ {f}")
    print(f"  {'✓ sheet is ready to cut' if not fails else f'{len(fails)} problem(s)'}")
    return 1 if fails else 0


if __name__ == "__main__":
    sys.exit(main())
