Gernreich/trumpet-elbows-allowed/(commit log)

2026-08-21 Take in the bell and the mouthpiece
    Moved from trumpet-curved, which held them and nowhere else did. Neither
    is changed by the elbow question - the flare and the cup are the same
    parts whichever way the bore turns - so they belong with the instrument
    that is going to be built.
    27 files: bell-trumpet-rings/ with four bells, their sections, their
    assembled views and the five generators; mouthpiece/ with the parts, the
    section, the view and two generators; and the five previews that render
    them. Copies were verified byte-identical against the source before it
    was removed there, so the hand-nested and hand-labelled
    bell-trumpet-17rings.svg carries over untouched.
    README gains sections for both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
2026-08-21 Add the generated landing page
    pages.yml deploys the tree as-is and index.html is generated and
    committed rather than built on the server, so without this the site root
    404s on the first push. Generated from README.md with md2html.py; audit
    passes 16/16 against the page and 9/9 against the source.
    It is the README, not a writeup. The 483-line build writeup that
    trumpet-curved published described an instrument that had been cut and
    photographed; this one has not been built yet, and index.md should be
    written when there is a build to describe. Regenerate after editing
    README.md or the page goes stale silently.
2026-08-21 Rename to trumpet-coiled
    trumpet-curved_no_elbows broke the naming convention three ways. Every
    other repository here is <object>-<geometry>, lowercase, hyphens only -
    trumpet-octagonal, torus-octagonal, knotwork-soundholes, living-hinge -
    and not one of the eleven contains an underscore. It ran to three parts
    where the family uses two, and its qualifier named a construction method,
    and a negation at that, where the family names a shape.
    Coiled is also the truer description. The bore's dominant feature is a
    flat coil, W5 N10 E5 S8 W3 in one plane, dropped twice to get the bell
    away from the mouthpiece. That is what the shape is; no elbows is how it
    is built, and the README already opens wit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
2026-08-21 Drop the references to what this replaces
    The repository stood on the other one to explain itself - the README
    opened by saying what it was not, and CLAUDE.md sourced four of its
    sections to a repository that is no longer checked out here. A reader who
    never saw the elbow build gains nothing from either.
    Where the reference carried real content it is kept and stated directly
    rather than by attribution: the pages workflow now explains its own
    per-sha concurrency group, the doc-audit blind spot is simply the blind
    spot, and 31mm-not-25 leads with being the error that invalidates a build
    sheet. Where it carried nothing, it is gone.
    Audits: 9/9 on README, 16/16 on the generated page.
    Co-Autho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
2026-08-21 Drop previews/
    They are not duplicates of anything - each is a processed rendering of a
    cut file, stroke thickened and a light ground painted in, about 550 bytes
    larger than its source and carrying a DISPLAY ONLY banner. But nothing
    here displays them: no img tag in README.md or index.html points into
    previews/, and the only mentions were the Files list and the command that
    builds them.
    They existed to illustrate the writeup in the repository these parts came
    from. There is no writeup here yet, and make-preview.py rebuilds one in a
    second, so keeping five unreferenced derivatives is carrying the output
    of a document that does not exist.
    CLAUDE.md keeps the part that was actually learned: t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
2026-08-21 Give the bore its own directory, and shorten bell-trumpet-rings to bell
    Three parts, three directories: bore/, bell/, mouthpiece/. The nine nets
    and the page were loose in the root while the other two parts were filed,
    and bell-trumpet-rings said "trumpet" and "rings" inside a trumpet
    repository whose bell is made of rings.
    The page is named for its folder so the cut files and the thing you turn
    around cannot drift apart, so it becomes bore/bore.html. Regenerating in
    the new location returns the nets byte-identical - git records the whole
    change as renames - and the title reads "Trumpet Coiled Bore" because the
    generator now borrows the parent for a folder called bore.
    All four bell images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
2026-08-21 Repoint at octomino-snakes in its new home
    It moved out of GIT to ~/LaserMadeMusic/octomino-snakes and its
    repository is archived, so it is no longer a sibling and every path to it
    was one level short. cd ../octomino-snakes/generator reached nothing, and
    the --write target the generator was given resolved from the new depth to
    a directory that does not exist.
    Both documents now say ../../octomino-snakes/generator and
    ../../GIT/trumpet-coiled/bore. Verified by running the documented command
    end to end from this repository: 253 checks, 0 failed, nets unchanged.
    Also says plainly what octomino-snakes now is - archived, read-only on
    GitHub, still runnable locally - rather than calling it a sib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
2026-08-21 Correct three claims about the bells and one dangling reference
    Found by recomputing the numbers from the SVGs rather than reading the
    prose, and by looking at the deployed page.
    The material claim was wrong. "About 0.49 m2 of 3mm ply against the
    67-ring's 0.69" describes the 10-ring at 0.485 and the 14-ring at 0.501,
    but the 17-ring measures 0.184 - barely a quarter of the 67-ring, not
    about the same as the other two. Its sheet is hand-nested, which is why.
    The old sentence overstated material for the one bell the document goes
    on to recommend, and buried its best argument.
    They are also not "the same 201mm Bessel horn sampled at four
    resolutions". A whole number of rings at each rise lan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
2026-08-21 Say "Bessel profile", not "Bessel horn"
    Only trumpets are being built, and "horn" reads as an instrument the
    project does not make. The identifying word is Bessel either way, so the
    pointer to the literature survives - a Bessel profile of gamma 0.7 is the
    standard model for a trumpet bell whatever it is called here.
    Also settles the document on one term: the gallery caption already said
    "Bessel profile" after yesterday's correction, so the two now agree.
    Prose only. The four bell SVGs carry "Bessel horn" in their desc metadata
    and bell.py emits it, but those files have been cut and one is
    hand-nested - not worth regenerating for a word, and not to be done
    without asking.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
2026-08-21 The bell and the mouthpiece, shared rather than owned
    Both were filed inside trumpet-coiled because that is where they landed
    when trumpet-curved was retired, and that was only right while one
    trumpet existed. trumpet-octagonal is getting a mouthpiece and a bell
    too, and it is built on the same 25 x 25mm channel - 31mm outside in 3mm
    ply - so the same parts fit it. Left where they were, the second trumpet
    would either reach into the first one's repository or keep a copy that
    drifts.
    A trumpet is a mouthpiece, a length of tube and a bell. Only the tube
    differs between these two instruments, so only the tube belongs to an
    instrument.
    Files are byte-identical to what trumpet-coiled held, whic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
2026-08-21 Move the bell and the mouthpiece out to trumpet-parts
    They are shared with trumpet-octagonal, which is built on the same
    25 x 25mm channel and takes the same parts. Only the tube differs between
    the two instruments, so only the tube belongs to an instrument.
    27 files leave: bell/, mouthpiece/, and the README and CLAUDE.md sections
    that described them - the bell table, the mouthpiece profile, the
    black-to-red ramp, "a bell file is cut more than once", the hand-nested
    warning and the generator commands. All of it is in trumpet-parts, which
    is where someone cutting a bell will now look.
    This repository is down to what makes it this instrument: nine bore nets,
    the walk they come from, and the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
2026-08-21 Show the cut parts
    The README described 50 plates across 8 sections and showed none of them.
    Every sibling repository leads with a picture of what you get; this one
    had only the interactive bore, which shows the shape and not the wood.
    The photograph also carries the argument the document spends two sections
    making. Every edge in it is a finger joint and every face is flat, and the
    stepped plates are the turns - a section carrying its own corner. There
    is no elbow in the pile because the design has none, which is easier to
    see than to read.
    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
2026-08-21 Offer "Read the writeup", as every other active repository does
    The page was already deployed and linked from nowhere. The README is now
    consistent with torus-octagonal, living-hinge, slapstick and the rest.
    Audits 9/9 on README, 16/16 on the page.
2026-08-21 Correct bell.py's docstring: four lengths, and not a horn
    It claimed "the same 201mm horn as 67 rings of one". Two errors. The
    bells measure 210, 210, 204 and 201mm - stacking plies coarsens the steps
    but does not hold the length, because a whole number of rings at each
    rise lands somewhere different. And only trumpets are being built here,
    so Bessel profile rather than Bessel horn.
    This is where the wrong figure in the README came from; that was
    corrected on the page days before its source was.
    Docstring only. Generating all four bells with the old file and the new
    one gives byte-identical output, so nothing needs recutting. The desc
    string at line 59 still says "Bessel horn" and stays: c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
2026-08-24 The ports failure is 16 checks, not 13
    Verified by running it. The gate has gained checks since the number was
    written; it now fails across five names - plates mirrored, section closes
    round its bore, wall fingers unengaged, seam gender, and seam has no port
    - naming the three ported sections and all four seams.
    It could not be verified at all until today: --ports never reached the
    gate, so the run reported 0 failed. Fixed in bore-generator.
2026-08-24 Unspaced mm, the channel and ZIP links, and one file I should not have committed
    The house style across every other repository is 31mm; this one and
    bore-generator were the two using 31 mm, both inheriting their text from
    octomino-snakes. Converted at the source rather than only in the prose:
    viewer.py and bore_split.py emitted the spaced form, so 42 viewer pages
    carried it too and are regenerated. Volumes keep their space - 38,750 mm3
    - matching trumpet-parts writing 0.49 m².
    Adds the LaserMadeMusic link and a download-as-ZIP link, which every
    build repository has and this one did not.
    And untracks small_trumpet.svg. I committed it two commits ago with git
    add -A, which is exactly what t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
2026-08-24 Offer the cut files as a ZIP
    Every other build repository does; this one did not.
2026-08-24 Add small_trumpet.svg, and say what is wrong with it
    Tracked deliberately this time. It is a hand-nested sheet - 209 x 254mm,
    24 finger-jointed plates, sections 2 and 5 engraved - doing the thing
    nest.py does not, which is putting two small sections on one sheet
    instead of two.
    It is not ready to cut, and the README says so. Twelve of its
    twenty-four paths declare a stroke twice and disagree: #ff0000 in a style
    property against #000000 in an attribute. Inkscape and a browser take the
    style and draw red; an importer reading the attribute takes black. Red is
    not a cut stage here, so a per-colour job skips those twelve without
    saying anything - half the sheet.
    Which way to resolve it is the a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
2026-08-24 Do not track small_trumpet.svg
    Backed out of the previous commit. The file stays on disk, untouched and
    untracked, along with its stroke conflict; the README section describing
    it is gone and so is the ignore entry that section needed.
2026-08-24 Commit small_trumpet.svg — the airtightness test sheet
    Deliberately this time, and with the reason recorded. Its entrance and
    exit are flat, so an assembled bore can be sealed at both ends and
    checked for leaks before it is committed to. The generator does not
    produce that; nor does it nest two sections onto one sheet, which this
    does by hand. 209 x 254mm, 24 plates, sections 2 and 5 engraved.
    Its colours are left exactly as they are. Twelve of its paths carry
    #ff0000 in a style property and #000000 in an attribute, so it draws red
    in Inkscape and would cut black through an attribute-reading importer.
    --fix is the wrong tool here: it keeps whichever declaration is winning,
    which would com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
2026-08-24 small_trumpet.svg cuts as one black stage
    Half its plates were stroked #ff0000 in a style property while carrying a
    #000000 attribute: red in Inkscape, black through an importer that reads
    the attribute, and red is not a stage anything here maps - so a
    per-colour job would have skipped twelve plates without a word.
    The 36 red style declarations are now black, and the 24 duplicate
    attributes that agreed with them are dropped. Every outline is black,
    every engraved number still blue, and svg-stroke-check reports nothing.
    Path data is byte-identical to the file as supplied - 24 paths, compared
    before writing and again against the backup - so the geometry is
    untouched and only the colours move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
2026-08-26 Square to round, and a number on every ring
    A bell and a mouthpiece cannot be scaled — the throat is 31mm because the
    bore is, and a ring rises 3mm because the ply does — but the section between
    them was never obliged to stay square.
    bell-round.py makes four bells whose section morphs from the bore's square to
    a round rim, every ring a rounded square: corner radius 0 at station one,
    equal to the half-width at the rim. Rounded squares offset exactly, so a
    ring's outer contour is the next ring's aperture grown by 1.5mm and the seat
    is 1.5mm in every direction, corners included. Area, not width, is held to
    the Bessel profile: a circle inscribed in a square has 21% less of it, so
    rounding a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
2026-08-26 The cup the mouthpiece did not have
    mouthpiece-round.py ends its cup run at ø10.06 opening 0.40mm a ring: a 3.8
    degree half-angle, which is a tube. A trumpet rim is 16 to 17mm across
    inside, so the cup was not shallow, it was absent.
    mouthpiece-cup.py adds it as four rings that stack on a mouthpiece already
    glued — nothing here replaces a cut part. The profile is an ellipse arc
    through the depth-radius plane, whose slope is zero at the rim, so the wall
    stands parallel to the axis where the lip sits and turns toward the throat
    going down. The first ring opens 3.21mm, a 28 degree half-angle; the rim ring
    opens 0.33mm. A cone would meet the rim at an angle and feel like a funnel.
    Every joi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
2026-08-26 The whole mouthpiece in one sheet
    mouthpiece-round.py stopped at ø10.06, so a fresh mouthpiece needed two
    sheets and anyone who did not know that got a tube where the cup should be.
    It now writes all three runs: a 9-ring backbore 25 -> 5mm, a 17-ring entrance
    carrying the 3.66mm throat out to 10.06, and a 4-ring bowl to a ø16.5mm rim.
    Thirty rings, 90mm.
    The bowl is the same ellipse arc mouthpiece-cup.py draws, and the two routes
    are identical ring for ring: the unified sheet's first 26 apertures match the
    26-ring part and its last 4 match the extension, so both number 0..19 then
    1A..1d, 175 engraved strokes either way. A mouthpiece half-built by one route
    can be finished by the other. mo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
2026-08-26 Give the bell a flange, and a lap wide enough to glue
    The bell would not join the bore. Its throat was 15.5 — ø31, the bore's
    OUTSIDE — so ring 0 spanned radius 15.5 to 17.8 while the bore's end face
    spans 12.5 to 15.5, and the two did not overlap at all. The only contact was
    the tube's outer wall against a 2.3mm lip, which is why it was hard to locate
    and why it gapped. The airway stepped 25 -> 31 at the same joint, a 3mm
    shoulder per side.
    The throat is now 25mm square, the bore's own channel, so the airway runs
    straight through. Ring 0 is a flange: a sharp 37mm square with a 25mm square
    hole, covering the bore's whole 3mm end face and standing 3mm proud of it.
    The mouthpiece has don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
2026-08-26 A mouthpiece proportioned like a mouthpiece
    --layout=trumpet puts 75mm into the backbore and keeps a 12mm cup. Same 30
    rings, same 90mm; the length simply goes where a trumpet puts it. The default
    --layout=asbuilt has a 27mm backbore and 51mm of near-cylindrical entrance on
    the LIP side of the throat, which is a 48mm-deep cup by any honest reading and
    close to inverted. It stays the default because a mouthpiece exists to that
    profile and its rings are numbered for it; mouthpiece-round-parts.svg is
    byte-identical to what it was.
    The wall is now per-ring, because a real cup cannot be built without it. A
    ring's outer is its aperture plus two walls, so the seat above it is the wall
    of whichever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
2026-08-29 Cut the twin switchback
    Six sections from N N1 W3 U2 E3 N3 D3 W2 U3 N2, 23 blocks and 713mm of
    centreline, every one a bend. The design folds back twice inside a 4x4
    cross-section and is cut short at both ends so the mouthpiece and the
    bell have somewhere to sit.
    Sections 1 and 4 are the same shape and are cut separately so each
    carries its own engraved number.
    Gate: 194 checks, 0 failed.
    Claude-Session: https://claude.ai/code/session_011FRMJAWStf8HkTcT8w2px2
2026-08-29 Recut section 6 of the twin switchback
    The walk's last term drops from N2 to N1, so the bell section is three
    blocks rather than four: 06_bend_RDD.svg gives way to 06_bend_RD.svg,
    the same shape as section 3. Sections 1 to 5 are unchanged.
    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
2026-08-29 Move the twin switchback out to its own repository
    Its cut files now live in GIT/trumpet-final-youtube-candidate, where the
    other build repositories are, and it is gated there by regress.py. The
    design library keeps the walks it is still the home of.
    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
2026-08-29 Correct the elbow rule, and the page command that names index.md
    Both documents said a window of three terms on only two axes was a fold
    that costs nothing at any spacing. That is true of a step - outer terms
    on the same axis in the same direction - and false of a hairpin, where
    they oppose: U3 N1 D3 buys two elbows, U3 N2 D3 buys none. The rule now
    names all three cases, step, hairpin and coil, at 1, 2 and 3.
    This walk is unaffected. Its one two-axis window, W5 N10 E5, is a
    hairpin with a middle leg of 10, so it was free under the old wording
    and is free under the correct one; the walk still splits into 8 pieces
    with no elbows. The verdict table now says hairpin rather than fold.
    CLAUDE.m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
2026-08-29 Stop keeping the retrofit cup as a sheet
    mouthpiece-cup-parts.svg and its section drawing are deleted. The cup
    rescues one particular mistake - a mouthpiece glued up before the bowl
    existed - rather than being a part anyone sets out to cut, so it is a
    script to run on demand and not a sheet to keep current.
    Both documents stop naming the two files: the retrofit section says to
    run mouthpiece-cup.py, the file list drops them, and the numbering
    command in CLAUDE.md is marked as writing something not kept.
    doc-audit: 16 passed, 0 failed. svg-stroke-check: 23 files, 0 findings.
    Claude-Session: https://claude.ai/code/session_011FRMJAWStf8Hk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
2026-08-31 Add a bell and a mouthpiece for the 10mm bore
    --bore=N on bell-round.py and mouthpiece-round.py sets the air channel
    and derives the plate as N+6, a 3mm wall each side exactly as the tube
    is. Nothing else moves: the ply is still 3mm and a ring still rises 3mm,
    and the mouthpiece throat stays o3.66 because a #27 drill is a real
    trumpet throat -- a mouthpiece is sized by the lip at one end and the
    drill at the other, not by the tube it feeds. bell.py and mouthpiece.py
    do not take it; both have cut parts numbered against them.
    The mouthpiece, 30 rings and 90mm: a sharp 10mm square aperture in a
    16mm square plate, round by station 3 -- 6mm up, against 21mm on the
    25mm one, a 10mm square having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
2026-08-31 Number every bell, and hand the candidate's sheets to the candidate
    No bell here carried its ring numbers -- only the mouthpieces did, and the
    README claimed the 99mm one did too, which was simply untrue. Rings glued in
    the wrong order is rings unglued, and consecutive rings differ by about two
    millimetres, nothing you can judge by eye once the parts are off the bed. All
    eight remaining bells now carry a hex index per ring, added by
    number_rings.py --order=document. Checked by stripping the ring-numbers group
    back out of each file and diffing against HEAD: every cut path byte-identical.
    The four sheets the build-video candidate cuts move to that repository, which
    now holds a whole instrumen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
2026-08-31 Stop claiming to hold parts for every trumpet
    Found by running the thirteen lenses over the four trumpet repositories.
    The opening line said the bell and the mouthpiece were "shared by every
    trumpet in these repositories" and listed two of the three. Since the
    build-video candidate took its own sheets that is neither true nor a
    complete list: this repository holds the generators, and the sheets that
    more than one trumpet cuts. The candidate is now named as making its
    parts with these generators while cutting no sheet from here.
    Two of my own slips from earlier today: "10 × 25mm's little brother"
    should read 25 × 25mm, and two dimensions in the 10mm section used a bare
    x where every table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
2026-09-01 Follow the candidate rename to trumpet-switchback
    The repository next door dropped a name that claimed a decision. The
    prose here pointed at it by that name in both documents.
    Claude-Session: https://claude.ai/code/session_01VzXwLADAvkvDDCs1E3NrBd
2026-09-01 Finish the switchback rename, and drop "the candidate"
    One "build-video candidate" survived the rename pass because it was
    wrapped across a line break. Two bare "the candidate" references were
    shorthand for a name that no longer exists.
    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
2026-09-01 Number the rings by default, as part of writing the sheet
    bell-round.py and mouthpiece-round.py now call number_rings.py
    --order=document as their last step. Numbering used to be a separate
    command you had to remember, and forgetting it was silent: the sheet
    looked finished and the rings came off the bed anonymous. It cost
    mouthpiece-round-parts.svg its numbering on 2026-08-31.
    --order=document, always. A mouthpiece narrows to the throat and opens
    again, so its backbore and its cup pass through the same diameters and
    sorting by size interleaves the two halves. A bell telescopes, so
    document order is already assembly order there.
    --numbers=no writes a bare sheet. If the numbering fails the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
2026-09-02 Let bell-round.py name its own output with --out
    The generated name says how a sheet was made -- which script, what
    length, what bore -- and that is not what someone hunting for a part
    needs to read. Worse, the name only mentions the bore when it is not the
    default, so a 25mm sheet came out with no size in its name at all while
    the 10mm one carried bore10.
    mouthpiece-round.py already took a positional filename. bell-round.py
    took none, so naming its sheet meant renaming the file afterwards --
    exactly the remember-to-do-it step that cost this repository its ring
    numbering once already. --out closes that.
    It refuses without a ring budget, since a bare run writes four sheets
    and one name woul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
2026-09-02 Name a mouthpiece by its bore AND its layout
    Two 25mm mouthpieces exist and nothing told them apart. Same ring count,
    same bore, same throat, same rim, and character-for-character identical
    <title> text -- while their profiles are nothing alike: 9 backbore rings
    plus 17 entrance rings in the asbuilt layout, against 26 backbore and no
    entrance in the trumpet one.
    The cause was naming only the parameter that was not the default. That
    left the asbuilt sheet called mouthpiece-round-parts.svg -- no bore, no
    layout -- and gave the trumpet sheet in trumpet-switchback no way to say
    it was not that one. Yesterday's rename there made it worse: dropping
    "trumpet" from the filename removed the only thi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
2026-09-02 Every bell name states its length, and its bore where it has one
    The last of the name-only-the-non-default asymmetry. A bell's length
    appeared in its filename only when it was not 201mm, and bell-round's
    bore only when it was not 25mm, so:
    bell-round-67rings.svg said neither
    bell-round-99mm-11rings.svg said one of the two
    Two bells of the same ring count differ by exactly these and by nothing
    else a name carried. The <title> did not carry the length either, so two
    bells of the same ring count and ply at different lengths described
    themselves identically.
    Both now go in every name and every title:
    bell-round-bore25-201mm-10rings.svg bell-trumpet-201mm-10rings.svg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
2026-09-02 Take in the switchback mouthpieces and bells
    Only the tube belongs to an instrument -- the rule trumpet-coiled has
    stated all along. These four sheets were held in trumpet-switchback on
    the grounds that nothing else cut them, which was true of what had been
    cut and false of what fits: the 25mm mouthpiece and bell suit any 25mm
    channel, and trumpet-coiled and trumpet-octagonal are both exactly that.
    Keeping them there hid two general parts inside one instrument, where
    the other two trumpets would never look.
    mouthpiece-bore25-trumpet-parts.svg
    mouthpiece-bore10-trumpet-parts.svg
    bell-round-bore25-201mm-17rings.svg
    bell-round-bore10-152mm-17rings.svg
    The 10mm pair suit no oth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
2026-09-02 Four passages still said the sheets live in switchback
    Lens 10 across the trumpet repositories. Yesterday's move took the
    mouthpieces and bells out of trumpet-switchback and this repository's
    prose did not follow in four places, each stating the opposite of what
    is now true:
    - "The sheet is no longer kept here -- the only instrument cutting it is
    the switchback trumpet", pointing at 25mm/mouthpiece/, a folder that
    no longer exists, and giving a command naming
    mouthpiece-trumpet-parts.svg, a filename retired the day before.
    - "The 17-ring sheet is not kept here", pointing at 25mm/bell/.
    - "The 10mm sheets are not kept here. Nothing but that one instrument
    uses them."
    - CLAUDE.md tell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
2026-09-02 Bell filenames carry throat, bore, built height, passes and rim
    bell-square25-204mm-17rings-x4-rim145.svg
    bell-round25-210mm-10rings-x7-rim129.svg
    bell-square10-153mm-17rings-x3-rim86.svg
    Five facts a builder needs before cutting, none of which the old names
    carried:
    square25 / round25 which throat, and what it fits. Both bells open to
    a round rim; only the throat differs, and a 25mm
    SQUARE one and a o25 ROUND one are not
    interchangeable. The old "round" and "trumpet"
    named the generator, not the part.
    204mm the height as BUILT, rings x rise. The old names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
2026-09-02 Every bell and mouthpiece sheet now carries the orientation tick
    Hex numbering with a tick, on all thirteen: ten bells and three
    mouthpieces. The tick was added to number_rings.py earlier today and
    held back for the next sheet cut, on the grounds that it helps nothing
    for parts already in wood. It does help the next person to cut one of
    these, which is every sheet here, so they get it now.
    A ring is a circle and has no top. Without the tick, turned over, 3
    reads as E and 6 reads as 9 -- and both pairs appear on every sheet of
    15 rings or more, which was six of the ten bells.
    Verified rather than assumed, on all thirteen: with the title, the desc
    and the engraving group stripped, the cut ge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
2026-09-02 One glyph system: polyline hex on rings and bore sections alike
    number_rings.py drew seven-segment characters; bore_split.py draws
    outlines. Two tables for the same job, and the seven-segment one was the
    worse of the two. It now uses the same sixteen glyphs, so a part off
    either bed reads the same way.
    Measured, not preferred. Condensed to the width the segments used, the
    fit is identical -- 1.78mm on the tightest mouthpiece ring either way,
    and unchanged on every bell, which are limited by their wall rather than
    by label width. What changes is the cost: 2466 engraved strokes across
    the thirteen sheets becomes 1037, 57% fewer, because a 0 is one
    continuous polyline instead of six separate s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
2026-09-02 The bell names had round and square the wrong way round
    Reported from a read of the bell section, and correct. The all-square
    bells were named round and the square-to-round ones square.
    The geometry settles it. bell.py's sheets carry no arc on any ring --
    every ring is a square, throat to rim. bell-round.py's carry arcs on 16
    of 17 rings and finish as a circle. So:
    bell-round25-204mm-17rings-x4-rim145.svg 128 arcs, circular rim
    bell-square25-204mm-17rings-x4-rim129.svg 0 arcs, square rim
    I named them from each generator's own title, and bell.py's title was
    wrong: it described a square 25mm throat and a square 129mm rim as
    "ø25" and "ø129.0mm". Worse, I added the words "roun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
2026-09-02 bell-section.py measured a rounded ring two corner radii short
    Reported from a look at the round bells' section drawings, and right.
    They showed a near-flat taper with the rim ring floating detached above
    and below it, and labelled a 25mm throat "ø5".
    ring_sizes took a shortcut: it read a ring's width straight out of
    "M x,y H x2". On a square ring that is the full width, so the four
    all-square bells measured correctly and their drawings were fine. On a
    rounded one it is only the flat BETWEEN the corner arcs, so every ring
    came out short by two corner radii -- and by more as the rings rounded,
    which is why the profile collapsed toward the throat. The rim ring, a
    full circle with no H at all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
2026-09-02 Mark the cut file as the cut file in its name
    bell-round10-153mm-17rings-x3-rim86-cut-files.svg send this to the laser
    bell-round10-153mm-17rings-x3-rim86-section.svg display only, never cut
    One stem, three suffixes -- -cut-files, -section, -view -- so which file
    does what is in the name rather than in a convention you have to know.
    Until now the cuttable sheet was the one with no suffix at all, which is
    the wrong way round: the file that costs material if you get it wrong
    should be the one that says what it is.
    Thirteen sheets renamed, ten bells and three mouthpieces, and the three
    generators write the suffix themselves so nothing has to be renamed
    after a run. 87 references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
2026-09-03 Cut every ring's aperture before its outline
    Orange #ff8000 takes the aperture, black #000000 the outline, and the
    orange group is written first. Holes before rims.
    Until now a ring was one path holding both loops in one colour, so a
    per-colour job was free to cut the outline first and drop the ring
    before its hole was in. Nothing in the file said otherwise; it worked
    because of the order the two subpaths happened to be written in, which
    is not a thing to rely on.
    All thirteen sheets: ten bells, three mouthpieces. Verified by
    extracting every cut subpath from before and after and comparing them as
    sets -- 13 of 13 keep exactly the same loops, so this re-colours the cut
    and moves no geometr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
2026-09-03 The last two generators join the scheme
    mouthpiece.py and mouthpiece-cup.py still wrote a ring as one path in
    one colour, and named their output without the -cut-files suffix. They
    ship no sheet, which is why they were missed, but a run of either
    produced a file unlike every other one here.
    Both now cut the aperture in orange and the outline in black, and both
    name the sheet -cut-files. Checked by running them: 23 orange and 23
    black on the mouthpiece, 4 and 4 on the cup, numbered in both cases.
    That makes it five generators of five, and thirteen shipped sheets of
    thirteen, on one scheme: polyline hex numbering with a tick, holes
    before rims, and a name that says what the sheet is for.
    Co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
2026-09-03 Numbering ran rim to bore, not bore to rim
    Reported from the 10mm bell open in Inkscape, and correct: the sheet
    read 9, 10, F, E, D across the top row where it should read 0, 1, 2, 3,
    4. Every ring on all thirteen sheets was numbered backwards.
    Mine, from this afternoon. Splitting each ring into an orange aperture
    and a black outline meant number_rings.py could no longer find a ring as
    one path with two loops, so it pairs the two paths instead -- and I
    walked the candidates largest first, so an outline would claim its own
    aperture rather than a smaller ring's. That is the right order to pair
    in and the wrong order to keep: the list came out largest-first, and
    --order=document numbers in lis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
2026-09-03 asbuilt becomes legacy, and trumpet becomes the default
    Two problems with one name. "asbuilt" said when the profile was made,
    not whether to cut it -- and it was the default, so a bare
    mouthpiece-round.py produced the profile the generator's own docstring
    calls "a 48mm-deep cup by any honest reading".
    --layout=trumpet 75mm backbore, 12mm cup (default now)
    --layout=legacy 27mm backbore, 51mm entrance, 12mm cup
    The legacy sheet stays, because a mouthpiece was built to it and its
    rings are numbered for it. It is a record of a part, which is what the
    name says now.
    --layout=asbuilt exits with what changed rather than failing as an
    unknown value, so a recorded command from be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
2026-09-03 Both view generators were broken, and are now run
    Asked to render the bell and the mouthpiece. Both already had a view generator
    and neither could read its own cut files.
    On 2026-09-03 the apertures moved into their own orange group so they cut
    before the outline that frees the part. Both generators found a ring by looking
    for one path holding two subpaths, so after the split they found none: ten
    bells and three mouthpieces, all silent, because nothing ran them afterwards.
    mouthpiece-view.py was broken twice - it also opened a file by a name that was
    changed the same day.
    They now read the two groups and pair ring i's aperture with ring i's outline
    in file order, which is what the generato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
2026-09-04 Bells and mouthpieces you can turn
    The two view generators here each draw one fixed isometric. Asked for something
    rotatable, which is what every bore in the project has and no part did.
    part-view.py builds the stack as a solid - the outside band, the bore band and
    the top annulus of every ring - and writes <name>-turn.html beside each cut
    file. Same engine as the bore viewers in bore-ribbon: drag to turn, scroll to
    zoom, colour by face or by ring, and a slider that stacks it a ring at a time.
    Thirteen pages, one per sheet, from 868 quads on a ten-ring bell to 5656 on the
    sixty-seven-ring one.
    It reads the ring sizes with bell-view.py's own sections(), executed out of
    that file rather than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
2026-09-04 Retire the 25mm bell and mouthpiece
    Fifty files: five round bells, four square ones, two mouthpieces, and every
    section, isometric and turn page belonging to them. Two of the fifty carried no
    25 in the name - mouthpiece-view.jpg and mouthpiece-section.svg are drawings of
    the legacy 23-ring 25mm design, so a name filter would have left them behind.
    What is left is one bell and one mouthpiece, both 10mm. The README is a 10mm
    document now rather than a 25mm one with a 10mm appendix: the lede, the fits
    table, the two sheets and the Files list are rewritten, and the 25mm bell
    sections are gone.
    The generators are untouched and still take --bore, so a 25mm sheet is one
    command away and git has t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
2026-09-04 Ignore xTool project files
    *.xs is the laser's working format: written beside the cut files when a sheet
    is set up to run, large, binary, and regenerated from the SVG every time. The
    SVG is the source. bore-ribbon got this line on 2026-09-03 when two turned up
    there; this is the rest of them, so the next one is caught wherever it lands.
    No repository here tracks a .xs, so nothing is un-tracked by adding it.
    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
2026-09-04 Describe the figure that is actually there
    The alt text was written from the generator rather than from the rendered
    sheet: the bell's rings sit in rows, not nested inside one another, and the
    coupon is separate plates in a row, not one strip. Checked against the
    published preview this time.
    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
2026-09-04 Delete the 25mm as-built mouthpiece sheets
    They were removed from the index in the 25mm retirement and left behind in
    the working tree, where nothing referenced them and no check could see them.
    Git still has them at 6002947^ if they are wanted back.
    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
2026-09-05 Collapse the forked toolchain into tools/
    bore-stretched carried its own copy of assemble, bore_split, check,
    regress, viewer, svgpath and bore_render. Five of the seven had drifted:
    bore_split by 369 lines, viewer by 152, regress by 189.
    The fork was a generalisation, not a divergence -- cell indices became
    real mm boxes so a straight block can run longer than a turn -- so the
    stretched copies are promoted here and the fork is deleted. Verified
    before promoting: all 24 uniform designs pass on the stretched toolchain
    with check counts identical line-for-line, and the switchback bore
    regenerates byte-identical in geometry, the only difference in the file
    being one <desc> string that gains a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
2026-09-05 Rewire cross-repository paths for the merged layout
    Nine repositories that referred to each other as siblings are now one
    tree, so every ../<repo> had to be recomputed from where the file
    actually sits: 71 references across 12 files, each resolved against the
    referring file's own directory rather than substituted blindly.
    The design library moves with them. It was ../../test -- outside every
    repository, which is why the toolchain reached two levels up to find it
    -- and is designs/ here.
    Two of these were not documentation. spirals/tools/run_checks.sh opened
    with an absolute cd into /Users/michael/LaserMadeMusic/GIT/bore-generator
    and set R to an absolute path beside it; both are relative t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
2026-09-05 Regenerate three viewer pages onto the current format
    first_trumpet, hilbert_open and wide_telescope were all written
    2026-08-23 and still carried the old single-model viewer (const D)
    instead of the current multi-set one (const SETS, const REF).
    Nothing had caught it because check_page lived only in the stretched
    fork, so the uniform designs were never page-checked at all. Merging the
    two runners pointed it at all 28 designs and these three failed
    immediately. Regenerated with viewer.py rather than a full --write, so
    the committed per-piece renders beside them are untouched.
    28 designs, 9135 checks, all pass
    Claude-Session: https://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
2026-09-05 Commit the per-piece renders that were never in git
    bores/switchback and bores/stretched carried their per-piece renders as
    untracked files in a working tree and nowhere else, so the subtrees did
    not bring them and the merged repository gated 9027 checks where the
    working trees gated 9135. A fresh clone of either repository had never
    produced the higher number either -- the gate has been reading files that
    were not in the history it was gating.
    bores/coiled and every folder under designs/ commit theirs, so this makes
    the tree consistent rather than introducing a new convention.
    parts/mouthpiece/mouthpiece-section.svg was untracked the same way, since
    2026-08-11.
    28 designs, 9135 checks,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
2026-09-05 Point every link inside the tree at trumpet
    99 URLs across 19 files still named the nine repositories this one
    replaced. They were merely stale when the merge landed; deleting those
    repositories made them dead.
    Four shapes, three of them mechanical: a bare repository link becomes
    /tree/main/<path>, a /blob/main/ link keeps its file below the new path,
    and a Pages link becomes gernreich.github.io/trumpet/<path>/.
    The fourth was not mechanical. Eight writeups each offered "Download
    everything as a ZIP", where everything meant that repository -- "the cut
    file and the page it regenerates from", "the nine bore nets". One archive
    covers all nine directories now, so each of those sentences was re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
2026-09-05 Bring the octagonal torus into the tree
    bores/octagonal is the torus opened out into a curve: the same 25 x 25mm
    channel, and literally the same R 90 plate. Its README said so and proved
    it by linking at verify_torus.js in another repository, which is the
    cross-repository dependency this merge exists to remove.
    torus/ sits beside bores/ rather than inside it, because a torus is not a
    bore. The five bores stay grouped.
    The shared-plate claim is now checkable without leaving the tree, and was
    checked:
    cd torus
    node verify_torus.js ../bores/octagonal/octagonal-trumpet.svg \
    ../../torus/RunA2_R59Point693.svg
    -> COMPLEMENTARY the plate's tabs land in the panel's notches
    That secon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
2026-09-05 Fold in greek-spiral, and clear ten workflows that did nothing
    greek-spiral is a trumpet: a flat meander, the Greek key wound in and
    brought back out beside itself, 68 blocks and 1088mm of centreline at a
    10mm bore. It never appeared in any survey of the sprawl because it had
    no remote -- one local commit, never pushed -- so it was invisible to
    every listing of the repositories. It was also broken as of yesterday,
    its README carrying six links to trumpet-parts, which was deleted.
    It is finished work, not a sketch: zero elbows, and 85 checks pass. Added
    to the gate, which is what makes it the only design there that splits
    into a single piece with no section seam at all.
    29 designs, 9220 c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
2026-09-05 One writeup for the octagonal form: torus and trumpet
    They were never two designs. The trumpet's plate IS the torus's plate to
    0.001mm, verified COMPLEMENTARY, and the violet lines drawn across the
    torus's plates are the cut that produces the trumpet -- the torus writeup
    already said "take them and the torus comes apart into sections, which is
    how you reach the simple trumpet", and the trumpet writeup already said
    "the torus writeup describes the cut that turns one into the other". Each
    document pointed at the other for the half it did not carry.
    torus/ becomes octagonal/ and bores/octagonal/ dissolves into it, so a
    directory named for a torus no longer holds a trumpet and bores/ holds
    only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
2026-09-05 Regenerate the two designs the collapsed toolchain had outrun
    bores/switchback and bores/greek-spiral shipped cut files made before the
    toolchain fork was collapsed, so their <desc> lacked the clause naming
    the pitch convention. Geometry was identical -- checked before and after,
    excluding <desc> and <title>, on every file.
    The switchback also carried its old repository's name. A cut file's
    design slug comes from its directory, that directory became
    bores/switchback in the merge, and the shipped files still said
    bore10-trumpet-switchback. Regenerating in place therefore produced six
    new files beside six old ones rather than replacing them, which is how
    this surfaced. The old six are gone an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
2026-09-05 Thirteen lenses: restore a dropped section, and four stale claims
    Lens 12 caught the worst of it. The merge that made one octagonal
    writeup was built on the deep document's spine, and the landing page's
    "## Turn it" section was not in that spine -- so torus-turn.html was
    still shipped and published with nothing in the tree referring to it.
    Restored, with its two stale paths corrected, and placed where a reader
    meets both objects rather than at the end.
    Testing the restored section's own command then found more. It does not
    reproduce the shipped file: ribbon_view.py has drawn the plywood cheeks
    alongside the airway for some time, because the airway alone reads as a
    much thinner object than t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
2026-09-05 Lenses 3 and 12: a broken precondition, and files nobody documented
    Lens 3, and this one was mine. Route B tells you two things must happen
    before you send the torus file, "both immediately below". Inserting the
    trumpet section put 123 lines between the first and the second, so a
    reader could pass the violet note, meet the trumpet, and start cutting
    having never reached the cut order -- which is the one that drops a
    plate's uncut panels into the machine. Both are now named, the second
    linked, and the paragraph says outright not to send it having read only
    the first.
    Lens 12, per directory rather than per document. tools/ gained
    snakeboxvar.py, coils.py and four coil walks when the fork was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
2026-09-05 Regenerate the seventeen spiral viewer pages
    They were drawn before the toolchain carried real millimetre boxes, so
    their cells were still lattice indices -- 'p': [0,0,0] where the current
    viewer.py emits 'a'/'b' corner pairs. Not wrong, just the older shape of
    the same data, and the last thing in the tree still speaking it.
    Geometry is unchanged, and that was checked rather than assumed. Block
    count, centreline, segment count and title are identical on all
    seventeen. The cells were then compared as clouds of box centres,
    normalised to each page's own minimum so a change of origin does not
    register: every page describes the same set of blocks.
    Two checks had to be thrown away before that o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
2026-09-05 The 10mm bore is the default, and everything is rebuilt at it
    The bell and the mouthpiece went 10mm-only on 2026-09-03, which left
    nothing to put on the end of a 25mm tube. bore_split.py now defaults to a
    16mm block -- 10mm of air in 3mm stock -- and every design that was cut
    at 31mm has been rebuilt at it.
    Rebuilt: designs/first_trumpet, hilbert_open, wide_telescope and
    metre_spring; bores/coiled; the 25 illustration pages under designs/;
    and all of spirals -- parts.json, reduced.json, the 17 viewer pages and
    the four generated documents. The six designs already at 10mm are
    untouched.
    Topology is a property of the walk and did not move: piece counts,
    distinct shapes, rhythm and elbow coun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
2026-09-06 Say when the joint clearance is a guess, and give back --play
    pin_play() returned the fallback value silently. The fallback itself is
    right -- a bore nobody has cut gets the small-joint figure, because too
    loose is a worse joint and too tight is no joint at all -- but it came
    back indistinguishable from a measured one, so a sheet could be cut at a
    clearance never tested with nothing saying so. It now names the bore and
    the figure on stderr, once per bore per run. stdout is untouched, which
    matters because parts.js parses it.
    Acting on that turned up worse. --play and --tag do not exist. They were
    lost on 2026-09-05 when the stretched fork's bore_split.py was promoted
    over bore-generator's: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
2026-09-06 The three-turn coil is built, and it plays F4
    Photograph added by the author: cut, glued, finished, with a mouthpiece at
    one end and a bell at the other. 1096mm of 10 x 10mm bore sounding F4.
    That retires two claims. The README opened by calling this a test and not
    an instrument, and carried a section headed "What is missing: a
    mouthpiece and a bell" whose first line was "a coil on its own does not
    play". One of the four coils now does.
    F4 is recorded rather than derived, because a plain tube does not predict
    it: 349.23Hz sits between a bare 1096mm column's second mode at 313Hz and
    its third at 469Hz. Read the other way it wants 982mm as an open pipe's
    second mode, 10% short of the bore, o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
2026-09-06 Delete the 36 orphaned short-named cut files
    Five folders held both namings: 01_bend_DL_buttin.svg beside
    bore10-coil-10x10x30-3t-01of12-bend-DL-buttin-cut-files.svg, one pair per
    piece, across the four stretched coils and the switchback bore.
    The short names are what bore_split.py wrote before 2026-09-03, when the
    design's name went into the file's name. switchback's own CLAUDE.md
    already says what should happen to them -- "that rename orphans files,
    and the gate counts them ... no longer written by anything and had to be
    deleted by hand" -- and these are the ones nobody deleted.
    They were mine. I committed all 36 earlier today under "the per-piece
    renders that were never in git", having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
2026-09-06 Refresh four design transcripts against a live run
    These four READMEs quote bore_split.py's own output, and the quotes had
    gone stale twice over: the filenames were the short pre-2026-09-03 form
    that nothing writes any more, and every figure derived from the block
    pitch still described the 25mm bore. Only the block counts and the
    centrelines were right, because those were fixed when the bore moved.
    Everything else came from a run rather than from arithmetic on the page:
    wide_telescope 10 sections -> 9, 72 parts -> 68, 14 sheets -> 9,
    354 checks -> 290, envelope 310x403x341 -> 160x208x176
    metre_spring 154 checks (was 169), envelope 155x403x155 -> 80x208x80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
2026-09-06 Restructure: a trumpet is a mouthpiece, a bore and a bell
    The top level was five siblings that did not say how they related --
    bores/, designs/, spirals/, parts/, tools/ -- with parts/ meaning only
    the two ends and the tube filed somewhere else entirely. It now says the
    thing the project has been repeating since the first writeup: a trumpet
    is a mouthpiece, a length of tube and a bell, and only the tube differs.
    parts/mouthpiece/
    parts/bell/
    parts/bore/built/ exists in plywood
    parts/bore/concept/ exists as a walk and a cut file
    walk/elbows/ a turn stranded as its own piece
    walk/no-elbows/ every turn folded into a piece
    s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
2026-09-06 Give every swept-curve bore its own directory, cut files apart
    swept-curve held one flat ribbon/ folder of 28 cut files, 10 pages and two
    generators, with the bore a file belonged to legible only from its name.
    It is now a directory per curve type, a directory per bore inside that,
    and the four cut files of each bore in a cut-files/ of their own:
    swept-curve/
    coupon/ opposed/ serpentine/ wave/
    spiral/
    ribbon-spiral-bore10-45deg-R35to113/
    ribbon-spiral-bore10-45deg-R36to144/
    ribbon-spiral-bore10-45deg-R74to144/
    cut-files/
    Seven bores, four cut files each. ribbon/ itself is gone: the generators,
    the writeup and traces/ and volute/ sit at swep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
2026-09-06 Remove four bore folders and the first trumpet's photograph
    three_block_turn, hook_check, doubled_walk, hilbert_snorkel and
    first_trumpet/trumpet_bore.png, as asked. Five files across four folders.
    Their six links in the concept writeup are repaired rather than left
    dangling, and nothing was lost doing it: three carried the walk as their
    link text, so unlinking left the walk in the prose, and three named the
    snorkel, so unlinking left the name. The sentence that sent a reader to
    the snorkel's "own page" now just gives the walk, which the paragraph
    already printed in full immediately below it.
    WHAT I DID NOT REMOVE, because it was not under bore/ and is not a
    figure: three of these are stil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
2026-09-06 Retire hilbert snorkel, hook check and three block turn from the gate
    The pages went in the previous commit; the designs go here. Three rows
    out of regress.py with their comments, and three walk files out of
    tools/walks.
    29 designs, 9047 checks -> 26 designs, 7681 checks
    That is 1366 checks, and 1256 of them were the snorkel alone -- it was
    the second largest case in the corpus. What goes with it is coverage of a
    138-block walk with 20 elbows, which was the densest folding the splitter
    was regularly asked to do. hook check and three block turn were the two
    smallest turn cases, worth 58 and 52.
    Six figures elsewhere had to follow, and the last three were not
    substitutions:
    - the cos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
2026-09-06 Restore octagonal/, which I deleted by accident
    All 24 files -- the merged torus-and-trumpet writeup at 1248 lines, both
    cut files, the three generator runs, verify_torus.js and the diagrams --
    were removed in "Delete concept/pages, the 25 figures of the old
    writeup", which had no business touching them.
    The cause was `git add -A` at the end of that commit. The directory had
    already left the working tree during the swept-curve restructure, when I
    reset and replayed the moves, and staging everything then recorded a
    deletion I never asked for. The commit message describes what I meant to
    do and the diff did more.
    Restored from that commit's parent and checked rather than assumed: 8
    checks pa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
2026-09-06 Remove octagonal/, now that it lives outside the repository
    The author moved it to ~/LaserMadeMusic/octagonal. Checked before
    deleting rather than after: 24 files there, byte-identical to the 24
    here, previews included.
    Four documents described it as a place you could still reach. parts/
    pointed at `../octagonal` for the other bore on the 25mm channel, and
    coiled and switchback both listed `torus-octagonal` and
    `trumpet-octagonal` among the sibling repositories, which they have not
    been since this morning's merge. parts/ also still said its two ends
    serve a 25mm channel; every bore under bore/ has been 10mm since the
    conversion, so one bell and one mouthpiece now serve all of them.
    Mention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
2026-09-06 Every group of cut files gets its own folder
    Thirteen bores had their sheets loose beside their viewer page. Each now
    has cut-files/ under it, holding only sheets, with the page left in the
    bore folder where it belongs. 96 files moved.
    The gate had to be taught the split. check.py globs one directory and
    does not recurse, so it is pointed at cut-files/, while check_page is
    pointed at the bore -- one path in DESIGNS, two uses, rather than two
    paths that can drift apart. A bore with no cut-files/ now fails by name
    instead of being checked against an empty glob, and that guard caught
    greek-spiral, which I had left out of my own list.
    MORE IMPORTANTLY, THE GENERATOR PRODUCES THE LAYOUT NOW. bo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
2026-09-06 Name every walk bore for its shape, with the family as a directory
    Fourteen bores under walk/ were named in six different ways -- the shape
    (coiled, switchback), a property of the lattice rather than the bore
    (stretched), a superlative (tightest_coil, wide_telescope), a
    mathematical object (hilbert_open), a metaphor with a measurement
    (metre_spring), and a historical fact (first_trumpet) -- across three
    separator conventions, nine underscored against a repository that
    hyphenates everywhere else.
    Each is now <family>/<what distinguishes it>, and the family is a
    directory:
    coil/ flat-drop square-rise1 square-rise3 three-side minimal
    search
    meander/ first fold2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
2026-09-06 Cut-file names follow the bores into their families
    The rename put a bore's identity in its family directory, and
    bore_split takes the filename slug from the leaf. So regenerating
    hilbert/open would have emitted bore10-open-..., and meander/first
    bore10-first-... -- names that say nothing on a sheet lying on the bench.
    folder_stack already climbs past a folder that names nothing, which is
    how trumpet-coiled/bore came out as a useful title rather than "Bore".
    It borrows a family parent the same way now, so the eleven cut-file
    groups are named for what they are:
    bore10-hilbert-open-01of27-... was hilbert-open, drifted to open
    bore10-meander-first-01of08-... was first-tru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
2026-09-06 Promote the seven category winners out of coil/search
    search/ held seventeen coils where every sibling held one bore. The best
    in each of the eight categories the repository already scores is now a
    sibling of its own, and the other ten stay as the corpus they came from.
    The winners were computed with the project's own metrics, not chosen:
    3x3-51 smallest box 459
    3x7-22 tightest spiral 65mm rise per turn
    5x5-50 least tube per turn 15.1 blocks
    3x3-54 fewest pieces 30
    smallest box with no shared wall 486
    2x2-134 fewest distinct shapes 2
    5x8-18 large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
2026-09-06 Each promoted coil says why it was promoted, and at the right pitch
    The seven had a walk, a page and a check log, and nothing saying why they
    were siblings rather than search results. The reason lived only in a
    commit message, which is no use to someone looking at the folder. Each
    now carries why.txt: the categories it wins, the figure, the walk, and
    the metrics recomputed from that walk rather than transcribed.
    Their files also still carried the old identifier -- coil_3x3_51.txt
    inside a directory called 3x3-51 -- which is the drift the last commit
    removed everywhere else. Renamed.
    WRITING IT DOWN FOUND TWO THINGS.
    spiral_metrics.js had `const MM = 31`, a second copy of the block pitch
    t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
2026-09-06 The bell and mouthpiece default to the 10mm bore
    bell-round.py and mouthpiece-round.py still opened at BORE = 25.0, so a
    bare run wrote parts for a tube nothing in this repository cuts. The
    conversion on 2026-09-05 moved bore_split.py's default and stopped there;
    this was the second copy of the number, the same way spiral_metrics.js
    was a third.
    PLATE was never the problem, though it is what the grep found. Both
    generators recompute it as BORE + 6 the moment the arguments are read, so
    the 31.0 at the top was only an initial value -- correct once, and
    misleading since. It is 16.0 now and still derived.
    Verified against what is shipped rather than by reading:
    mouthpiece-round.py --rim=17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
2026-09-06 Eight 3D renders were still drawn at the 25mm block
    The author spotted it by eye -- the bores did not look thin enough -- and
    the pages carry their own geometry, so it was checkable: blocks and
    centreline are both in the data, and their ratio is the pitch.
    Eight of the forty-eight lattice renders were still at 31mm. Every one is
    an html-only design with no cut files, which is exactly why the 10mm
    conversion missed them: it regenerated the folders regress.py names, and
    these have no folder to name.
    elbows/coil/minimal 22 blk, 682mm now 352
    elbows/coil/square-rise1 40 blk, 1240mm now 640
    elbows/spiral/expanding 95 blk, 2945mm now 1520
    elbows/spi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
2026-09-06 10mm is the only bore: no 25/31mm left in code or prose
    The octagonal work leaves the repository. ribbon-torus-bore25-45deg-R76.html,
    ribbon-traced-octagonal-trumpet-bore25-45deg.html and traces/octagonal-trumpet.json
    move to ~/LaserMadeMusic/octagonal, which is deliberately not a git repository.
    --shape=torus and --trace= stay: they are general, and the next closed ring or
    measured curve will want them. traces/ keeps volute.json.
    Defaults follow. bell.py and mouthpiece.py - the square pair, which ship no cut
    files - go to BORE 10.0, PLATE 16.0, RT 5.0. sizes.py holds one row.
    PLAY_BY_BORE is {10.0: 0.025} in both bore_split.py and ribbon_bore.py, and the
    clearance note stands on the 10mm b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
2026-09-06 Second 25/31mm pass: the ones that were live code, not prose
    The first pass swept what said "25mm" or "31mm". This one swept every bare 25
    and 31, which is where the arithmetic was hiding.
    Live code that was still cutting or printing at the old pitch:
    - mouthpiece.py was BROKEN, by my own previous commit. PLATE moved to 16 while
    cup[0] stayed at a 25mm aperture, so station one's hole was wider than its own
    plate and the seat check refused to write: "station 2 falls through station 1".
    The cup is now derived - BORE down to a 5mm neck over NCUP stations - so it
    cannot be left behind by a change to BORE again. Runs, 23 rings, 10 -> 3.66 ->
    10.06mm.
    - hilbert.py multiplied block coun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
2026-09-06 verify_bell.py reads the two-group sheet, and says what is wrong
    A ring became two paths on 2026-09-03, when the apertures moved into their own
    orange group so they cut before the outline that frees the part. This tool went
    on looking for one path holding two big subpaths. It found none, fell through to
    "only 0 concentric-square ring(s) - a section drawing or a sheet of something
    else", and SKIPPED with exit 0. Every bell sheet since has gone unchecked while
    the tool reported success.
    Rings are now paired by CONCENTRICITY and size, smallest first:
    - not by colour, which would hard-code the generator's palette into a tool whose
    whole job is checking sheets somebody has edited;
    - not by fi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
2026-09-07 fold2 loses its size level, and switchback loses its name
    Two leftovers from the consolidation, both of which made this design read as a
    repository rather than as one entry in a library.
    THE SIZE LEVEL. fold2 was the only design under no-elbows/ shaped
    <design>/<size>/bore/; every sibling is <design>/bore/. That level existed to
    hold two pitches side by side and there has been one since 2026-09-03. Collapsed
    to fold2/bore/. The machinery that would put it back is untouched —
    --blocksize, sizes.py, and folder_stack climbing past a size folder on the way
    to a name — so a second pitch is still a mkdir away.
    All six cut files regenerate BYTE-IDENTICAL from the new path: the sheet names
    are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
2026-09-07 Generated sheets go in cut-files/; the command block runs
    Every reader in parts/ looks in cut-files/, and the generators wrote beside
    themselves. Running the command block in parts/CLAUDE.md therefore dropped 22
    loose sheets into parts/bell and parts/mouthpiece that nothing read and the next
    `git add` would have committed. Five generators now place a GENERATED name via
    in_cut_files(); a name the caller gives is still used exactly as given, wherever
    it points.
    The readers move the other way. A section, view or turn drawing is not a cut
    file -- send one to a laser and it is scrap -- so display_out() climbs back out
    of cut-files/ to the part's own directory, dropping the "-cut-files" the sourc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
2026-09-07 One README, one page: the trumpet writeup
    The site has been dark since 2026-09-05, when every README.md and index.html
    came out pending one writeup for the trumpet as a whole. This is it: README.md
    at the root, index.html generated from it by md2html.py, and nothing else.
    Every number in it was recomputed from scratch and asserted against the
    document, not copied from anywhere -- geometry from bore_split's own constants,
    the walk rebuilt term by term, and the bell, mouthpiece and gate figures taken
    from live runs of the three tools. 22 claims verified that way, plus the coil
    table traced back to each why.txt.
    TWO THINGS THE VERIFICATION CAUGHT, both of which I had written down wrong:
    - I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
2026-09-07 Lenses 9-13 across the eight CLAUDE.md files
    The cross-document lenses, which compare documents with each other and with the
    repository rather than reading one in isolation. Everything below was tested, not
    inspected.
    LENS 9 -- THE SAME FACT STATED TWICE. Four stale check counts, each contradicted
    by a live run:
    fold2 "213 checks, 0 failed on this bore" -> 195
    fold2 "194 checks still say pass" -> 195
    flat-drop "253 checks on this design" -> 251
    fold2-long-str "still passes 392 checks" -> 393 on the 3t
    tools "reports 194 checks and 0 failed" -> 195
    Three of the five are off by exactly one, which is th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
2026-09-07 The "Read the writeup" link no longer publishes on the writeup
    It linked to the page you were already reading. Reported by the author, having
    been visible on gernreich.github.io/trumpet since the previous commit added it.
    md2html.py already provides the mechanism -- an HTML comment, <!-- readme-only
    -->, drops the paragraph after it from the generated page while GitHub renders
    the comment as nothing, so the README keeps the link where it is useful. I added
    the line without the marker. living-hinge, the one sibling that already had this
    line, uses the marker correctly; I copied the line and not the marker.
    Verified: the page has 0 occurrences, the README still has 1, and the audit is
    21/21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
2026-09-07 Contact/no-contact division; turn counts measured; F4 recorded
    FOUR CHANGES, all of which make a name match what was measured.
    1. CONTACT. A walk is now filed by whether the bore comes back and touches
    itself: two blocks sharing a face, an edge or a vertex without being joined
    along the tube. The library reads
    concept/walk/<elbows|no-elbows>/<family>/<contact|no-contact>/<design>
    The threshold is not arbitrary, and the first one I tried was wrong. Counting
    contact between blocks TWO apart files every walk under contact -- even the
    three-block test walk -- because blocks two apart are edge-neighbours at every
    single turn. That is the geometry of turning, not the bore touching itself.
    M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
2026-09-07 Add the channel link: the one parity gap across seven repos
    Lens 13, the cross-repo matrix: writeup link, site index, ZIP download, channel,
    licence line, root LICENSE, file table. Six of the seven build repositories carry
    all seven. trumpet carried six -- it was the only one without a link to the
    channel the work is made for. An omission, not a decision.
    Audit: 22 passed, 0 failed, with --links.
    Claude-Session: https://claude.ai/code/session_01VaH1kJimapkobcic3MkejG
2026-09-07 Add --shape=dspiral: two spiral arms interleaved about one centre
    1506.4mm of 10 x 10mm bore on a 237 x 244mm cheek plate, 42 facets of 30
    degrees, 84 wall panels and two cheeks across two sheets. Plain and ported,
    as every other design in this folder ships.
    Arm B IS arm A turned through 180 degrees, so the gap between neighbouring
    passes is half the radial pitch by construction rather than by search. The
    cheek is a 20mm band, so 46mm a turn is the first pitch that clears it and
    the passes come out 23.00mm apart.
    Its vertices sit on a smooth Archimedean spiral sampled every facet rather
    than on stepping-radius arcs. The note beside --shape=spiral calls that the
    one construction offset() ca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
2026-09-07 Give the wave and the spirals their own facet angle
    FACET defaults to the coupon's 30 and both are 45 degree designs, so a bare
    --shape=wave built arcs that do not close and reported six check failures,
    not one of which said "facet", and a bare --shape=spiral refused because 17
    facets turn 480 degrees at 30. Neither was a wrong number; the default was
    simply the wrong shape's.
    FACET_BY_SHAPE carries the angle a shape is drawn at, applied only where the
    caller has not passed --facet -- the same guard the opposed lobe already
    uses. dspiral's own default crossover radius moves 28 -> 30 for the same
    reason: it was cut at 30, and a bare run refused on a 9.77mm inner panel.
    All six shapes now bu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
2026-09-07 Engrave the wall length when a design has only one section
    You noticed the greek key marks every wall 1. It does: the engraved number is
    the section number, the greek key is one section of one, so all twenty-four
    parts read the same and the mark distinguishes nothing.
    Not because there is one bend -- its walk turns eleven times. It is one
    section because the meander lies flat, so the whole thing cuts as a single
    plate; the 3D coils need six.
    A single-section design now engraves each WALL with its own length in mm.
    Verified against the parts rather than assumed: the eleven lengths are all
    different, each fits one run of the meander, and the two walls sharing a
    length are the same part, comp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
2026-09-07 Check the folder the sheets were written to, not the one above it
    bore_split.py --write puts its sheets in cut-files/ under the design and then
    handed check.py the design folder. check.py globs *.svg there, found none, and
    its "folder holds cut files" guard failed on every single write -- the guard
    written to catch a filter that matches nothing, matching nothing itself.
    It was not only a noisy failure. Six checks never ran: 79 checks with 1 failed
    becomes 85 with 0 failed, because the per-sheet checks were being skipped over
    an empty glob. That is precisely the case the guard's own comment describes,
    where renaming the sheets once took 194 checks down to 176 and still reported
    0 failed.
    re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
2026-09-07 Revert "Engrave the wall length when a design has only one section"
    This reverts 4923570. You asked what the numbers are for when the cheeks
    carry no matching number, and the answer is that they were half a system: a
    wall marked 163 with nothing on the plate saying which run wants a 163. It
    saved measuring the stick, not finding its place.
    The completing half could not be built honestly. Marking each run on the
    plate needs a reliable wall-to-run match, and three routes failed:
    - from the walk: the plate spans the block grid exactly, but all eight
    orientations reduce to two that each place 68/68 block centres on the
    material, because this walk is point-symmetric. The property that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
2026-09-07 Engrave nothing when there is only one section
    You asked for the 1s gone. Done at the generator rather than by hand, because
    the SVGs beside it are its output and are regenerated, not edited -- a hand
    edit would have come back on the next write.
    A single-section design now engraves nothing at all. The number's job is to
    say which section a loose part belongs to; with one section every part
    carries the same 1, which answers a question nobody can ask. The greek key's
    two sheets have no blue on them now, checked: 0 occurrences, in the drawing
    and in the text.
    The sheet description said "blue #0000ff engraves" on a sheet with no engrave
    stage, so it now says black is the only colour. Multi-sec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
2026-09-08 A centre-first test piece off the dspiral, and a repair to get it written
    --ds-half stops at the centre instead of carrying on into the second arm, and
    runs out from there, so the mouth is the middle of the coil. The crossover is
    the part of this shape that had to be solved rather than chosen, which makes
    it the part a coupon should prove. At --ds-facets=2 that is 195.8mm in 22
    parts on a 111 x 139mm cheek, cut plain and ported.
    The repair came first because nothing could be written without it. Every
    filename literal in the generator had "ribbon/" spliced into it - "-cut-files"
    had become "-ribbon/cut-files", "mm.svg" had become "ribbon/mm.svg", "-ported"
    had become "-ribbon/ported", and th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
2026-09-08 The rest of the path-sweep damage, and the check that would have hidden it
    Sweeping every script and document for what corrupted ribbon_bore.py. The
    splice that hit it -- a directory name glued into a filename literal -- is gone
    from all 476 text files. What the sweep found instead was the same move
    breaking paths a different way, in one directory nobody had run since.
    gen_readme.js writes the "Regenerating" block into README.md, and all three of
    its path defects date from a46c738:
    cd ../tools became cd .
    ../spirals/walks/${name}.txt became ../spirals/walks${name}.txt
    ../spirals/pages/${name}.html became ../spirals/pages${name}.html
    The separator after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
2026-09-09 Finish dressing the double spiral: the four previews and the half's own page
    The 1506mm dspiral shipped without previews -- 36 cut files in swept-curve and
    32 previews, and the four missing were exactly its sheets, plain and ported. It
    was the only bore in the family without them.
    The half-196mm test piece had cut-files/ and nothing else, where every other
    bore directory, the coupon included, holds the page you turn beside the sheets
    you cut.
    Building that page needed two fixes in ribbon_view.py, both the same shape as
    faults already recorded in it. --ds-half was not in its argument table, so it
    was rejected outright -- the third thing this second copy of the generator's
    CLI has lacked tha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
2026-09-09 nest.py's example named a truncated walk and a destination in the tree
    The last of the three usage examples that named a repo path. This one also
    could not be run: "N N10 U2 ..." is the first trumpet's walk with most of it
    elided, so the line as printed was not copy-pasteable in either half.
    It now shows the walk in full and takes the default. That default is worth
    stating, and the old line hid it: --out is a stem, not a filename, and one run
    writes four sheets -- nest_shelf, nest_maxrects, nest_skyline, nest_raster,
    one per packing method, which is the whole point of the tool.
    Run as printed: 4 sheets, all four methods at 1 sheet and 21% used.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
2026-09-09 Sweep the volute: interleave the return arm, and both its problems go
    volute.py recorded two things it could not do and said what the work was:
    "interleaving a return arm so that both ends reach the rim". This is that.
    1. The inner end was enclosed. A volute winds in and STOPS, and that end came
    within 7.75mm of the rest of the bore where it needs 20. There is now no
    inner end: the arm runs rim to eye and the return arm carries it back out.
    2. The ends were not opposed. 24 facets at 45 degrees turn 1035 degrees, and
    opposed needs (F-1) a whole number of turns, i.e. F = 8k+1, which no whole
    number of semicircles gives. It cost nothing in the end. The arm's centres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
2026-09-09 The built trumpet winds three turns, and its mouthpiece is 72mm
    Both corrections come from the person who built it, and both check out.
    THE MOUTHPIECE. 24 rings, not the 30 mouthpiece-round.py cuts: 72mm rather than
    90. The design is unchanged and nothing in parts/mouthpiece is wrong -- the
    instrument is short of its drawing, which is a fact about the object and only
    recordable here.
    THE TURNS. The walk is
    N N1 W3 U2 E3 N3 D3 W2 U3 N3 E3 D2 W3 N3 U3 E2 D3 N1
    and its lateral legs, in order, are W U E D W U E D W U E D -- the circuit
    walked three whole times. Its first and last blocks are at (0,0,0) and
    (0,0,-11): the same point in cross-section, differing only along the axis. A
    path t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
2026-09-09 Name the four coils for the turns they actually make: 0.75, 1.5, 2.25 and 3t
    Restores the names they carried before 2026-09-06. Measurement says those were
    right and the ones that replaced them were a quarter to a half turn low.
    The measure is the angle the lateral position sweeps about the coil's own
    circuit centre. Each group of the walk is three lateral legs, each leg is one
    side of the circuit, so a group is three-quarters of a turn and the four come
    to 270, 540, 810 and 1080 degrees. The longest agrees three separate ways: its
    legs are W U E D three times over, it sweeps 1080.0 degrees, and its first and
    last blocks sit on the SAME cross-section point -- which only a whole number of
    tu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
2026-09-09 Say which curve each shape's vertices sit on: the double spiral is Archimedean, the volute is a chain of semicircles
    The distinction existed only in one source comment. It appeared in no printed
    report, no page, and no writeup -- "Archimedean" occurred exactly once in the
    whole tree, beside DS_PITCH, and a reader of the drawings had nothing to go on.
    The two shapes look alike and are not.
    dspiral vertices sampled every facet off a smooth Archimedean spiral,
    r = R0 + b*theta, so the radius differs at every vertex
    volute a chain of semicircles of stepping radius about two alternating
    centres, the radius holding all the way across each arc
    It shows in the loca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
2026-09-09 Trim the wall panels so their corners stop jamming at every mitre
    Reported from the bench: the dspiral halftest was cut, and where the walls meet
    at less than 180 degrees the panel corners butted before anything could seat.
    It is real, it is in every ribbon bore shipped, and it is arithmetic.
    A panel end is a SQUARE cut -- a laser goes through the sheet and cannot mitre
    one -- and the offset polyline is the wall's CENTRELINE, so two neighbours have
    THICK/2 of ply either side of the point where their centrelines meet. On the
    concave side each runs past that point by (THICK/2)tan(phi/2), and the two
    corners collide. The overlap is THICK*tan(phi/2):
    30 degree facets, 3mm ply 0.804mm a j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
2026-09-09 Audit every check against geometry it should reject; three could not fail
    The halftest was cut with eleven checks passing and its corners jammed, so each
    check was given something it ought to fail. Seven do. Three cannot, and one of
    those was the headline.
    CANNOT FAIL
    the airway is the bore along every facet
    compares two offsets of ONE polyline, which are parallel to each facet at
    a fixed separation by construction. It returns 10mm for a straight line,
    for a hairpin tighter than its own wall, and for a zigzag reversing at
    every vertex. Kept -- it is the arithmetic of the section and would catch
    a mistake in offset() -- but it is not evidence.
    the shortest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
2026-09-09 The gate never compared the cut files with the walk
    Auditing check.py the way ribbon_bore.py was audited: hand it something wrong
    and see whether it says so.
    the built trumpet, all twelve sheets 393 checks, 0 failed
    with one of the twelve deleted 390 checks, 0 failed
    pointed at another coil's three sheets 366 checks, 0 failed
    pointed at an empty folder 357 checks, 1 failed
    Only the last was caught. A whole section of the built instrument can be missing
    from the folder, or the folder can hold a different bore entirely, and the gate
    reports a clean run -- quieter by a few checks, which is exactly the tell that
    was already written down here: renamed sheet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
2026-09-09 --blocksize was silently overwritten by --bore; audit of bore_split's guards
    Continuing the audit into bore_split.py: twenty-one guards, each given an input
    it should refuse.
    Nearly all hold. A stray character, a walk that reverses instead of turning, a
    walk too short to have a direction, a walk that revisits a cell, a zero-length
    run, a one-cell piece that is not a cube, a notch narrower than its own play, a
    notch that leaves no ply beside it, and --refuse-elbows against a walk that
    strands a turn -- all refuse, naming the block or section at fault.
    Two probes came back clean and were wrong, not the guards. The notch guards sit
    behind a path a walk with no notched joint never reaches, and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
2026-09-09 Audit volute.py and ribbon_view.py; catch the generator's refusal in the viewer
    The last two check surfaces in this directory.
    volute.py. Two of its four checks are failing on the shipped design right now --
    the bore stays clear of itself at 7.75mm against the 20mm band, and the two
    openings are opposed at 135 degrees. That is the file's whole point, and it
    makes them the best-evidenced checks in the repository: no mutation needed. the
    cheek fits the P2S bed fires from --r0=200 up. Both its refusals hold, an arc
    under the tooth floor and a facet that does not divide a semicircle. The two
    failing checks are one condition stated twice and they agree: the run turns 1035
    degrees, 315 past whole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
2026-09-09 Take 0.1mm off the slots in both directions: the halftest assembled loose
    Reported from the bench after putting the dspiral halftest together. Taken off
    the SLOT and not added to the tab, which is this file's standing rule -- TOOTH
    feeds the shoulder arithmetic and the panel-length guard, so widening the tab
    moves numbers that are checked, while the notch is free.
    It has to come off the slot across the ply whatever the rule said, because in
    that direction the tab is not drawn at all: its thickness IS the sheet, and
    nothing in an SVG can add to it.
    slot drawn slot cut fit
    along the tooth 5.950 -> 5.850 6.050 -> 5.950 +0.050 -> -0.050mm
    across the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
2026-09-09 The ply is 2.94mm and the kerf 0.13mm: put the measured numbers in
    Calipered at the bench. Both constants were assumptions, and both were wrong in
    the direction that makes a joint loose -- parts come out smaller than drawn and
    holes bigger, and the sheet was 0.06mm thinner than the slot cut for it.
    along the tooth across the ply
    as you cut it +0.110mm +0.090mm
    now +0.050mm +0.000mm
    The first row is the joint that was loose: twice the slack this file asks for in
    one direction and, in the other, 0.09mm of slack where it specifies none. The
    second row is what it always meant to cut. So yesterday's 0.1mm slot tig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
2026-09-09 The sheet and the kerf are variables now, and the block bores get the real ones
    Answering the question directly: no, the ply thickness was NOT a variable. It
    was a module constant in two files, reachable only by editing them, and so was
    the kerf. Both are flags now, --sheet= and --burn=, on both generators.
    bore_split.py gets the same two-number split ribbon_bore.py got. THICKNESS stays
    3.0 and is a DRAWN dimension -- the airway is BLOCK - 2*THICKNESS, so putting
    2.94 there would make this a 10.12mm bore and rename every cut file from bore10-
    to bore10.12-. SHEET is 2.94 and goes where the material belongs: Boxes.py is
    handed it as --thickness, because Boxes cuts the finger slots and a slot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
2026-09-09 Cut the uncut concept bores again for the measured sheet and kerf
    Seven folders regenerated at SHEET 2.94 and BURN 0.13, driven from
    regress.py's own design table rather than retyped, so each got exactly the
    switches the gate uses:
    first trumpet, coil fold2, hilbert open, wide telescope, greek spiral,
    coil 10x10x30 0.75t, coil 10x10x30 2.25t
    TWO FOLDERS DELIBERATELY LEFT. coil-10x10x30-1.5t, whose six parts are cut, and
    built/coil/fold2-long-straight-3t, which is the instrument. Their files still
    describe the wood that exists, and that record is worth more than a file nobody
    is cutting. Both verified untouched: 0 files changed in each.
    The reason is now written where someone would loo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
2026-09-09 Boxes.py's --burn is the RADIUS: my 0.13 told it the kerf was 0.26
    Caught on a second pass, and it was mine, made this morning. Boxes.py sets its
    line width to 2*burn and offsets each side of a line by burn, so burn is half
    the kerf. Measured rather than read: raising --burn by 0.17 widened every drawn
    outline by 0.34.
    bore_split spends its own BURN as 2*BURN everywhere -- in the span arithmetic
    and the bed arithmetic -- which only balances on the same radius convention. So
    its old 0.1 always meant a 0.2mm kerf, and setting it to the measured 0.13 this
    morning told Boxes 0.26mm and compensated every part by twice what the laser
    removes.
    KERF = 0.13 measured, the full width of the cut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
2026-09-09 Two notes still quoted --thickness=3 --burn=0.1 to Boxes
    Third pass over everything changed. Both files record the literal argument list
    handed to Boxes.py, as a record of how their sheets were made, and both were
    stale in the way that matters: someone reproducing a sheet from those lines
    would have got the old geometry, and with --burn=0.1 the old DOUBLED kerf too.
    They now read what _common() actually emits, and say what the two numbers mean,
    since neither is what its name suggests:
    --thickness=2.94 the SHEET, not the nominal 3mm
    --burn=0.065 HALF the kerf, because that is what Boxes means by burn
    and point at bore_split._common() rather than asking to be trusted.
    Verified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
2026-09-09 Why SnakeBoxVar is handed the sheet, checked rather than assumed
    Fourth pass. This one found no defect, and the thing it nearly found is worth
    writing down, because the reasoning that made it look like a defect will occur
    to the next reader too.
    snakeWalls computes h = blocksize - 2*t and that h IS the airway, so handing
    Boxes 2.94 instead of 3.0 looks like it opens a 10mm bore to 10.12. Measured
    instead of reasoned: every part comes out 16.13mm drawn and 16.00mm cut at BOTH
    thicknesses. A wall stands between two plates and its drawn height is h + 2t,
    which is the block pitch whatever t is.
    The airway in the block lattice is not drawn at all. It is what is left between
    two plates -- 16 - 2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
2026-09-09 Warn when the installed generators have drifted from the ones here
    snakebox.py and snakeboxvar.py live in tools/ and are COPIES: they install into
    the Boxes.py checkout, and it is the installed copy that runs, because this file
    shells out to `scripts/boxes SnakeBoxVar`. Edit the one beside you, re-run, and
    nothing changes -- silently, with the sheets coming out of the old generator.
    Found by comparing them on the fifth pass. They were already one comment apart
    -- "a plate drawn one block" here against "a plate drawn 31 mm" there, this one
    newer -- which is harmless, and nothing was watching the drift at all.
    The check compares syntax trees, so a comment or a reflowed line is not an
    alarm a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
2026-09-09 Why the sheets resized when only the joint was meant to
    Sixth pass. No defect this time; one consequence nobody would predict, now
    written where it happened.
    --spacing is "multiples of thickness", and Boxes computes
    spacing = 2*burn + spacing[0]*thickness + spacing[1]
    so the gap between parts moves with both numbers changed yesterday:
    2(0.1) + 0.5(3.0) = 1.70mm became 2(0.065) + 0.5(2.94) = 1.60mm. Parts are
    untouched and the sheets come out 0.1mm tighter per gap. That is most of why
    every sheet's width and height moved when only the joint was meant to. Checked
    against the bed: all 95 block sheets fit, the closest being telescope-wide's
    09of09 at 598.7mm against 600.
    Verified on this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
2026-09-10 The port breaks into its neighbouring slot on every ported cheek
    Eighth pass, running flat-part-check over the ribbon sheets now that it can
    read them -- a gate that had never been applied to these files. It reported
    0.03mm of material where it wants 3mm, on the ported cheeks and only those.
    Measured directly rather than trusted: the port is 0.029mm from slot 0 on all
    TEN ported cheeks in the project. The kerf is 0.13mm and takes half from each
    edge, so the two holes are one hole. Every ported cheek that has been drawn
    here is uncuttable, and has been since the port was added.
    TWO FAULTS, ONE FIXED.
    port_hole() drew the hole OVER size. Its own comment said "the hole is a hole:
    kerf goes u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
2026-09-10 The longer lead does clear the port, and this file already said it cannot
    I offered lengthening the lead as the way to keep a bore-wide port, and it was
    the wrong option to offer: the label-sliding code in this same file has said so
    since before I touched it --
    "the alternative, giving the port a bore of extra lead, moves the whole coil
    and was what made the cheek cross itself"
    -- and I had not read that far before putting the choice up. Built anyway, and
    it reproduces exactly that. PORT_LEAD = 30 clears the port beautifully on the
    coupon, 0.030mm of ply becoming 2.931mm and every check passing, and then:
    spiral the cheek outline starts crossing itself
    volute 39 slot corners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
2026-09-10 A check count moved and a document did not; and my own audit was too kind
    Ninth pass, on the lens pass 8 proved out: not re-reading the scripts, but
    pointing tools at artefacts they have never seen, and reading what the files
    already record.
    THE BLOCK SHEETS THROUGH THE FLAT GATE, never done before. Boxes' own output
    comes back 8 of 9, failing only "holes are inside the outline", which is the
    multi-part sheet mismatch already known from the rosettes -- the five "holes"
    are the other five parts. No defect there, and worth knowing: that check does
    not apply to any sheet carrying more than one part, which is about half of
    what this repository ships.
    A COUNT THAT MOVED. fold2's CLAUDE.md said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
2026-09-10 The port is a 7 x 14mm slot: same open area, and it clears
    Chosen because the clearance a port must keep is measured ACROSS the run and
    nothing else -- the tab slots line both walls the whole length, so a bore-square
    10 x 10 passes within 0.16mm of one wherever it is put. Length ALONG the run
    costs no clearance at all, so it is free, and it buys back what narrowing takes:
    across along clearance opening
    10 10 0.16mm 100mm2 uncuttable, and shipped for weeks
    7 7 1.66mm 49mm2
    7 14 1.66mm 98mm2 this
    6.6 20 1.86mm 132mm2
    98mm2 against the bore's own 100, so the air sees no restriction worth the n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
2026-09-10 The flat gate agrees the port is fixed, and wants one flag to say so
    Tenth pass, checking yesterday's port fix with the tool that found the fault
    rather than with the one that missed it.
    flat-part-check now reads 1.66mm where it read 0.03mm. That is the fix
    confirmed by something that does not share a line of code with it.
    It still FAILS, and should not, because the two gates disagree about the floor:
    ribbon_bore.py MIN_FEATURE 1.5mm
    check.py MIN_FEATURE 1.5mm
    flat-part-check edge distance 3.0mm
    The 3.0 is deliberate and right for what that tool was written for -- a
    bullroarer's cord hole, under string tension, which tears out. A cheek slot is
    not under tension. The flag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
2026-09-10 Nothing outside the bore generators compensates for the kerf
    Eleventh pass, on the one lens left: the kerf and the ply are properties of your
    machine and your sheet, not of the bore. Two generators were corrected for them
    on 2026-09-09. Every other generator in every repository was not.
    bell.py, bell-round.py, mouthpiece.py, mouthpiece-round.py 0 mentions
    knot_soundhole.js, plait_soundhole.js 0
    living-hinge-generator.js 0
    For a laminated ring stack that is defensible -- the rings glue face to face and
    the 3mm lap absorbs an outer profile 0.13mm small -- but it was never written
    down, and it has two consequences nobody was co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
2026-09-10 port_hole()'s docstring described geometry it no longer draws
    Thirteenth pass, on a lens the earlier ones did not use: which claims did my own
    changes falsify, in the files that make them?
    The port became a 7 x 14mm slot yesterday and three descriptions of it did not:
    PORT = False "a bore-square opening through the cheek"
    port_hole() "A square opening through the cheek at the mouth"
    "This cuts a bore-square hole in the last BORE of the run"
    The function's own docstring is the one that matters -- a reader who trusts it
    believes the port is 10 x 10 and cannot be told otherwise by the code, which now
    reads PORT_ACROSS and PORT_ALONG. All three corrected, and they no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
2026-09-10 The ribbon/ splice was still in this folder's documentation, all session
    Fifteenth pass. The first task of this session repaired eleven of these in
    ribbon_bore.py and ribbon_view.py, ran a detector over 476 text files, got
    "0 places where a directory name is glued to the token before it", and called
    the class clean. Nine of them were sitting in the CLAUDE.md beside those
    generators the whole time.
    A ribbon/Boxes.py tooth is -> A Boxes.py tooth is
    ...-ribbon/cheek-x2-cut-files.svg -> ...-cheek-x2-cut-files.svg
    ...-ribbon/panels-cut-files.svg -> ...-panels-cut-files.svg
    `ribbon/lasermade-tools/make-preview.py` -> `lasermade-tools/...`
    python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
2026-09-10 "Two things" read as a list claim, and I pushed over the failure again
    The trumpet README has been failing its own audit since I edited it this
    morning. The counts check reads "Two things about that sentence were wrong" as a
    claim about a list, finds one bold-lead item in the section below, and fails.
    Reworded to "Both halves of that sentence", which reads better anyway.
    It went unnoticed because after that edit I regenerated this page and then ran
    doc-audit on the LANDING page instead -- a different repository. Two documents
    changed, one was checked, and the tally I did read said 0 failed about the other
    one.
    Then in the commit before this I printed "18 passed, 1 failed" for this file and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
2026-09-10 Nothing redrew the 84 sheets Boxes.py draws, and nothing guarded the 18 as cut
    Twentieth pass. all-gates.sh redraws the 40 ribbon sheets and compares bytes.
    It never did that for the 84 the block generator draws, more than twice as many:
    regress.py MEASURES the committed SVGs and never regenerates them, so every
    invariant could hold while the file on disk was one the current code would no
    longer produce. tools/repro.py closes it. 64 of 64 reproduce byte-identical.
    The other 18 are the point. coil-10x10x30-1.5t and built/...-3t hold files drawn
    at the old 3.0mm ply and 0.1mm kerf because they describe wood that exists --
    deliberately not regenerated on 2026-09-09, and fold2-long-straight/CLA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
2026-09-10 sizes.py has crashed on every run for five days, and nothing ran sizes.py
    Twenty-third pass. Every gate built so far checks an ARTEFACT -- a cut file, a
    preview, a document, a published page. A tool that ships no artefact is checked
    by nothing, and sizes.py is one: it calls viewer.build_sets, which stopped
    existing when cfbc018 collapsed the forked toolchain and replaced it with
    build_many. Since 2026-09-05 every run has ended in
    AttributeError: module 'viewer' has no attribute 'build_sets'
    after truncating its own output file, because open(out, 'w') runs before the
    call that fails. Nothing noticed, because no gate ran it.
    build_sets is restored rather than sizes.py rewritten to call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
2026-09-10 The flat-ends check was written inside a branch it can never fire in
    check.py asked whether any outline held a step pin_length deep, INSIDE
    `if b.pin_length <= 0`. The two conditions are mutually exclusive, so the
    counter was never incremented and "no coupling left anywhere" has passed since
    the day it was written. An AST sweep of both repositories says it is the only
    condition of that shape.
    There was no step to look for either. endProfile draws a plain edge(length)
    when pin_length <= 0, so the depth the search was keyed on is exactly what is
    missing, and width cannot stand in for it: pin_width is floored at the finger
    tooth, 2 x thickness, so at the 10mm bore a coupling and an ordinary to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
2026-09-10 It threw away what the writer said, and never read its own pins
    STDERR WAS CAPTURED AND DISCARDED on every successful run. bore_split writes two
    things there that a person redrawing 84 sheets needs: the warning that the
    INSTALLED Boxes generator no longer matches tools/, so the sheets came out of
    code that is not in this repository, and the note that a bore's joint clearance
    is a guess rather than a measurement. Both were invisible in the one place they
    were certain to be seen. Printed once per distinct message now, or the drift
    warning would repeat 24 times.
    AND THE PINS WERE ONLY EVER READ IN ONE DIRECTION. The as-built loop walks the
    files on disk and asks whether each is pinned; nothing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
2026-09-10 Three checks that would have passed over nothing
    checks() opens by saying that a check which measured nothing would print the
    same clean run as one that measured everything, so each reports its count.
    Three of them then compared a failure count to zero with nothing asserting
    there had been anything to count: the two slot checks and the wall-panel one.
    The kerf check was the visible one. With no pair to measure, `worst` stayed at
    infinity and the note passed reading "narrowest infmm drawn, infmm left after a
    0.13mm kerf" -- a sentence that cannot be true of any drawing.
    All fourteen shape-and-port runs still report 12 of 12.
    Claude-Sess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
2026-09-10 A switch with no "=" was dropped on the floor, in five generators
    Each of these builds its options from --name=value and rejects a name it does
    not know. A BARE --name reaches neither test, so it was discarded in silence
    and the sheet drawn with every default.
    `bell.py --help` therefore drew and WROTE eight cut files instead of printing
    anything -- which is how I found it -- and a mistyped `--rim 129` would have
    written a bell nobody asked for just as quietly. bore_split.py carries a whole
    section on this fault under its own flags. These five had it too.
    bell.py also gains --out=, spelled as bell-round.py spells it. Without it the
    file could only ever write into cut-files/, so there was no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
2026-09-10 Nothing had ever redrawn the bell or the mouthpiece
    The block bores have a byte gate and the ribbon sheets have another;
    knotwork-soundholes and living-hinge grew one each when it turned out four of
    their knots recorded their command nowhere. The bell and the mouthpiece --
    eleven generators between them, seven shipped SVGs -- were watched by none of
    it. The only thing that touched the directory was the previews gate, and that
    compares a preview with a cut file rather than a cut file with the code, so the
    sheets on disk could be ones the current code would no longer draw.
    All seven reproduce byte-identical. Two of the commands were not written down
    anywhere and had to be worked out: the mout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
2026-09-10 ramp_bell.py had no input it could work on, and is gone
    It rewrote a `stroke:` property inside a style attribute. The sheets these
    generators write carry a single stroke ATTRIBUTE on the enclosing <g> and
    nothing on the paths at all, so the substitution matched nothing, every ring
    came back #000000, and the tool's own guard refused to write. Correctly, and on
    every sheet in the repository.
    Its ramp belongs to a nested sheet, where a ring sitting inside another's
    aperture must be cut first or it is freed with the waste. The hand-nested
    17-ring sheet that needed one was deleted on 2026-08-25 and regenerated flat,
    and nothing here has been nested since. So the tool had been unusable for a
    fort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
2026-09-10 The gate refused a ported piece for two reasons that were its own
    Ports are kept: a port lets a change of plane happen inside a piece and cuts
    the part count sharply -- the test bore goes from three pieces to two -- and
    with two sections assembled the joint closes, the bore carries on through it
    and the whole passage is sealed. What it costs is a joint with no tab, and the
    fingers of the cell whose plate was removed facing nothing. Those are the
    objections, and check.py is written to raise them.
    It raised five. Two were the checker not knowing what a port is.
    - "the two plates are one part mirrored". A ported piece has one plate
    stopping a cell short on purpose, so the two are delibe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
2026-09-10 Three places that answered without saying they had not looked
    svgpath.py STEPPED SILENTLY PAST WHAT IT COULD NOT READ. The fall-through was
    `i += 1`, so a relative lineto, an arc, or a number the pattern did not match
    was skipped and the function returned a SHORTER point list than the path
    actually visits. Every measurement downstream is taken from that list -- the
    sliver check, the bed check, the overlap check, the label placement -- and a
    quietly truncated outline is the one input none of them survives and none of
    them reports. It also matched `-?\d+\.?\d*`, so `.5` was not a number to it,
    and it tokenised only the commands it handled, so any other command's
    coordinates arrived as bare num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
2026-09-10 The picture was built from one generator and the parts from another
    piece_render.py read the piece's cells, outline and tips from plain SnakeBox
    while taking the parts themselves from cut(), which shells out to SnakeBoxVar.
    So the topology and the parts came from two different generators, under a
    docstring saying the picture cannot drift from what is actually cut. check.py
    has imported the Var since it was written; this file was never moved over.
    They agree today -- same cells, same six runs, same tips, and the rendered SVG
    is byte-identical either way -- and nothing was watching whether they went on
    agreeing. It reads the generator that cuts now.
    That leaves tools/snakebox.py with no call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
2026-09-10 Two search tools answered a missing argument with a stack trace
    Both take a walk or a period as argv[2] and neither said so. Run bare,
    mknotation.js died on `undefined.split` inside steps() and spiral_metrics.js on
    the same call inside metrics() -- a TypeError and a Node stack where a usage
    line belongs. Every other tool in this directory reads the corpus and needs no
    argument, so these two are the only ones where the question arises, and they
    were the only two that could not answer it.
    They print usage and exit 2 now. Given an argument they behave exactly as
    before, and all five artefacts build.sh writes still reproduce byte-identical.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
2026-09-10 Four more tools answered a missing file with a stack trace
    bell-section.py, bell-view.py and verify_bell.py all die on sys.argv[1] with an
    IndexError when run bare, and number_rings.py does the same one line further in.
    A traceback where a usage line belongs, in four tools that take a sheet and say
    so only in their docstrings.
    number_rings.py also had the bare-switch fault the five sheet generators had:
    its opts are built from --name=value and the loop rejects a name it does not
    know, so a bare --mark reached neither test and the default was used in silence.
    `number_rings.py --help` engraved nothing only because it crashed first.
    All four shipped drawings still reproduce byte-identical --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
2026-09-11 The viewer's default put the page one directory above where it belongs
    Every one of the seven ordinary shapes ships its page in <shape>/<stem>/, beside
    the sheets it describes. The default output was the root of swept-curve, which is
    where the traced and torus pages live and where no ordinary shape's page has ever
    been -- so a bare run dropped an unshipped duplicate at the root, one directory
    up from the real page and beside the one root page that is real. Found by running
    the file with no arguments, which is the only way anyone would meet it.
    It writes into the design directory now, and refuses when there is none rather
    than inventing one: ribbon_bore.py makes that directory when it writes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
2026-09-11 Three tools whose own usage examples do not run
    Found by extracting every example from every docstring in the repository and
    running it. Sixty-odd lines, three of them wrong, and all three wrong in a way
    nobody would hit unless they did what the file told them to.
    bore_split.py: ALL SIX examples read `"D R1 F"`, and R and F are not letters
    this notation has. The table four lines above them says the letters are N S E W
    U D; the tool answers `unexpected characters: 'RF'`. They are the first thing in
    the file a reader meets. Rewritten in the letters it actually parses, and every
    one of the six now runs.
    The same line also called the bare form "report only". It is not: with neither
    switch the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
2026-09-13 Five cheek and port options that existed only as Inkscape edits
    Each of these was done by hand on a shipped sheet, and each is now a flag, so
    the sheet can be redrawn when the kerf or the sheet thickness moves. Nothing
    about the default changes: all 30 shipped sheets still redraw identically and
    repro.py is unmoved at 64.
    --narrow puts the cheek's edge ON the mortice's outboard edge, so there is no
    web and the band is only as wide as the duct: 20mm becomes 15.81. It is NOT
    --web=0, which stops at the wall's true face and leaves an 0.095mm rib no laser
    can cut. It reads the same slot_half() the mortice does, so it tracks --kerf
    and --sheet instead of restating a number they set. It costs the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
2026-09-13 The ply is 3mm now, so every curve is redrawn narrow and the old sheets move aside
    SHEET goes 2.94 -> 3.0 on the author's instruction, for stock that measures it.
    SHEET is the MATERIAL and belongs only in the depth of the hole it passes
    through, so this deepens every mortice by 0.06 and changes nothing else. THICK
    stays 3.0 and still carries every drawn dimension.
    It also makes every sheet cut before today stale -- a 3.0mm tab will not enter a
    slot cut for 2.94 -- so all 40 of them move to an old/ beside the sheets that
    replace them, and 42 new ones are drawn at 3mm ply and a 0.15mm kerf: every
    design under swept-curve, narrow, with a square port wherever the shape takes
    one. Seven do. The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
2026-09-13 The adapter that lets a ported bore take the bell it already has
    A ported bore does not open at its mouth. It opens through the 7 x 14mm slot in
    the cheek, and a bell's throat is the bore's own 10mm square, so something has to
    turn one into the other. bell-adapter.py is that part, and it is a third part
    rather than a third bell: the bell itself needs no change at all, because the
    adapter's last ring is a COLLAR, 10mm square in a 16mm square face, which is
    exactly the end face the bore presents. bell-round.py's ring 0 glues onto it as
    it was always going to glue onto the bore.
    Why the port is not square is argued next door beside PORT_ACROSS, and it is the
    whole reason this exists. The tab s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
2026-09-13 The same 3mm ply and 0.15 kerf everywhere else, and the page route that never worked
    bore_split.py gets SHEET 2.94 -> 3.0 and KERF 0.13 -> 0.15, the two numbers
    ribbon_bore.py took on 2026-09-13. It was the only other generator with either:
    the bell and the mouthpiece are already 3mm ply and carry no kerf compensation
    at all, deliberately, because their rings are glued laminations.
    THICKNESS stays 3.0 and still dimensions the lattice. SHEET reaches only the slot
    Boxes cuts for a sheet to pass through, so this moves no airway and shortens the
    three wall runs that carry a thickness by 0.06mm each. KERF here is the FULL
    width and BURN is the radius Boxes wants; the paragraph above the constant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
2026-09-13 The 3t coil is redrawn at the current ply and kerf, and stops claiming to be as-built
    Twelve sheets redrawn at 3.0mm stock and a 0.15mm kerf, on the author's explicit
    instruction and with the variation that implies accepted in advance. The twelve
    filenames are unchanged.
    THE RECORD IS NOT GONE. The sheets as actually cut are in that folder's
    cut-files/old/, byte for byte, and in git before this commit. That is the whole
    reason this was done by archiving rather than overwriting: this folder was one of
    the two the as-built mechanism exists to protect, and the protection is worth
    nothing if the first explicit instruction to redraw destroys what it guarded.
    fold2-long-straight-3t therefore LEA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
2026-09-13 Forty previews rendered sheets that had been superseded, and the adapter was claimed by nothing
    Three things this tree asserted about itself were no longer true after the
    narrow regeneration, and all-gates.sh found each of them.
    previews/ held forty renderings of the full-width sheets and none of the
    forty-two narrow ones that replaced them -- so every picture in the folder
    showed a sheet nobody is cutting, and the gate read "40 of 43 stale". The
    forty move to previews/old/, mirroring each design's cut-files/old/, for the
    reason the sheets themselves were kept: a preview is the only readable picture
    of what a superseded sheet cut. Out of previews/ rather than deleted, because
    the gate walks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
2026-09-13 Every old/ leaves the repository and stays on the disk
    The twenty-one cut-files/old/ folders, and the previews/old/ that mirrors them,
    hold sheets a later regeneration replaced: a different ply, a different kerf, a
    full-width cheek where the design is now narrow. They were set aside rather
    than deleted so that what a particular run drew stays recoverable. They are a
    local archive, not part of what this repository ships, and they now say so --
    "old/" in .gitignore, and 169 files out of the index.
    The files are untouched on disk. git rm --cached removed them from tracking
    only, and history up to this commit still carries every one of them.
    Three passages had to change, because each asserted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
2026-09-13 Five claims the docs made that measurement no longer supported
    A thirteen-lens review of the ten markdown documents. The mechanical half was
    clean -- 10 of 10 documents, 363 SVGs, no stroke conflicts -- so everything
    below came from the judgment lenses.
    **The bed paragraph in greek-key was stale in four numbers and wrong in one
    claim.** Every figure recomputed from the sheets' declared sizes: 592.0 x
    284.4mm and 1684cm2, not 592.4 x 284.6 and 1686; telescope-wide is 598.9 not
    599.2, hilbert/open 598.6 not 598.8, margins 1.1 and 1.4 rather than 0.8 and
    1.2. "Half again the next one" was 1.5x when written and is 1.134x now, because
    the narrow serpentine cheek is 1485cm2.
    The substantive part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
2026-09-14 ribbon_view: drop the ply cheek plates, draw the airway alone
    The two slabs at full band width, 3mm proud of the passage top and
    bottom, meant every look at the inside was a look through plywood --
    which is the one thing this page exists not to do. Faces 6 and 7,
    'ply, top' and 'ply, bottom', are gone; six faces now, not eight.
    What they were there for -- 20mm of band around a 10mm passage -- the
    numbers panel says in words and the cut files show to scale.
    All eleven pages redrawn. The airway geometry is byte-identical to
    what shipped: only the ply vertices and quads are dropped.
    --trace was missing from the `known` flag set, so the guard that
    refuses an unknown flag refused the one flag w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
2026-09-14 A page for each of the three bores, and one for the two ends
    Four rows of "The instruments" on the index page named four separate things and
    landed on the same repository root, because there was nothing else to land on:
    every README under trumpet/ was removed on 2026-09-05 in favour of one writeup
    for the whole project, and the per-design notes that replaced them are CLAUDE.md
    files addressed to a tool, not to a reader.
    coiled/, switchback/, greek-spiral/ and ends/ are now four pages. Each carries
    the walk it is cut from, its blocks and centreline, its sections with their
    plates and sheet sizes, its cut files, the command that rebuilds it, and a link
    to the viewer as a page of its own rathe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
2026-09-14 The one instrument that exists had no page of its own
    Yesterday's four pages covered three bores that have never been cut and the two
    shared ends. The 1096mm three-turn coil -- the thing that is glued up, varnished,
    blown, and photographed at the top of the root writeup -- was not among them. It
    was reachable only as a paragraph in the whole-project writeup and a folder path.
    three-turn/ is its page: the walk, the twelve sections with their sheets, the
    1 : 2 : 3 : 4 family it is the longest of, the build order, what the single row of
    PLAY_BY_BORE is worth, and why F4 on a 1.339m tube is not a number any pipe
    formula predicts.
    Checked rather than copied:
    - The walk is W U E D three times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
2026-09-14 The built instrument's page now shows its own two ends
    The bell and the mouthpiece photographs join the twelve build steps on
    three-turn/, side by side, where the steps that tell you to cut them are. The
    page had the whole instrument at the top and a link to ends/ for the parts;
    those two objects are what steps 2, 3 and 5 produce, so they belong beside them.
    The caption says the thing the numbers table only implies: the mouthpiece is the
    one part of this instrument that is not what the drawing says -- 24 rings and
    72mm against the sheet's 30 and 90 -- and that is where 1339mm becomes 1321 in
    wood.
    Written first as two markdown images on one line, which renders as a gallery.
    It does not: md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
2026-09-14 The first swept curve off the laser is a spiral's pair of cheeks
    Author-supplied photograph of the 1000mm spiral's cheek sheet as cut, filed
    beside the cut-files/ folder that drew it, and named for the sheet it is:
    ported-square, narrow, cheek-x2. Two copies are in the picture because that
    sheet says CUT THIS SHEET TWICE -- the two cheeks are the same part and both go
    on the same way up -- and the second is visible under the first at the straight
    tail. Same original-plus-_web pair as the bell and the mouthpiece, 3000px and
    1400px, 1.9MB for the two.
    Which sheet it is was not taken on trust. The photograph was matched against
    every cut file in that folder rendered in a browser: the square po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
2026-09-14 The greek spiral was the one bore page with no picture of its walk
    The coiled trumpet and the switchback each show their walk laid out in Minecraft,
    which is where every walk in this project is designed and checked -- a section
    running into one laid down earlier is plainly visible while you are standing in
    it. The greek spiral had the viewer and nothing still.
    The colours on it are worth a paragraph, because they do not mean what they mean
    anywhere else here. A coloured bore block normally says which section it belongs
    to; this bore has exactly one section, so there is nothing for that to
    distinguish, and the blocks are coloured by direction of travel instead. Only
    four of the six direction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
2026-09-14 A photograph on the front page had never rendered
    The two cheek plates, in "Three ways to make a tube". Its alt text runs to four
    lines, and md2html.py converts an image only when it is alone on its line, so
    the whole thing published as literal ![...](...) text. The file was on the
    server the whole time and answered 200; nothing pointed at it.
    Joined onto one line. It now emits as a figure and the image loads -- checked in
    the DOM, 1051x1400 natural, 830x1105 rendered, alt intact.
    Found by the check added to lasermade-tools in the same hour, on its first sweep
    of all nine repositories. This one predates the bug that prompted the check.
    doc-audit 19/19.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
2026-09-14 An exemption that suppressed nothing, left behind by the pass before it
    `ignore-audit.py` reports the `mouthpiece-parts-cut-files.svg` line in
    `.doc-audit-ignore` as DEAD. It was exempting a name the notes carried in the
    sentence "that file was renamed the same day to carry its bore and layout" --
    one of the rename narratives the previous commit took out -- so with the prose
    gone, doc-audit no longer flags the name and the exemption suppresses nothing.
    That is the state that file's own header calls worse than no exemption: a
    standing claim nobody re-reads, in the list whose whole job is to be trusted. So
    the entry and its comment line both go, and the audit reads 62 exemptions, 0
    suppressin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
2026-09-14 Boxes.py draws every finger joint here and was nowhere credited
    Seven documents name Boxes.py or SnakeBox and not one of them said whose it is,
    where it comes from or what it is licensed under. The only place in the
    repository carrying a source for it was a comment in .doc-audit-ignore, which is
    config and not a document, and the URL there -- festi.info/boxes.py -- is not one
    the project itself gives.
    The facts come off the installed checkout rather than from memory: pyproject.toml
    in ~/Software/boxes gives boxes 1.2, maintainer Florian Festi
    <florian@festi.info>, Repository https://github.com/florianfesti/boxes, license
    GPL-3.0-or-later. That URL is what every credit below names, and doc-a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
2026-09-14 A Minecraft screenshot no page ever showed
    parts/bore/concept/minecraft/coiled_in_minecraft.png, 902x900, was tracked and
    displayed nowhere: no README, no index.html, no generator, no manifest, no
    script named it. Checked across every file type in the repository rather than
    markdown alone.
    It is the coiled walk -- a flat rectangular coil of translucent blocks dropping
    through two vertical legs, coloured by section -- which is the same design
    coiled/ already shows through
    flat-drop/bore/trumpet-coiled_minecraft.png, from a different angle. That one is
    displayed and stays.
    The folder went with it, being empty afterwards. Nothing is lost that a git
    history does not hold, and the three Minecra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
2026-09-14 Three files cannot be CC0, because they are a Boxes.py generator and its readers
    CC0 on the whole repository was offering permissions the GPL on Boxes.py does not
    let this author grant. The coupling is narrow, and it is three files:
    tools/snakeboxvar.py `from boxes import *`, `class SnakeBoxVar(Boxes)`,
    `Boxes.__init__`, `edges.FingerJointSettings` -- a work
    derived from Boxes.py, structurally identical to the
    generators that ship with it, every one of which
    carries a GPLv3-or-later header. This one carried none.
    tools/check.py:20 `from boxes.generators.snakeboxvar import SnakeBoxV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
2026-09-14 The spiral is glued up, and a glue-up this size is not airtight
    Both sheets are cut and the bore is assembled, with a mouthpiece on the
    straight tail and a bell on the port. The photograph shows what the cut
    files cannot: air gaps all along both rims, at every mitre and every tab.
    They are closed with shellac, which is why the three-turn coil at the top
    of the page is the colour it is and this spiral is still bare ply.
    Claude-Session: https://claude.ai/code/session_01XTXnWTXE6TaLYt3VGZwCm7
2026-09-14 The glued-up photograph is named for the sheets it is a photograph of
    It was filed as -1000mm-glued-up, dropping the -ported-square-narrow-cheek-x2
    that its as-cut sibling carries, so the pair no longer sorted or read as one
    design photographed twice.
    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
2026-09-14 The glued-up photograph is cropped to the instrument, and the spiral is in the index
    Two thirds of the frame was floor, so the coil rendered small in a column
    sized for it. Recropped from the original to 6830 x 6128 and rebuilt at the
    repository's two sizes.
    The spiral had no row in "A page for each" despite being the second design
    here that has been cut. It gets one, pointing at its viewer, and the
    paragraph above the table says why that row is unlike the four over it.
    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
2026-09-14 The spiral bore is a page, not four paragraphs inside somebody else's section
    It is the second design here that exists in wood, and it was being described
    between the swept-curve overview and the double spiral, where it could carry
    two photographs and no numbers. ribbon-spiral/ is its own page in the shape
    the other five have: what the cheek is, what the glue-up is not, a numbers
    table off the generator's own report, and the three shipped variants set
    against each other.
    The panel count in the moved prose said 38. The photographed sheet is the
    square-ported one, and --port-square folds each wall's 20mm lead panel into
    the facet it already lies on to clear room for the port, so it is 36. Bot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
2026-09-14 The mouthpiece is not sanded or filled, and two paragraphs said it was
    Reported by the author: the staircase is left alone and the mouthpiece is used as
    it comes off the sheet. The ends page said the opposite twice -- "the staircase
    in that photograph is the thing to sand", and an instruction in bold to "sand and
    fill the staircase and round the rim over before you put a lip to it". Both now
    say what is done: it meets a lip unsanded and unfilled, and it is played that
    way.
    What stays is the reason those sentences existed. Thirty 3mm rings make a 90mm
    cone out of thirty steps and the lip is the one part of this instrument that
    feels every one of them -- that is still true, and it is worth a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
2026-09-14 A duct has two ends, and only one of them could take a port
    port_hole() drew at cline[0] and nowhere else, so "a square port on the far
    end" was not a flag that was missing -- it was a shape the generator could not
    express. --port-both adds it, and the work was not the hole.
    A square port is bought by folding the mouth lead into the facet it is already
    collinear with, because the lead's one tooth sits exactly where the port wants
    to be. The far end needs the same purchase and merge_lead() only ever folded
    ps[0]. Without the tail fold the second port lands on the tail lead's only
    tooth and teeth_kept() refuses, naming the panel -- which is the right answer
    to the wrong question. So the flag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
2026-09-14 The trim gets to 956mm and the lead lands it on 1000
    The double spiral shortens by whole facets and nothing else, so it cannot reach
    a round number: nine facets an arm give 956.0mm and ten give 1058.2, about
    100mm a step. The last 44mm comes off the leads instead, 20mm to 42 at each
    end. A lead is a straight run tangent to the arm -- centreline() makes it by
    extending the end segment's own direction -- so it buys length without moving a
    facet of the coil, and the cost is 42mm of straight tail at each rim rather
    than a redrawn spiral. 1000.0mm exactly.
    THE 956mm SHEETS ARE REPLACED, NOT KEPT BESIDE IT. They were never cut, they
    lived for one commit, and two double spirals differing by 44mm w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
2026-09-15 The mouthpiece enters one face and the bell leaves the other
    A port through both cheeks is a socket right through, because the cheek is one
    part cut twice -- and the side you are not using is an open hole to plug. Two
    ports make four of those and two are waste. --port-per-cheek splits them
    instead: cheek-a carries the mouth port, cheek-b the far one, each sheet cut
    once. No geometry moves. Same coil, same sixty panels, the same two holes in
    the same two places; only which sheet each hole is drawn on.
    THE CONSEQUENCE IS THE INSTRUMENT, and it is worth saying plainly. The two
    openings are no longer in the plane of the coil: you blow into one face and the
    sound leaves the other, at points 222.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
2026-09-15 The coupon and the coiled trumpet are deleted
    TWO COUPONS, and both go. The swept curve's was --shape=coupon, the 180 degree
    R30 test piece: its folder, four sheets, four previews, its page, the shape in
    ribbon_bore.py and ribbon_view.py, and its two rows in the reproduce gate.
    tools/coupon-16mm/ was the other, four sheets that would have settled whether
    the play requirement is absolute or a fraction of the tab.
    THE COUPON WAS NOT AN IF, IT WAS THE FALL-THROUGH. centreline() ended with the
    180 degree arc and no test on the shape, so anything reaching the bottom of the
    chain was drawn as a coupon -- a misspelt --shape produced a test piece rather
    than a complaint. That end is now a refusal n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
2026-09-15 Ten of the twelve design pages were a viewer revision behind
    Regenerated, all twelve. When ribbon_view.py learned about ports I rebuilt the
    two pages I had touched and left the rest, and nothing in the repository could
    say so: the only page under a gate is the embed in the other repository.
    TWO WERE NOT MERELY BEHIND. The 1506mm double spiral's page opened its vertex
    list at [37.979, 115.117] where the generator draws [40.856, -111.865], and the
    halftest's was wrong the same way -- geometry that matches no flags its folder
    name claims. A page that draws a bore nobody drew is precisely what this file
    exists to prevent; it was doing the opposite, quietly, on the design this repo
    is named for.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
2026-09-15 The "What is in here" tree was written before the spiral had a page
    Four staleness spots, all from the same event: ribbon-spiral/ became a page on
    2026-09-14, and the map of the repository never heard about it.
    The tree listed four page directories and said "four"; there are five. Its
    annotation called them "the instrument that exists, the two candidates worth
    reading about on their own, and the two ends" -- which is the right sentence for
    the day it was written and wrong for a repository where a second design is in
    ply.
    THE concept/ LINE WAS THE ONE THAT MATTERED. It said "every candidate, none of
    them cut", and the paragraph below it said "Nothing in concept/ has been cut" --
    while conce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
2026-09-15 An instrument is a bore and its two ends, so built/ is not inside parts/bore
    `parts/bore/built/` filed the three-turn coil as a kind of bore. It is not: it
    is the only thing in this repository somebody can pick up and blow, and what
    makes it that is the bell and the mouthpiece on it, neither of which is a bore
    and neither of which lived in that folder. The name promised an instrument and
    the path delivered a tube.
    built/coil-fold2-long-straight-3t/ the three-turn trumpet
    built/ribbon-spiral-bore10-45deg-R35to113/ the spiral
    THE SPIRAL CAME WITH IT, which is the point of the move rather than a side
    effect. It has been cut, glued up and fitted with both ends since 2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
2026-09-15 Seven swept-curve designs were drawn, eight were listed, and eleven exist
    The sentence said seven, the list after the colon named eight, and eleven
    folders under swept-curve hold cut files. Three numbers, no two agreeing, on the
    paragraph that tells a reader what this construction has produced.
    Counted the only way that cannot drift -- folders holding cut files, taken from
    git ls-files so the count is what the repository ships rather than what is on
    this disk -- and every centreline read back out of the design's own viewer page:
    serpentine R72 1000.0mm spiral R35to113 1000.0mm
    opposed R64 1000.0mm spiral R74to144 1458.2mm
    volute R94-step60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
2026-09-15 A halftest is a sheet, not a design, so nine are drawn and not eleven
    Yesterday's count took every swept-curve folder holding cut files and got
    eleven. Two of those are the 196 and 240mm double-spiral halftests, which exist
    to try the joint and were never candidate bores -- counting them inflated the
    number the paragraph exists to state.
    Nine, and the list after the colon names nine: a serpentine and an opposed pair
    at 1000mm, three spirals at 1000, 1458 and 1767mm, a volute at 1180mm, a wave at
    836mm, and two double spirals at 1506 and 1000mm.
    The halftests are not deleted from the page, because a reader who runs the same
    count will find eleven folders and needs to know which two are not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
2026-09-15 Two gates already expected these five files, and a fresh clone had none of them
    The 1000mm double spiral's single-port arrangement -- two cut sheets, its viewer
    page and the two previews -- was written to the working disk and never added.
    Nothing said so, because everything that reads them reads the disk.
    BOTH GATES NAME THESE FILES BY PATH. all-gates.sh has
    rr $DS-1000mm/cut-files ... -ported-square-narrow ...
    vp $DS-1000mm/ribbon-...-1000mm-ported-square.html ...
    so the sheets are 2 of the 48 and the page is 1 of the 13. On this disk they
    passed; on a fresh clone they were missing files, and the gate that exists to
    catch exactly that could not see its own blind spot.
    Verified c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
2026-09-15 A port seats a bell in 3mm of ply, and nothing has seated a mouthpiece in one
    The port cuts through ONE cheek, so whatever goes into it meets 3mm of birch
    rather than the whole 16mm sandwich, and that is the first thing anyone asks
    about the joint. The section answers it with the two photographs: the R35to113
    spiral's bell stands in its square port, carried by a 10 x 10mm hole in one
    cheek, and it holds.
    WHAT IT DOES NOT SETTLE IS THE MOUTHPIECE. On both built instruments the
    mouthpiece is out on the lead, seated in the tube end where four walls grip the
    full depth. A bell sits where it is put; a mouthpiece takes lip pressure and
    whatever the player leans into it, and the 3mm has never seen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
2026-09-15 The three-turn redraw changed the kerf and not the ply, and the note said both
    built/CLAUDE.md told a reader that cut-files/ is "drawn at 2.94mm and 0.13mm
    while the wood was cut at 3.0mm and 0.1mm". Those two numbers are
    ribbon_bore.py's calipered pair from 2026-09-09, and they were never
    bore_split.py's: bore_split.py's own comments explain at length why THICKNESS
    stays 3.0 and why 0.13 was the wrong reading of BURN. Its defaults today are
    SHEET = 3.0 and KERF = 0.15, and the twelve sheets carry that in their own
    <desc>: "3mm stock, cut for a 3mm sheet at 0.15mm kerf".
    Measured rather than reasoned. Every sheet in cut-files/ against its twin in
    cut-files/old/ differs by 0.05mm in height a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
2026-09-15 A plain end is a different cut, so two sheets sharing a shape name are two sheets
    Both writeups counted a section by its shape string and treated ~a and ~b as
    decoration. They are not: a plain end carries no fingers, so the outline is a
    different one.
    Read off the black layer of the shipped sheets, grouping by identical cut
    geometry:
    three-turn twelve sheets, TEN distinct. Only BRD (3 and 6) and BDR (7 and
    10) repeat. BDL appears as BDL~a in section 1 and BDL in section
    4 -- 325 x 70mm against 331 x 73mm, so not even the same size --
    and BLD as BLD in 9 and BLD~b in 12.
    switchback six sheets, SIX distinct. Sections 3 and 6 share a 253 x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
2026-09-15 Two bores are in wood, and one of them plays; also the spiral has 19 facets
    Two corrections, both of them a document contradicting another document in this
    repository rather than anything on disk.
    THE ONE THAT EXISTS -> THE ONE THAT PLAYS. built/CLAUDE.md opens "One folder per
    instrument that has been cut, glued and assembled", and there are two folders in
    it. README.md says "the two instruments that exist in wood". Meanwhile
    three-turn/README.md opened "**The one that exists.** Every other bore here is a
    drawing", which the spiral -- cut, glued up, a bell in its port, photographed on
    its own page -- has not been true of since it was cut. The distinction the prose
    actually wants is narrower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
2026-09-16 The word was still on the page, and one sentence about it was false
    b5f3a1f left "elbow" in the docs as history -- a sentence on the trumpet page
    naming the two sorting folders, the constant names in two CLAUDE.md files, and
    `"kind":"elbow"` in a generated example page. Removing it from the library was
    the ask; keeping it as a footnote was not. It is gone from every document and
    every published page.
    RENAMED IN CODE, so the docs can describe the guard without the word:
    FEWEST_ELBOWS -> FOLD_TURNS, REFUSE_ELBOWS -> REFUSE_STRANDED, and the piece
    kind 'elbow' -> 'stranded', which is what the cut list prints and what the
    viewer colours. --refuse-elbows is deleted rather than kept as a no-op, b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
2026-09-16 Three counts the restructure left behind, one of them mine
    Thirteen-lens pass over this repository. The mechanical half is clean -- all 15
    documents pass doc-audit with --links and --run-blocks, 324 SVGs have no stroke
    conflict, every tracked file is mentioned.
    `repro.py` redraws 59 sheets, not 76. tools/CLAUDE.md has said 76 since before
    the nine designs went; the run says "59 reproduce, 6 frozen as cut".
    `All 24 uniform designs` is 20. Four of the 24 corpus entries pass
    --straight=30, and a uniform design is one where every box is the same size, so
    it is 24 - 4. This one was ALREADY stale before today -- it said 24 when the
    corpus was 27, where the right answer was 23 -- so it has been w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
2026-09-16 Every torus jammed at its seam, and a ring has no end to put a port on
    turn_at() answered 0 at the first and last vertex -- "a free end turns
    through 0", which is right for a run and wrong for a ring, whose first
    and last vertex are one vertex that turns like any other. So the two
    panels either side of the seam kept the THICK/2*tan(phi/2) the trim
    exists to take off, and "no two wall panels share plan area" failed with
    exactly 2 jamming pairs, one per wall, on EVERY torus at every facet
    count and every radius. 0.37mm a panel at 13 facets, 0.62mm at 8 -- the
    1.24mm the trim's own comment quotes from the bench. It now wraps, as
    offset() already did at the seam mitre and for the same reason. No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
2026-09-16 The floor for a ported ring is the PORT, and it is R36 not R120
    The ceiling was written down and the floor was not, so a reader reaching
    for --port-at on a default ring got a refusal and no hint which dial
    moved it. It is arithmetic: a port needs PORT_FROM_TIP + PORT_ALONG/2 =
    17mm of the facet it is measured along, a ring's facet is 2*R*sin(pi/n),
    so R >= 17/(2 sin(pi/n)). R32.84 at n=12 and R35.52 at n=13 -- measured
    both ways, R32.8 and R35.5 refuse with 16.98 and 16.99mm of facet, R32.9
    and R36 pass all twelve.
    Coarsening --facet is not the alternative. At --facet=60 the ring clears
    the port and fails "the web outboard of a slot is cuttable" at 0.951mm
    against 1.5mm, at EVERY radius --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
2026-09-16 "At every radius" overstated it: above R150 the check never runs
    The --facet=60 note said the web check fails at 0.951mm at EVERY radius,
    and measured two of them. It is 0.951 at R30, R60 and R120 -- constant,
    as claimed -- but from R150 the bed refuses the cheek outright and the
    twelve checks are never reached at all. The conclusion is unchanged and
    in fact stronger: --facet=60 has no passing radius. Only the MODE of the
    refusal changes, and the sentence now says which is which.
    Worth its own paragraph because of how the upper end reads if you count
    one signal: --facet=60 --radius=300 prints zero FAIL lines, and zero
    FAIL lines there means zero checks ran, not that it passed. Every row in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
2026-09-16 The two bed limits, named where they are set
    The sheet-vs-part note asserted the distinction and cited nothing, which
    is the same standing as the claim it exists to correct. Both limits are
    now named with where they are set: 600 x 308 in the "every sheet fits
    the P2S bed" check, "w > BED_W or h > BED_H"; 580 x 288 in pack(),
    "use_w, use_h = BED_W - 2*margin, BED_H - 2*margin", which is the one a
    refusal quotes.
    And the reason they differ, which is the part worth having: pack() packs
    into the bed minus a margin all round, because filling to the edge gave
    "a sheet 600 x 307 on a 600 x 308 bed, which passes a fits-the-bed check
    and cannot be positioned on a real machine". Its docstring has sai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
2026-09-16 The two paths are the point, so K is a dial and not a warning
    Both notes described the ring's two parallel branches as a defect --
    "that is a ring resonator, not a trumpet bore", "the two wants are
    incompatible; pick one". The uneven paths are wanted here, so that text
    steered a reader away from the thing the flag exists to do.
    Reframed around the dial. Ports on facets 0 and K split an n-ring into K
    facets one way and n-K the other, so K runs 1 to n//2: most lopsided at
    1, nearest balanced at n//2. The 13 ring's whole range is now tabled at
    both ends of its radius band, with the path difference and the first
    destructive null it implies -- c/2d, plane wave, no end correction,
    marked indicati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
2026-09-16 A 13-facet ring, 800.0mm, ports on facets 0 and 6, one per cheek
    The first closed ring this tree keeps. R128.571738 gives a centreline of
    exactly 800.0mm, which is inside the n=13 band -- the bed allows 840mm
    at R135 -- so nothing had to be given up to fit it. --narrow, like every
    other sheet here. Fourteen checks, none failing. Three sheets: two
    cheeks cut once each, 296 x 289mm, and the panels at 572 x 289.
    The two air paths are 6 facets and 7, 369.2 and 430.8mm, and they are
    uneven on purpose: this is a ring resonator with two parallel branches
    and the port separation is its tuning dial. K=6 is the least uneven
    split a 13 ring has.
    SHIPPING IT FOUND TWO THINGS, both older than this ring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
2026-09-16 Square ports on a ring, and a closed serpentine to put them in too
    TWO DESIGNS, both 800.0mm of centreline, both closed, both --narrow.
    The 13-facet ring gains a square-port variant beside its 7 x 14 one.
    --port-square was refused on every ring, and the refusal came from
    merge_lead() being right about a question it should not have been asked:
    --port-square implied --merge-lead unconditionally, and a ring has no
    collinear neighbour to fold a lead into. But the merge exists for ONE
    reason -- a 20mm lead carries a single tooth dead centre, where the port
    wants to be -- and --port-at puts no port on a lead. On this ring the
    ported facets are 57.59mm and carry four teeth each, so teeth_kept()
    dr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
2026-09-16 A closed serpentine racetrack, 1600.0mm, unported
    --shape=racetrack. Half the loop is a 180 degree cap then LOBES
    alternating half-circles joined by straights; the alternation nets zero
    turning, so the half turns 180, two halves turn 360, and a half turn of
    the plane maps the figure onto itself. Same closure argument as the
    scallop, one order lower, and it shuts whatever the radii: measured
    5e-13mm.
    IT EXISTS BECAUSE THE SCALLOP CANNOT GET HERE. A scallop repeats one
    lobe about a centre, so its envelope is circular and the bed's 288mm of
    HEIGHT bounds it in both axes while 580mm of width goes unused -- the
    shipped 800mm scallop is within one part-millimetre of the limit, and
    900mm is alread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
2026-09-16 The spiral is finished
    The R35to113 spiral has had its shellac. The photograph goes in built/ beside
    the as-cut and glued-up ones, at the same two sizes (3000 and 1400px on the
    long side), and ribbon-spiral/ gets a Finished section under it. The lines
    that still called it bare ply -- the page, the root README, built/CLAUDE.md --
    now say shellacked. None of them claims it has been blown.
    Gates: doc-audit 19/0 at the root, 18/0 on ribbon-spiral.
2026-09-16 Link the trumpet writeup by its URL, not by ../
    GitHub renders `../` from a page's README as /Gernreich/trumpet/blob/main,
    a blob with no path, so "The trumpet writeup" link was broken everywhere
    except the published pages. The root README already links itself by its
    Pages URL; the four pages now do the same, five links in all.
    Gates: doc-audit 18/0 on greek-spiral, three-turn, ends and switchback.
2026-09-16 A closed 52-block loop with two mouths, and the three things it found
    The walk is N3 W3 N3 E3 N3 W3 N3 E3 N3 W5 S15 E4 -- 52 blocks, 832mm,
    2 sections, no stranded turns. S15 and not the S14 it was given: with
    S14 it ends one block north AND one west of where it began, diagonal
    rather than beside it, so it shut onto block 2 and stranded block 1.
    Gated, 118 checks, 0 failed. Not built.
    --mouth-at=31,50 cuts a hole through a face plate at each block, on
    opposite plates, so the mouthpiece enters one face and the bell leaves
    the other. A MOUTH and not a port, and the word was picked so it cannot
    be read as one: --ports replaces a section's rim opening with a face
    opening, which on a loop cuts i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
2026-09-16 The gate sees mouths, and the generator stops misplacing them
    check.py
    - Section checks measure material, outline minus holes. A mouth 0.5mm from
    its plate's edge passed the sliver check because holes were invisible.
    - New: each mouth is over the block it names, on the cheek block order
    gives it, opens onto the airway, one hole per mouth. Placement is found
    from the plate outline and the walk's cells, not from snakeboxvar.
    Proved failing on: 0.5mm edge, end cell, --flat block 34 (was 120/0,
    cut 214mm away), both mouths on one plate, --mouth-at=50,31.
    - One hole rule: bore_split.hosts(), polygon containment, used by cut()
    and check_sheets alike. cut() used bounding boxes; the disa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
2026-09-16 One reading of the design switches per family, and gate rows for what hid
    Walk tools
    - bore_split.take_design_switches() and reset_design(): every switch that
    changes the parts, read once. bore_split, check, regress and nest all use
    it. check.py gains --sheet, --kerf, --play, --notch, --tag; nest.py gains
    all of them and reads walk files.
    - nest.py: nesting the mouthed loop laid out 30 parts with no holes; now 2.
    The Deepnest export writes each part's holes inside it.
    - regress: "closed loop 52, flat, mouth past a plain cap" -- passes now,
    fails 2 checks against the generator before c4c3f54.
    Ribbon tools
    - ribbon_bore.read_flags(): one flag table (it was written out three times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
2026-09-16 The scallop scoops inward: two facets at R41, not one straight chord
    The 800mm scallop's R40 scoop was a single 36 degree facet. Arcs are
    inscribed, so a one-facet scoop between two bulges turns +18 where they
    turned -18, and the centreline ran straight through it: every vertex turned
    0 or -36, and the loop was a rounded decagon with no inward bend.
    Now: 36 degree facets, 5 lobes, a 144 degree bulge of R44.22136 against a
    72 degree scoop of R41 (two facets, a +36 degree turn at each lobe),
    800.0mm, square ports on facets 1 and 14 (13 and 17 facets apart). 18 and
    24 degree facets make panels too short for a square port; from R42 no
    facet takes one. 60 wall panels + 2 cheeks, cheeks 282 x 279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
2026-09-16 Ring cheeks are cut as two closed contours, not one path with a slit
    cheek() joins a ring's outer and inner offsets into one list, which is a
    correct polygon (the two steps across the band coincide and cancel) and a
    wrong cut: written as one path, the laser followed the step and slit the
    cheek across its band and through the airway at the seam. Every ring cheek
    carried it -- both torus variants, the scallop, the racetrack.
    - contours() splits the outline where it returns to its first point
    (within 1e-9: the scallop's seam has no mitre, so its ends agree only to
    rounding); the sheet writes each loop as its own closed path.
    - Rim distances in checks() use the real contour edges, not the s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
2026-09-17 A closed oval with flattened ends, as small as the checks allow
    --shape=oval: half a loop taken twice -- a flat across the long end, an
    end arc, a side arc, an end arc -- closing by 2-fold symmetry. No ports.
    Defaults are the shipped design, the smallest found that passes all 13
    checks with a flat at each end, two facets on every arc, and a long axis
    at least 1.4x the short: 30 degree facets, ends R28 turning 60, sides R95
    turning 60, 13mm flats. 338.7mm centreline, 159 x 123mm cheek, 28 panels.
    The limit is the shortest panel, 10.21mm against 10mm for a tooth.
2026-09-17 The oval's long sides get parallel straights in the middle
    --oval-side-flat splits the side arc in two with a straight between, so
    the two long sides carry segments parallel to each other and to the long
    axis; FACET must then divide half the side turn.
    Re-searched for the smallest with that added (flat at each end, two
    facets per end arc, long axis >= 1.4x short): 30 degree facets, ends R28
    turning 60, sides R72 turning 30 either side of a 12.5mm straight, 12.2mm
    flats. 314.4mm centreline, 148 x 116mm cheek, 32 panels, all 13 checks;
    the shortest panel is 10.09mm against 10. Replaces the 338.7mm oval.
2026-09-17 A stadium oval: tightest half-circles, then parallel straights
    --oval-end-deg=90 is now allowed: the end arcs make a whole half-circle,
    the side arc turns nothing, and --oval-side-flat is the whole side. Refused
    without a side straight (that is a circle).
    Shipped: 45 degree facets, four per half-circle at R21.8, the tightest
    radius every check passes (R21.7 leaves a 9.98mm panel); straights of
    43.6mm, the o's own diameter. 220.7mm centreline, 124 x 79mm cheek,
    20 panels, 13/13. The 314mm oval is unchanged byte for byte.
2026-09-17 Move the stadium oval out to lyre-harp
    ribbon-oval-bore10-45deg-R21.8-straight43.6-221mm now lives outside this
    repository as ~/LaserMadeMusic/GIT/lyre-harp/
    lyre-harp-bore10-45deg-R21.8-straight43.6-221mm-prototype, files renamed to
    match and byte-identical otherwise. Its previews are dropped with it. The
    generator still draws it from the same flags.
2026-09-17 lyre_harp.py: a closed duct whose width changes round the loop
    The lyre-harp frame from the approved drawing, 400mm long: two independent
    closed walls -- a stadium outside, and a string hole with a concentric arch,
    parallel sides and a bump between tangent corners. The duct is 30 x 30mm
    over the arch and down the sides and opens below the hole into the
    resonator, 202mm along the axis. 30mm deep, cheek to cheek, throughout.
    Reuses ribbon_bore's panels, mortices, labels, packer, sheet writer and
    ring contours; adds the two outlines and twelve checks, including the
    duct's narrowest width (30.0000mm) and no cut line through the air. The
    checks were shown to fail with the band 1mm thin and with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
2026-09-17 Lyre-harp: the 2-lead 7-bight knot as a sound hole in the front cheek
    Read from knotwork-soundholes' cut file and placed unchanged, centred on
    the long axis 2/3 of the way up the resonator's air (135.8 of 203.7mm from
    the far end). Front cheek only, so the cheeks are now A (with the knot)
    and B (plain), each cut once. Knot waste cuts with the mortices, crossing
    marks engrave.
    New checks: the sound hole lies over the resonator (36.4mm clear of the
    nearest wall face) and sits where asked (against 2/3 written literally).
    Engraving within half a kerf of a hole's edge is not "in" the hole: the
    knot file ends two marks 0.0007 and 0.0018mm past a waste edge. Both new
    checks and the tolerance were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
2026-09-17 lyre_harp.py --drawing: the review drawing, drawn from the cut geometry
    Replaces the hand-scaled 831mm drawing with one read from build(): cheek
    rims as cut, the air's faces, the knot as placed, and dimensions measured
    off them -- 188 x 400, hole 116, 36mm walls-to-walls over the arch and
    sides, resonator 204, knot centre 135.8mm up (2/3). Upright by a quarter
    turn; a transpose mirrored the knot. Cut files unchanged byte for byte.
2026-09-17 Note that the lyre-harp sketch and the stadium prototype were deleted
2026-09-17 lyre_harp.py --render: the interactive 3D page, from the cut geometry
    Cheeks with the string hole and the knot, and all 49 panels at their own
    position, angle and length, drawn by three.js r128. The page approved as
    an artifact, now generated here and written beside the cut files in
    ~/LaserMadeMusic/GIT/lyre-harp/lyre-harp-bore30-188x400mm/.
2026-09-17 Lyre-harp: a laminated hitch-pin block inside the bottom end
    Six 3mm laminations, 18mm glued up, for hitch pins driven through the
    bottom wall. Each lies against the outer wall's inner face, 30mm wide from
    it, over 8 facets' length centred on the axis: 7 whole facets and a half at
    each end, since the bottom's odd facet count puts one facet on the axis.
    Its own sheet, numbered 1-6, drawn half a kerf oversize.
    Four checks, against 8 and 30 as asked: lies on the wall (1.4e-14mm),
    30.0000mm wide, clear of the sound hole (62mm), 18mm fits the 30mm duct.
    Shown to fail on 7 facets, 25mm wide, 11 layers and 2mm off the wall. The
    cheek and panel sheets are byte-identical to before. The drawing and 3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
2026-09-17 Lyre-harp: hitch-pin drilling marks on the front cheek
    7 pins, 2mm, 16mm apart across the long axis and centred on it, each on the
    hitch block's mid-line 15mm in from the bottom wall, so the row follows the
    curve. Engraved on cheek A as a 2mm circle with a cross, to drill through
    the cheek into the block. Two checks against 7 / 16 / 2 as asked: where the
    pins are, and that each lands in the block (14mm of wood round a pin).
    Shown to fail on 6 pins and 15mm spacing; 30mm spacing is refused as off
    the block. Drawing and 3D page show the pins.
2026-09-20 Lyre-harp: the tuning-pin block at the arch
    6 laminations, 18mm glued up, filling the duct at the arch: both edges are
    the walls' own faces, so it touches the outer wall and the string hole's
    wall with the duct's 30mm between them. It spans 120 degrees, ending at a
    facet midpoint 33.7mm past the outermost pin. Seven tuning pins on the
    band's mid-line, each in line across the instrument with its hitch pin,
    marked on cheek A as a cross -- no circle, since the pin's diameter is the
    builder's choice.
    Six checks: touches both walls (7e-15mm), 30.0000mm across, pins aligned
    within 1e-9mm, runs past the end pins, and the stack fits the duct.
    One lamination_sheet() now writes both blocks. Both span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
2026-09-20 Lyre-harp: cut at a 0.17mm kerf, its finger joints were loose
    The test piece came off the bed loose. lyre_harp.KERF sets ribbon_bore.BURN
    for its own run only: every trumpet design stays at 0.15, since those sheets
    are the record of parts already cut.
    Measured on the sheets: each mortice 2.850 x 5.900 becomes 2.830 x 5.880,
    each panel 63.538 x 36.150 becomes 63.558 x 36.170 -- 0.02mm off the hole
    and 0.02mm onto the tab, 0.04mm of interference a joint. All 25 checks
    pass; the drawing and 3D page are redrawn from the same run.
2026-09-20 Lyre-harp: --test writes an arch test piece, panels 4 to A
    Two cheek sectors and the 15 panels that stand between them: the string
    hole wall's 4-A and the 8 outer panels overlapping the same arc, 105
    degrees of it, with 10mm of rim past the outermost mortice. For trying the
    finger joints at the 0.17mm kerf before cutting a whole frame. It refuses
    to write if a mortice corner falls outside the sector.
    Outer panels are chosen by OVERLAP with the arc: by midpoint dropped the
    two at the ends, which share their joints with the inner run. They are
    also pinned to the arch side, since angles wrap at the resonator end and
    a panel down there read as an arch angle.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
2026-09-20 Lyre-harp: cut at a 0.20mm kerf, still loose at 0.17
    Another 0.03 on the author's instruction after the 0.17 test still came off
    loose. Against the 0.15 the trumpet is cut at that is 0.10mm of interference a
    joint. Confined to this instrument, so the trumpet's as-cut sheets are
    untouched. All 25 checks pass; the five sheets and the arch test piece are
    redrawn, as are the drawing and the 3D page.
2026-09-20 Lyre-harp: kerf back to the measured 0.13, the fit moved to its own constants
    The kerf had been raised 0.15 -> 0.17 -> 0.20 to chase loose finger joints. It
    worked on the joints and quietly cost everything else: an overstated kerf draws
    every outline oversize and every hole undersize, 0.07mm here, the band and the
    duct and the knot cuts with them.
    So KERF = 0.13, the measured beam, and FIT = 0.20 carries the joint on its own.
    Two constants, because along the tooth both halves are drawn and the error pays
    2:1, while across the ply the other half is the plywood and it pays 1:1:
    SLOT_TIGHTEN = FIT - KERF settles the depth, and half the shortfall in width
    comes off the clearance, which goes neg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
2026-09-20 Lyre-harp: --fit=, to walk a test piece up to a friction fit
    The author wants a joint that needs a mallet, found by cutting and feeling
    rather than by calculation, so the fit stops being a source edit. --fit= is the
    kerf the JOINTS are drawn as if cut at; the beam stays at the measured 0.13 and
    no line that is not a joint moves. It refuses a value under the kerf, which
    would loosen the joint in the language of tightening it.
    TIGHTEN and PLAY become tighten() and fit_play(), because a value worked out at
    import would go on answering for the FIT the flag had replaced. The default is
    unchanged and the six sheets redraw byte-identical.
2026-09-20 Lyre-harp: fit 0.20 -> 0.25, and every sheet now records the fit it was cut to
    Tighter, on the author's instruction, walking towards a mallet fit. +0.19mm of
    interference along the tooth and +0.12 across the ply, against +0.09 and +0.07.
    The default moves rather than the flag being passed, so the sheets on disk and
    the number in the source cannot disagree about what is on the bench. For the
    same reason both sheet descriptions now carry the fit beside the kerf: the fit
    is going to change several times and two sheets cut at different ones are
    otherwise identical to look at.
2026-09-21 Lyre-harp: --back-numbers=, the slot numbers for cheek A's back face
    The panels go in while the front plate lies face down, which puts the numbers
    already engraved on it against the table. Engraving lives on whichever face was
    up in the machine and no mirroring moves it through the ply, so this writes the
    numbers alone, mirrored, as a second cut-free pass: cut cheek A as usual, turn
    it over about its LONG axis, lay it back in the same place and engrave. It
    writes its own file and touches none of the cut sheets.
    It works because cheek() is symmetric about that axis -- 49 outline points and
    all 115 mortices have their mirror -- so the plate lands back on its own
    footprint. End for end it does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
2026-09-21 Lyre-harp: --ladder=, the same joint cut at five fits
    Measuring the kerf answers one term of the stack-up. The joint also carries the
    cut's taper, the char on the edge and whatever the ply actually calipers, and a
    strip-and-slice kerf test sees none of those. This cuts the real joint -- the
    two-tooth outer panel, 22 of the 49 -- at FIT 0.15 through 0.27 and lets the
    hand pick. 94 x 225mm, rungs engraved in hundredths since the glyph table is
    hex and has no decimal point.
    ONE PANEL, NOT ONE PER RUNG. panel() reads BURN and TOOTH and nothing else, so
    the tab is identical at every fit and the mortice is the whole variable. Five
    identical panels engraved with five different numbers would have b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
2026-09-24 Rebuild with md2html's theme-button fix for narrow screens
    Below 900px the theme button no longer covers the contents list.
2026-09-24 Lyre-harp: --kerf-test=, measure the machine in the job's own ply
    Two ways of asking on one 140 x 116mm sheet. A control strip and the same
    rectangle sliced ten times: butt the eleven pieces up and kerf is the shortfall
    over ten, so the caliper's own error divides by ten as well. Then a 30mm square
    and the piece that fell out of it, which differ by two kerfs, as a cross-check
    that needs no reassembly.
    The comb is ONE RECTANGLE PLUS OPEN LINES. Drawn as touching rectangles every
    interior edge is cut twice, two kerfs come out where the arithmetic counts one,
    and the answer is half. Two checks refuse that: no duplicated line, and every
    slice a two-point open path. Proved by drawing each line t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
2026-10-06 Elbows are allowed: a turn that cannot fold is cut, not refused
    This is trumpet-elbows-allowed, a copy of trumpet. Trumpet has refused every
    elbow unconditionally since 2026-09-15 (65a57b0, 857ae5d, f2a6385). Here the
    refusal is off by default and --refuse-elbows turns it back on for one run,
    which is how to ask whether a walk would be cuttable in trumpet.
    FOLD_TURNS STAYS ON. Every turn that can fold still folds, so every walk that
    splits bend-only in trumpet splits identically here: switchback's six sheets
    rewrite byte-identical with --refuse-elbows. Only a turn that cannot fold
    becomes an elbow.
    THE WORD IS BACK. The piece kind 'stranded' is 'elbow' again in the cut list,
    in file names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
2026-10-06 Five designs trumpet deleted on 2026-09-15 are back
    meander/first, spiral/expanding, coil/minimal, coil/square-rise1 and
    spiral/telescope: the five that stranded a turn. Three of them also touch
    themselves, and contact is allowed here too.
    FLAT TREE, NOT THE OLD SORTING LEVELS. They were under walk/elbows/<family>/
    <contact|no-contact>/; reverting 65a57b0 would have brought those levels back and
    moved every design since, breaking published paths. They sit in
    walk/<family>/<design> beside everything else.
    REGENERATED, AND PROVED AGAINST WHAT WAS DELETED. first's eight sheets come out
    of today's bore_split.py at the new path byte-identical to 65a57b0^, file names
    included. The other four wer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
    [regress.py]
2026-10-06 Elbows are allowed: a turn that cannot fold is cut, not refused
    elbow unconditionally since 2026-09-15 (b5f3a1f, 0ba437e, c340a32). Here the
    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
2026-10-06 README: 31 designs in the gate, two candidates; the elbow refusal needs its switch
    The gate tally still read 26 designs and 7132 checks, from before the five
    restored designs. regress.py now runs 31 designs, 0 failed, 9152 checks,
    summed from its own output.
    "The next three are candidates" dates from when the coiled trumpet had a
    page. Two candidates sit between the three-turn and the spiral now.
    tools/CLAUDE.md listed a stranded turn among the inputs bore_split.py
    refuses. In this copy it refuses one only under --refuse-elbows: N3 U1 E3
    writes two elbows without the switch and refuses sections 2 and 3 with it.
2026-10-06 bore_split.py: each SnakeBox run writes to a temp file of its own
    cut() wrote every section to /tmp/snakebox_{tag}.svg, a name shared by every
    run on the machine. Two regress.py runs at once -- this repository's and
    trumpet-elbows-not-allowed's -- read each other's sections and failed on part
    counts ("section 5: 2 plates + 6 walls, expected 2 + 2"), and both passed when
    rerun alone. mkstemp gives each call its own name; it is removed after parsing.
    Both suites run together now: 31 and 26 designs, all pass, nothing left in
    the temp directory.
    [bore_split.py]
2026-10-06 Docs: the archived repo in the past tense, and three claims the library outgrew
    trumpet-elbows-not-allowed is archived, so what it refused and required is
    told in the past tense.
    The restored designs filed a fourth family, spiral/, beside coil, meander and
    hilbert; the README named three. A spiral's legs grow every circuit, measured
    from expanding and telescope.
    switchback was "the shortest lattice walk in the repository". coil/minimal is
    also 22 blocks, and coil-10x10x30-0.75t is 11; it is among the shortest. Its
    first command runs from the repository root, not from ../tools as the prose
    said; run from switchback/ it cannot find the file.
    greek-spiral's sheet 1 (1684cm2) was "the largest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
2026-10-06 Thirteen-lens pass: build steps name their files, and four smaller fixes
    Building it: steps 2 and 3 said "cut the bell" and "cut the mouthpiece"
    without a file, and parts/bell/cut-files/ holds two sheets. They name the
    bell-round and mouthpiece sheets in full, and say the adapter is for a port.
    greek-spiral: the heading still called sheet 1 "the biggest in the
    repository" after the body was corrected; closed-loop-52's 1778cm2 sheet is
    bigger. It "nearly fills the bed" -- 592 x 284mm on 600 x 308.
    README: the folding note said "stranded turns" where the rest of the page
    says elbows.
    ends: repro-svg.py is not in this repository; it links to lasermade-tools.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
2026-10-06 Coil figures say which length they are measured at; --help on the round ends
    README: the promoted coils' wins are each coil's full walk, as its why.txt
    measures it; the search compares coils trimmed to a common length, so the same
    coil differs -- 4x4-50 is 20.40 turns/m over its 193 blocks and 20.83 where the
    search compares against it. The second table is said to be the search's.
    Smallest box is coil_3x8_20 tied with coil_3x9_18, both 432.
    bell-round.py and mouthpiece-round.py refused --help as a bare option
    ("--help takes a value"). --help and -h now print the docstring and exit 0,
    drawing nothing. Both shipped sheets rebuild byte-identical.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
2026-10-06 The tight coil: the tightest coil that does not touch itself, with its own page
    N1 W2 U2 E2 N2 D2 ... D2 N1: 65 blocks, 1040mm, 33 sections, six whole turns
    at 32mm a turn, nothing touching, 16 elbows. Every coil-window leg is 2 where a
    bend needs 3; raise them to 3 and the first three turns are the three-turn
    trumpet's walk. A step or a side of 1 instead touches itself (15 and 4 pairs).
    parts/bore/concept/walk/coil/tight/bore: 33 sheets, 164 parts, bore.html, and
    a still from bore_render.py. Gate: 919 checks, 0 failed. Seven elbows
    (6, 10 ... 30) are left open on the inside of the turn, which the page says.
    regress.py: 32 designs, all pass, 10035 checks. repro.py: 103 reproduce.
    tight-coi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
    [bore_split.py, regress.py]
2026-10-06 Tight coil: 42.7mm a turn, not 32; the comparison at six turns
    The coil steps two blocks north every three sides, and three sides are three
    quarters of a turn, so it rises 2 2/3 blocks a turn: 42.7mm. End to end it is
    the same, 16 blocks of axis in six turns. 32mm divided the interior steps by
    whole turns and left the end legs out. The same error put the three-turn
    walk at 48mm a turn at the 16mm block; it is 64.
    The ranking is unchanged: 42.7mm is still the tightest coil that does not
    touch itself; every other is 58.7mm or more end to end.
    "Why it cannot be tighter" compared this six-turn coil with three-turn
    versions of the tighter walks, so its elbow column compared unlike lengths.
    All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
    [regress.py]
2026-10-06 The ziggurat: a centred square spiral that widens a block all round each turn
    N1 W2 U2 E3 N2 D3 W4 U4 N2 E5 D5 W6 N2 U6 E7 D7 N1: 63 blocks, 1008mm, 13
    sections, three turns of 4x4, 6x6 and 8x8 blocks on one centre, 42.7mm a
    turn, nothing touching, 4 elbows. Every other side is a block longer than
    the one before, which keeps it centred; growing all four sides at once grew
    it from a corner.
    parts/bore/concept/walk/spiral/ziggurat/bore: 13 sheets, 76 parts,
    bore.html, and a still. Gate: 395 checks, 0 failed. Sections 5, 8 and 11 are
    open on the inside of the turn. Section 9 is 599.05mm wide, 0.95mm inside the
    bed, which the page says before the cut files.
    The elbows come from the first W2 an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
    [regress.py]
2026-10-06 Remove the ziggurat's page; the design stays
    ziggurat/ is gone, and with it its row in the page table, its line in the
    tree (six page directories again, three candidates), and the links from
    three-turn and tight-coil. The design itself is unchanged: its cut files,
    viewer and walk stay in parts/bore/concept/walk/spiral/ziggurat/ and in
    regress.py, and the elbows-by-choice note now points at its viewer.
2026-10-07 Pack the tight coil's 33 sections onto one P2S bed
    tools/bed_sheets.py places each section file whole and unchanged by maxrects,
    searching packing orders from a fixed seed so the sheet reproduces, and
    re-reads what it wrote: every section once, paths byte-identical, on the bed,
    4mm apart. All 33 fit on one 600 x 308mm sheet.
2026-10-09 swept-curve: CLAUDE.md down to the rules, the reasoning moved to NOTES.md
    CLAUDE.md was 1128 lines, loaded whole into every session working here.
    It is now 177: each rule in a line or two, with the NOTES.md heading that
    explains it in brackets. NOTES.md is the old file unchanged bar a title
    and two lines saying what it is, so nothing is lost; its history follows
    the rename. ribbon_view.py's one pointer into the old file now names
    NOTES.md.
2026-10-09 parts, tools, fold2, fold2-long-straight: CLAUDE.md down to the rules
    The same split as swept-curve. Each CLAUDE.md is now its rules and
    commands, 131 to 144 lines, with the NOTES.md heading that explains each
    rule in brackets; each NOTES.md is the old file unchanged bar a title and
    two lines saying what it is. 1633 lines that loaded into every session
    working in these folders are now 550.
    Everything the code points at is still in CLAUDE.md: the step / hairpin /
    coil table and what the gate cannot see (tools, cited by fold2,
    greek-key and closed-loop-52), and the pinned 1.5t paragraph
    (fold2-long-straight, cited by repro.py).
2026-10-09 Fix fold2's regenerate path, drop stale counts, point swept-curve at the root README
    fold2: the regenerate and gate commands ran from tools/ with D=., so
    --write $D/bore would have written to tools/bore. D is now
    ../parts/bore/concept/walk/coil/fold2, the path regress.py's DESIGNS
    holds; gating the shipped sheets through it gives 196 checks, 0 failed.
    Design and check counts written into prose had drifted apart (25, 31
    and 33 designs; 195 and 196 checks on one bore). They now say "every
    design in DESIGNS" and "the check count the gate prints", which cannot
    go stale. The README's measured 33-design result is left as it is.
    swept-curve has no README of its own; its commands now regenerate an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
2026-10-09 built, greek-key, closed-loop-52: CLAUDE.md trimmed in place
    102, 109 and 40 lines to 64, 66 and 24. Too short to be worth a NOTES.md
    of their own, so every rule, command and table is kept and only the
    prose around them is cut; git history holds the originals. greek-key
    drops its stated check count, as the other docs did in 9b79a02.
2026-10-09 built, greek-key, closed-loop-52: CLAUDE.md trimmed in place
    drops its stated check count, as the other docs did in 24ddad4.
    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
2026-10-09 CLAUDE.md: rebuild pages with rebuild-page.sh
    Six hand-written md2html + doc-audit pairs, each with its own relative
    path to lasermade-tools, become one call to rebuild-page.sh with the
    writeup's folder. parts/ had the same fault swept-curve had: it
    regenerated a README.md that folder does not have. It now rebuilds the
    two writeups it means, the root README and ../ends/. Every command was
    run from its own folder; every page comes back unchanged.
2026-10-12 swept-curve: shapes named double-spiral, ess, three-lobe serpentine, double volute
    Folders and files renamed: dspiral -> double-spiral, wave -> ess,
    opposed -> three-lobe-serpentine-with-collinear-ends, volute ->
    volute/double-volute and volute/single-volute. Removed: the 196mm and
    240mm halftests, the two-port 1000mm page, the 1506mm plain cheek,
    traces/volute.json, and the 20 previews left with no cut file.
    The --shape keywords follow the names, and ribbon_bore.py writes the
    new stems; the shipped sheets' <title>s and the pages' embedded shape
    were brought into line, and every sheet and page reproduces byte for
    byte. NOTES.md and CLAUDE.md say what is gone.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
2026-10-12 Greek spiral photographed press-fit; README claims corrected
    The greek spiral's bore has been cut and press-fit: its photo goes on
    its page, and the README, three-turn page and greek-key notes stop
    saying nothing in concept/ is cut. Its page called the figure
    mirror-symmetric; it has half-turn symmetry, as the photo shows.
    README: the double volute interleaves two arms as the double spiral
    does; "ported at both ends" is the only OPEN design; the nine-design
    count names its shapes by their new names and says the four closed
    shapes are left out; the halftest paragraph goes. F4 is computed for
    the 1.321m tube it was measured on (2.69x and 5.38x), here and on
    the three-turn page. piece_render.p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
2026-10-12 Every build is press-fit, not glued
    The three-turn trumpet, the 1000mm spiral and the greek spiral are all
    press-fit, with shellac filling the air gaps. Pages, notes and build
    steps that called them glued, or said the ends and ring stacks glue on,
    now say press-fit, seat or stack. The elbow notes keep "butt-glued":
    that is the reason a stranded turn is costly, not a claim about a build.
2026-10-12 Spiral photo renamed glued-up -> press-fit
    The 1000mm spiral is press-fit, so its photo's name says so. Both
    copies renamed; the spiral's page and the swept-curve notes follow.
2026-10-12 Fix the four review findings
    - ribbon-spiral: the "report only" command now passes --no-write
    (it wrote two SVGs beside the generator) and says it runs from the
    repository root, as its write command already did.
    - greek-spiral, three-turn: "the generator lives in ../tools" said
    the commands run from the page's folder; they run from the root.
    - bore_split.py: the cut-list heading no longer says "every part
    engraved" for a one-section bore, which engraves nothing.
    - coil search: plate areas written 2881mm², matching the root README,
    fixed in gen_readme.js and regenerated.
2026-10-12 tools/NOTES: elbows are butt-joined, not glued
    Builds are press-fit; the elbow's difficulty is the flat-to-flat joint.
2026-10-12 Bell and mouthpiece are glued; hub embed retired
    Ring stacks cannot be press-fit, so the bell, the mouthpiece and each
    end's joint to the bore are glued; the bore stays press-fit. The
    swept-curve notes no longer describe a hub embed that is gone.
2026-10-13 Previews on a white ground (#ffffff), not cream
    Only the ground rect changed; make-preview.py now draws white.
2026-10-13 lyre_harp.py --drawing: wrap the notes to the sheet
    Each note was one line of text, and the longest ran well past the viewBox's
    right edge, so a browser cut them off mid-word. They now wrap to the sheet's
    width and the sheet grows to hold them.
2026-10-14 Viewers follow the site's theme button; the dark-only ones get a light palette
2026-10-14 Every block page shows the mouthpiece at IN and the bell at OUT
    viewer.py embeds both ring stacks, read from their cut files by
    parts/part-view.py, and the page seats each on its end face; a button takes
    them off. All 35 pages carry them, patched with the generator's own text and
    checked against a regeneration of tools/examples.
2026-10-15 Coil walks end on north: the bell faces forward
    Every coil walk, the ten in search/ and the four promoted, is cut back to its
    last north term rather than extended (1 to 11 blocks). The search is re-run
    end to end (standardise, reduce, 10 x check.py, parts, scoring, README) and the
    pages, check transcripts and measured blocks redrawn. Names keep the old axis
    length, one block more than now, and say so. gen_readme.js's shared-wall
    sentence now handles a smallest box with no shared wall, which compared a coil
    with itself.
2026-10-19 Bed is 600 x 305mm, cut-tested; the tight coil keeps its one sheet
    The largest rectangle the xTool P2S cut, tested 2026-10-19, is 600 x 305mm,
    not the 600 x 308 assumed here until now. The tight coil's one-sheet pack ends at
    302.2mm, so it is kept with its canvas trimmed to 305; bed_sheets.py now
    writes two sheets for it, and the README says so.
2026-10-20 Viewers: pan with two fingers too, zoom toward the pointer, double-click a block to turn round it
    viewer.py, part-view.py and mcwalk.py; the 34 walk pages and the bell and
    mouthpiece pages carry the new script, each the same as a fresh run.
2026-10-22 Link back to all projects at the top of the README and the page
    The rest of the build files now points at lasermademusic.html, where the
    instruments moved when the root page became a directory.
2026-10-22 Coil search: the README generator points the rest of the build files at lasermademusic.html
    The README is generated, so the link edited into it was reverted by the
    next build; the source now carries it.
2026-10-23 viewer.py: an ?embed mode; the page opens with the built trumpet bare
    ?embed hides the floating rails (title, controls, blocks, legend), which
    the writeup carries, leaving the model. Regenerated: the built coil's page
    through bore_split.py (byte-identical before the change), and every page
    the .repro files cover.
2026-10-23 Every trumpet page opens with its 3D view
    three-turn, switchback, tight-coil and greek-spiral frame their bore's viewer
    at the top, and ends frames the bell and the mouthpiece side by side.
    part-view.py gains the ?embed mode viewer.py has; the three bore pages are
    regenerated through bore_split.py and differ by the ?embed lines alone.
2026-11-02 Coil search tools: Node to Rust
    The twelve tools in coil/search/tools/ become a Cargo crate: one front end per
    tool in tools/*.rs, the shared code in src/ (metrics, standardise, minimal,
    reduce, score, iterate, table, the bore_split.py bridge, and jsfmt/json so
    numbers and JSON come out as Node wrote them). build.sh builds it first.
    Checked against Node on 47 runs (every tool, every flag, touch weights 1, 2.5,
    5 and 8, the spiral search): parts.json, standardised.json, reduced.json,
    cands.json and every printed table are byte-identical. README.md and
    SCORING.md change only where they name the tools: .rs file names, the
    target/release commands, and a new section listing src/. The full run ta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
2026-11-07 Call lasermade-tools' Rust programs, not its Python scripts
    The tools became Rust on 2026-11-07: target/release/<name> in lasermade-tools
    (cargo build --release there) replaces python3 <name>.py, in commands,
    manifests and prose. Pages rebuilt; no generated file changes otherwise.
2026-11-08 STEP files of the 3D view, for a CAD program
    The bell and mouthpiece in parts/*/step/, one solid body per ply, written from the
    3D page by lasermade-tools step-export and checked by .repro. Every file
    opens in SolidCraft with every body closed and no warnings.
2026-11-08 The bore toolchain in Rust; the Python and the Boxes.py venv go
    bore_split, check, viewer, bore_render, regress, repro, coils, sizes,
    hilbert, mcwalk, nest, bed_sheets and piece_render are programs in
    target/release/, from sources in tools/. snakebox.rs is snakeboxvar.py and
    the Boxes.py it drew through (GPL-3.0-or-later, like check.rs and
    piece_render.rs); no Boxes.py checkout is needed any more.
    Every sheet, page and report is byte-identical to the Python's: 389 sheets
    over 37 designs, 40 check runs, all 32 regress designs, 113 reproduced
    sheets, the viewer, nest and bed sheet pages. Two exceptions: a bed sheet's
    description names bed_sheets.rs, and a --ports sheet starts its path at a
    di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
2026-11-08 Every bore page's bore as a parametric SolidCraft design, with its STEP
    viewer PAGE --solidcraft FILE (tools/solidcraft_design.rs) writes one body per
    piece, its blocks joined and the square airway cut through, every corner a
    whole number of half blocks and half straights from the mouth, so bore, ply and
    the stretched lattice's straight drive the whole bore. It refuses unless its
    blocks are the page's. Twenty designs: every piece the volume of its blocks
    less its airway, no overlaps, the airway the page's length times the bore's
    square, and bore 12 matches --bore=12 piece for piece.
2026-11-08 Bell and mouthpiece as parametric SolidCraft designs; their STEPs built by SolidCraft
    bell-round and mouthpiece-round take --solidcraft=FILE: every ring's size is
    the generator's own chain of steps as expressions, max() included, over the
    bell's bore, length, mouth, gamma, lap, overhang, ply and wall, and the
    mouthpiece's bore, throat, rim, power, seat and ply; rings_solidcraft.rs draws
    the stack as true rounded squares, one body per ply. Every ring's outside
    matches its cut file, and the retuned bell (150 mm, mouth 90, gamma 0.8) and
    mouthpiece (rim 18, power 2.5, seat 1.2) match the generator ply for ply.
2026-11-08 The adapter is for a 7 x 14 port; a square port takes the bell directly
    The built spiral was cut with --port-square, a 10 mm square port the bell
    seats on with no adapter. The README, the ends page, parts' NOTES and CLAUDE
    and bell-adapter's help said every ported bore needed it.
2026-11-09 SolidCraft bores: the cut parts, finger joints and all
    Each of the twenty bore designs was one solid body per piece, blocks less
    airway, with no joints. Now every piece is its face plates and side walls as
    snakebox cuts them (burn 0): fingers, slots, pins and slots, laps, flats,
    placed in 3D, one body each. snakebox gains render_local(), which reads each
    part back in its own frame; the sheets it draws are unchanged (repro: 113
    reproduce). Points are sums of bore, ply, straight and the pin's numbers,
    fitted by nudging each parameter and checked against a third draw with all
    of them moved.
2026-11-09 snakebox: draw a short plain plate border straight, not as a 0.93 mm stub
    polygonWall takes 3 mm off each edge at an inside corner; a plain border
    2 mm long had -1 mm left, so the path went back 1 mm and forward 3, and the
    laser cut the stub that left. 320 stubs on 103 live sheets, two per face
    plate; each sheet's only change is that vertex removed. The six pinned
    coil-10x10x30-1.5t sheets record cut wood and keep theirs. Found by the
    SolidCraft round trip (sc-flatten --redraw-all, then sc-compare).
2026-11-09 snakebox: straighten a border only past 0.1 mm of overlap
    Changing the rule exactly at zero overlap broke the SolidCraft designs'
    linear fit, which nudges every size: borders exactly as long as their
    corner allowance are common. Sheets and designs are unchanged.
2026-11-10 The last stubs: square-rise3's sheets and the tight coil's bed sheet
    The stub fix redrew what repro redraws. square-rise3 (not in repro) kept
    16 stubs on four sheets, now byte for byte bore_split's drawing of its
    page's walk; the tight coil's one-sheet bed layout, packed by the old
    bed_sheets.py, kept 64, and only those vertices are removed (today's
    packing differs, so it is not redrawn). Both now round-trip through
    SolidCraft (sc-flatten --redraw-all, sc-compare) within 0.002 mm. Only
    the pinned coil-10x10x30-1.5t sheets keep theirs.
2026-11-11 SolidCraft bore designs: finger counts follow the sizes
    snakebox draws every finger edge straight for the design and records it,
    so no outline depends on how many fingers fit. Each finger edge is one
    finger or slot box patterned along it, its count, width and first offset
    written as Boxes' calcFingers at the edge's length (floor()/min()/max()
    expressions of block, straight and ply). check_fingers holds them to
    snakebox's own at the defaults and at six sizes away from them.
    Fingers stand 1 mm proud of both faces and two cuts trim each part back:
    a flush join failed on the expanding spiral at a 16 mm bore.
    All twenty designs rebuilt: at the defaults every part matches the old
    design (volume,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
2026-11-12 SolidCraft bore designs: the ply follows
    The ply and the pin's length are both 3 mm at the defaults, so the step
    beside each pin is zero long there and the 0.001 mm nudge never showed it:
    one corner beside each pin was fitted to the ply, not the pin. The two are
    nudged 0.05 mm now, and check_far holds every point against snakebox with
    the ply 0.3 mm and the pin 0.5 mm off. All twenty, built at 2.7 and 3.3 mm
    ply, match the design drawn fresh at that ply; STEP files unchanged.
2026-11-12 The nine concept walks get cut files, drawn by bore_split
    spiral/expanding, spiral/telescope, coil/minimal, coil/square-rise1, coil/three-side and the four search coils (2x2-134, 3x3-54, 4x4-50, 5x5-50): 251 sheets, every design now in tools/designs.rs so repro redraws them and regress checks them (37 designs, 16805 checks, 0 failed). Each SolidCraft design round-trips to its sheets within 0.004 mm. The minimal coil's piece 19 keeps its known tongue collision; the README says not to cut it as drawn.
2026-11-12 1.5-turn coil: the as-cut record moves to as-cut/, cut-files/ is redrawn
    Its cut-files/ held the sheets the wood was cut from (0.1 mm kerf, zero-width stubs), pinned by hash, so the folder had no sheet anyone should cut and its SolidCraft design could not round-trip (0.905 mm). The six sheets move unchanged to as-cut/, still pinned (as-built.sha256 paths only); repro now holds the pins there and redraws cut-files/ like every other folder, as built/coil-fold2-long-straight-3t has since 2026-09-13. Design round trip 0.0025 mm.
