Gernreich/trumpet-elbows-allowed/(notices)

Notices in the files:
tools/snakebox.rs:
A copy is in tools/LICENSE.GPL-3.0.txt.
tools/check.rs:
This program is free software: you can redistribute it and/or modify
it under the terms of the GNU General Public License as published by
the Free Software Foundation, either version 3 of the License, or
(at your option) any later version.
